ThePil0t/heichips26-FAIfplus/macros/heichips26_FAIf/macros/analogue_interface/README.md

# analogue_interface: analog hard macro (ihp-sg13cmos5l)

<p align="center">
  <a href="final/render/analogue_interface_white.png">
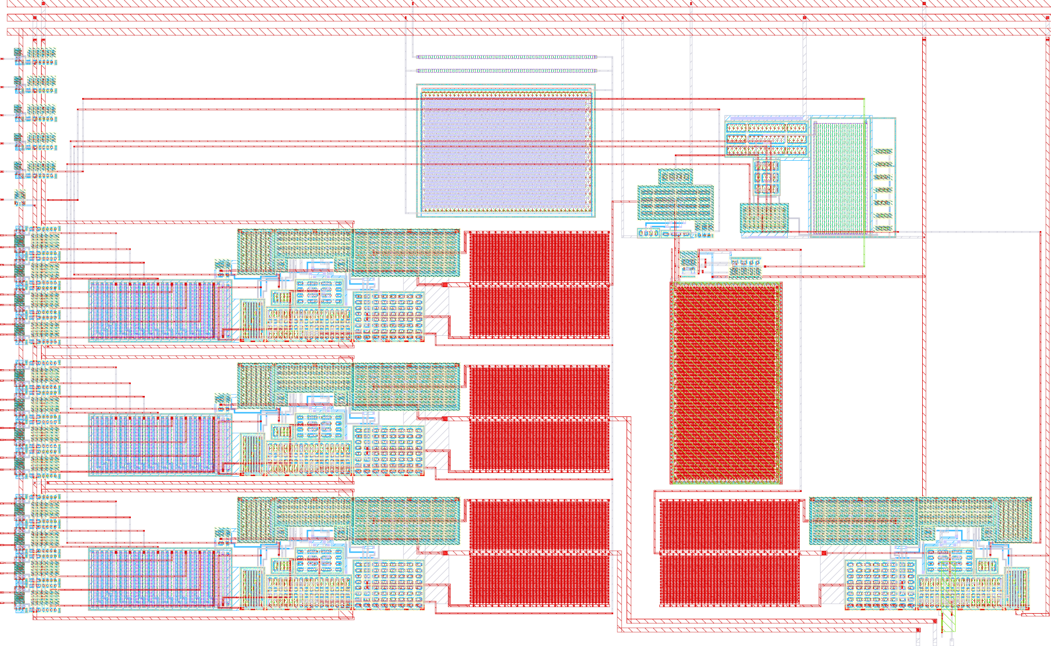
[picture p1: macros/heichips26_FAIf/macros/analogue_interface/final/render/analogue_interface_white.png]
Render of the dry-run analogue_interface macro
    
  </a>
  <br>
  <em>Render of the dry-run macro. The render shows mask layers only, so the dummies (outline + text) are not visible.</em>
</p>

This is the analog hard macro that `heichips26_FAIf` instantiates as `analogue_interface`.

- The analog blocks of [`heichips26_FAIf.sch`](../../schematic/xschem/heichips26_FAIf.sch) are placed with their GDS as it is.
- The iVREF divider (R1, R2, C1) is generated from the PDK PCells.
- **Fully routed** (see [Routing](#routing)): DAC path, ADC path, PTAT, level translators and supplies. The macro KLayout LVS against the generated reference schematic matches.

Everything is generated by [`scripts/build_analogue_interface.py`](scripts/build_analogue_interface.py) from one placement and pin table. Do not edit the GDS by hand; change the table and rebuild. The plan behind this macro is [`analogue_interface_dummy_PLAN.md`](../../../../analogue_interface_dummy_PLAN.md).

## Build

```sh
nix-shell
export PDK_ROOT=$(pwd)/IHP-Open-PDK && export PDK=ihp-sg13cmos5l
make -C macros/heichips26_FAIf/macros/analogue_interface build-top
```

| Target | Output |
|---|---|
| `layout` | `layout/analogue_interface.gds`, `final/lef/`, `final/vh/` (Verilog blackbox header), `final/lib/` (timing-free Liberty) |
| `copy-gds` | `final/gds/analogue_interface.gds` |
| `render-gds` | `final/render/*.png` |
| `build-top` | all of the above |
| `klayout-drc` | `verification/drc/` (KLayout DRC, `DRC_LEVEL=macro` by default) |
| `reference-schematic` | regenerates `schematic/xschem/analogue_interface.sch/.sym` (LVS reference) from the top schematic |
| `klayout-lvs` | `verification/lvs/` (KLayout LVS against the reference schematic) |

`layout` and `reference-schematic` need `PDK_ROOT` and `PDK` (the divider PCells come from the PDK library).

The script stops with an error if a block leaves the macro, two blocks are closer than 3 µm, anything is drawn above Metal3, a pin label cannot be found, a route comes too close to block metal or another net, or a routed net is split or shorted (metal-only connectivity check).

## Geometry

- **Size:** 300 × 185 µm, 1 nm dbu, `prBoundary` at (0,0)–(300,185).
- **Layers:** Metal1–Metal3, with one exception: the **Metal4 lid (VSS) over the hold cap of `sah_12bit`** (x10) and its Via3 rows. Otherwise there is no Via3/Metal4/TopMetal1, so the top-level Metal4 PDN straps can run across the macro.
  - The build script allows Via3/Metal4 only inside the lid. The Metal4 PDN strap groups over the macro sit at x 172.38–179.38, 222.38–229.38 and 272.38–279.38 (measured in `final/gds/heichips26_FAIf.gds`, 2026-10-08).
  - LibreLane removes every Metal4 strap within `PDN_HORIZONTAL_HALO` = 10 µm of a Metal4 obstruction. The script therefore asserts that the lid's obstruction (lid + 1 µm) is ≥ 10.5 µm from the **west group (172.38–179.38), which stays intact**. Today it is 10.5 µm (obstruction at x 189.88).
  - The east group (222.38–229.38) is cut over the S&H; the lid keeps the ≥ 0.6 µm Metal4 spacing to it.
  - The LEF obstructs Metal1–Metal3 over the whole macro except the pins, and Metal4 over the lid + 1 µm. The rest of Metal4 is not obstructed.
- **Cell names:** every subcell is prefixed `heichips26_FAIf_` for chip-level uniqueness. This also removes the leading digit of `555_comparator`. The top cell is `analogue_interface`, the module name used in `rtl/heichips26_FAIf.sv`.
- **Location in `heichips26_FAIf`:** (190, 8.82), orientation N (`DIE_LOCATION` in the build script). The macro then covers die x 190–490 and y 8.82–193.82, and leaves x < 180 (after the 10 µm horizontal macro halo) for the digital logic.
  - **x = 190:** only at this x are `analog_0..2` directly above the die pins of `heichips26_template_small_analog` (x = 450.24 / 455.04 / 459.84).
  - **y = 8.82:** this keeps the bottom cell row (y 3.78–7.56) free, together with `FP_MACRO_VERTICAL_HALO: 1` and `PDN_VERTICAL_HALO: 1`. That row's power rails are the only link between the Metal4 straps over the macro and the rest of the power grid. 8.82 is a multiple of 0.42 µm, so the west-edge pins stay on the Metal3 tracks.

```
y=185 ┌─────────────────────────────────────────────────────────────────────┐
      │ VAPWR / VGND / VPWR pin straps (Metal3, x 2–298)                    │
  172 ├──────┬───────────────────────────────────┬──────────────────────────┤
      │ 4×LT │                                   │          PTAT x3 (MX)    │
      │ x9 LT│              R1/R2/C1 (iVREF)     │  x1 comp                 │
  124 │ x2 ↓ │                                   │──────────────────────────│
      │LT8 x6│ R2R DAC x4 (SAR DAC)              │ S&H sah_12bit x10        │
   86 │LT8 x7│ R2R DAC x5 (DAC0 → analog_1)      │                          │
   48 │LT8x12│ R2R DAC x11 (DAC1 → analog_0)     │ opamp x8 (mirrored)      │
   10 │      │                                   │                          │
    0 └──────┴───────────────────────────────────┴───────────▲▲▲──────────┘
       west edge: digital pins (Metal3)          analog_0/1/2 (Metal2)
```

Why the blocks sit where they do:
- **West column:** all level translators face the digital logic, so the VPWR domain stays in this one column.
- **DAC rows:** each 8× translator is rotated R90 next to its DAC row, with its LIN inputs facing west and its nLOUT outputs facing the DAC's nD inputs.
- **East column:** the ADC front end sits next to the analog pins. The opamp is mirrored so its IOAP input is directly above `analog_0..2`.
- **Comparator:** at y 115.5, as close to the SAR DAC as its strap slot allows (7.8 µm from x4), with INN straight above the S&H's SH_OUT spine. It sits 3 µm above the S&H top (y 112.5).
- **S&H (x10):** between the opamp and the comparator. The hold cap sits in the strap slot x 179.4–222.4, 10.5 µm from the west strap group. The switch (TG) sits on top of the cap, east of the SH_OUT spine, with room for a T-switch next to it; the gate driver runs east of that. SH_IN leaves on the east edge, away from the DAC routes on the west.
- **PTAT (x3):** east of the comparator at y 115.5, mirrored (MX) so its outputs (CSOUT1–4, PBIAS) face down, next to the comparator's PBIAS. iIREF2–4 run west to the DACs, iIREF1 down to the opamp (ADC round).

## Blocks

Coordinates are macro-local in µm and give the lower-left corner of each placed block.

| Inst | Part | Source layout | Orient | Lower-left | Size (µm) | Status |
|---|---|---|---|---|---|---|
| x12, x7, x6 | 8x inverting level translator | `../8x_inverting_digital_level_translator/layout/8x_inverting_digital_level_translator.gds` | R90 | (4, 9.35), (4, 47.35), (4, 85.35) | 13.145 × 33.61 | KLayout DRC/LVS clean (cell) |
| x11, x5, x4 | R2R DAC with output opamp | `../r2r_dac/layout/r2r_dac.gds` | R0 | (25, 10), (25, 48), (25, 86) | 147.82 × 32.315 | KLayout DRC/LVS clean (cell) |
| x3 | PTAT current source | `../ptat_current_source/layout/ptat_curr_gen.gds` | MX | (205.43, 115.5) | 48.58 × 34.80 | KLayout DRC/LVS clean (cell); not routed yet (with the ADC round) |
| x2 | down translator (`adc_comp`) | `../down_digital_translator/layout/down_digital_translator.gds` | MY | (4, 124.5) | 3.24 × 4.90 | layout, unverified |
| x9 | level translator (`adc_hold`) | `../digital_level_translator/layout/digital_level_translator.gds` | R0 | (4, 132.4) | 12.12 × 5.05 | layout, unverified |
| xcap0–3 | level translator (`sh_cap_en[0..3]`) | same as x9 | R0 | (4, 140.45 / 148.5 / 156.55 / 164.6) | 12.12 × 5.05 | **not in the top schematic yet** |
| x8 | opamp (S&H input buffer) | `../opamp/layout/op_amp_ver_2.gds` | MY | (187, 10) | 105.66 × 32.29 | layout, unverified |
| x10 | sample-and-hold `sah_12bit` | `../sah_12bit/layout/sah_12bit.gds` | R0 | (179.2, 45.5) | 43.0 × 67.0 | layout, DRC/LVS clean (cell) |
| x1 | comparator | `../comparator/layout/555_comparator.gds` | R0 | (180.63, 115.5) | 21.80 × 19.81 | layout, DRC/LVS clean |
| R1, R2 | rhigh w=0.5 µm l=50 µm b=0 (≈ 148 kΩ), PDK PCell | generated (`macro_routing.make_divider_cells`) | R90 | (118, 166.4), (118, 162.5) | 51.22 × 0.90 | routed |
| C1 + C2 | iVREF filter block: MOM cap C1 (cap_cmomi, Metal1–Metal2, w 31.79 × l 47.16 µm as extracted, ≈ 0.75 pF) on top of the HV NMOS cap C2 (sg13_hv_nmos W 33.5 × L 48 µm, G = iVREF, S/D/B = VGND, ≈ 8 pF), p-tap ring (VGND); Metal3 above stays free | generated (`macro_routing.make_divider_cells`) | R0 | (118, 121.4) | 50.8 × 37.9 | routed |

The divider devices come from the PDK PCell library (`SG13_dev`, loaded through `sg13cmos5l_pycell_lib`), converted to static, flattened cells. C1 is only ≈ 45 fF with the schematic values; check whether that is enough filtering for iVREF.

xcap0–3 are needed because the trimmed S&H's `cap_en` runs in the 3.3 V domain, while every digital-side pin of the macro is in the 1.2 V domain.

The r2r_dac GDS carries a TopMetal1 text label (`ODACOUT`, 126/25). The build script strips it, because TopMetal1 must stay empty.

## ADC front end: opamp x8 → S&H x10 → comparator x1

| Net | From | To | Route (macro) |
|---|---|---|---|
| SH_IN | opamp OOA, west end of its Metal3 strip (187.01, 26.3) | S&H pin `SH_IN`, east edge (222.2, 112.25) | Metal3 0.4 µm west of the opamp up to y 43.9, east under the S&H (y 43.9), Metal2 riser at x 227, Metal3 into the pin. The opamp loop OOA → IOAM is closed on Metal3 inside x8 |
| SH_OUT (hold node, `iSAR_AN`) | S&H pin `SH_OUT`, top edge (191.43, 112.5) | comparator INN, Metal3 pad (191.43, 125.2) | 12.7 µm straight up on Metal3 (9.7 µm of it inside the comparator) |
| VSS | S&H pin `VSS`, top edge (192.43, 112.5) | comparator GNDA (south edge, Metal1, y 115.54–116.32) | 3 µm hop up next to SH_OUT, then to VGND |
| iSAR_DAC | x4 ODACOUT, east edge (172.82, 102.3) | comparator INP, Metal3 pad (191.53, 125.87) | Metal3 x 173.4–173.8 up to y 125.87, then east into INP |
| SH_EN | x9 LOUT (13.09, 134.42, Metal2) | S&H pin `SH_EN`, inside the cell (216.9, 107.5), Metal3 | Metal2/Metal3 east to x 23.5, Metal2 up, Metal3 east at y 155, **Metal4 down at x 245**, Metal3 west into the pin. It crosses SH_IN once at right angles (Metal3 over Metal2, x 227) |
| VDD | S&H pin `VDD`, inside the cell (202.0, 104.6), Metal3 | VAPWR | Metal3 east at y 104.6 to the east VAPWR trunk (x 262); crosses SH_IN at right angles |

Routing rules (see `../sah_12bit/README.md`):
- SH_OUT is a direct Metal3 hop to INN; nothing runs alongside it except the VSS hop.
- iSAR_DAC splits the channel x 172.82–179.2 from the DAC edge (y 102.3) up to the comparator. So SH_EN comes in from the south through the x5/x4 corridor and never crosses iSAR_DAC.
- SH_IN, SH_OUT, SH_EN and iSAR_DAC don't cross anywhere. SH_IN enters from the east, so the DAC routes (analog_1 at x 178.3, analog_0 at x 175.6) stay ≈ 44 µm away from it.
- The comparator OUT (SE corner) is routed east and north around the comparator, never west across iSAR_DAC or along the SH_OUT hop.
- No routing over the S&H on Metal1–Metal3 (LEF obstruction) or over its lid on Metal4 (LEF obstruction).

## Routing

All routes are generated by [`scripts/macro_routing.py`](scripts/macro_routing.py) from the pin labels of the placed blocks, into the cell `heichips26_FAIf_routing`. Signals use Metal2/Metal3 (0.30 µm, 0.19 µm vias with 0.30 µm pads). The builder runs two checks before it writes the GDS: a clearance check of every route against the block metal and between nets, and a metal-only connectivity check (every routed net is one Metal1–Metal3 island, no two routed nets touch).

| Net | Route |
|---|---|
| `dac_out[15:0]` | Metal3 stub from the west pin to LINk of x12/x7, Via2 down |
| translator → DAC bits | Via2 at nLOUTk, Metal3 east along the nLOUT row; bits 0–3 drop on Metal2 onto the nD pad stack, bits 4–7 go up on Metal3 (staircase, no crossings) |
| iVREF | R1/R2/C1 east ends → Metal2 trunk at x 173.6 → along the row gap under x11/x5/x4 on Metal3 → into the R2R at x ≈ 123.5 (between the opamp POAVSS rail end and the output stage) → west at R2R + 2.5 → up onto IDACVTAP |
| `analog_1` / `analog_0` | Metal3, 1.2 µm, from the opamp OOA bar at the R2R east edge: down at x 178.3 / 175.6, east at y 7.0 / 4.5, Via2 array + Metal2 onto the south pins |
| IDACDISABLE (x11, x5) | Metal3 west to x 61.9, down, onto the opamp POAVSS rail (VGND) |
| VPWR / VGND / VAPWR | Metal3 trunks continue the translator supply bars (x 5.35–6.46 / 9.29–10.40 / 11.70–12.81) up to the straps; VGND and VAPWR cross the lower straps on Metal2. Metal3 rails in the row gaps feed the R2R opamp rails (x11, x5, x4); VGND hops under the VAPWR trunk on Metal2 |
| R1 / R2 / C1 | west ends: Metal2 risers to VAPWR (x 117) and VGND (x 115) |

Round 2 (ADC path, PTAT, small translators, supplies; `route_rest`):

| Net | Route |
|---|---|
| `adc_ref`, x6 → x4 bits, x4 IDACDISABLE | same pattern as the DAC pairs |
| iSAR_DAC, SH_OUT, VSS, SH_IN, SH_EN, S&H VDD | see the ADC front-end table above |
| analog_2 → x8 IOAP (ADC input) | Metal3 straight down from IOAP through a gap in the opamp's bottom VGND Metal3 rail (x 266.85–271.49, cut in the macro's copy of the opamp; both halves stay VGND through the opamp), Via2 at y ≈ 9, Metal2 into the pin. Guarded by a VGND Metal2/Metal3 strap at x 267.06 (towards analog_1, tied to the opamp's VGND Metal2) and a vertical VGND Metal4 shield (x 266.91–270.84, y 4.04–23.9) |
| iIREF1 (CSOUT1) → x8 IOAIREF | Metal3 down to y 117.3, Metal2 east outside the PTAT, Metal3 down the east edge (x 295) and west at opamp bottom + 19.2 into IOAIREF |
| iIREF2/3/4 (CSOUT2/3/4) → IDACIREF of x4/x5/x11 | Metal3 west at y 141.5 / 143 / 136.5, Metal2 down the west channel (x 21 / 20 / 19), Metal3 east at R2R + 19.2 |
| iPBIAS | PTAT PBIAS → Metal3 at y 139 → Metal2 drop onto the comparator PBIAS |
| iSAR_COMP | comparator OUT → Metal2 north in the gap to the PTAT (x 203.9) → Metal3 west at y 152 → x2 DIN |
| `adc_comp`, `adc_hold`, `sh_cap_en[3:0]` | Metal2 stubs from the west pins (the LIN pins sit under the VPWR trunk) |
| small translators (x2, x9, xcap0–3) supplies | Metal1 taps with via stacks onto the west trunks |
| comparator VCCA / GNDA | Metal2 risers to the VAPWR strap (at the VCCA pin) and the VGND strap (x 176.5); the S&H VSS hops onto GNDA |
| east supplies | VAPWR trunk (Metal3, x 262): S&H VDD, PTAT PCSVDD, opamp POAVDD; VGND trunk (Metal3, x 297): opamp POAVSS and IOADISABLE; PTAT PCSVSS Metal2 riser down to the VGND strap |

**Metal4:** only vertical routes, off the S&H lid, with the lid's strap rules: ≥ 0.6 µm from every PDN Metal4 strap and ≥ 10.5 µm (obstruction incl. halo) from the strap group at x 172.38–179.38, which must stay intact (LibreLane removes straps within 10 µm of a Metal4 obstruction). Users: SH_EN (x 245) and the analog_2 shield (x 266.91–270.84, 1.5 µm from the strap group at x 272.38, which LibreLane may therefore cut near the macro bottom). The builder asserts this and adds each Metal4 route (+ 1 µm) to the LEF obstruction.

**LVS:** the reference schematic [`schematic/xschem/analogue_interface.sch`](schematic/xschem/analogue_interface.sch) is generated by [`scripts/gen_reference_schematic.py`](scripts/gen_reference_schematic.py) from the analog part of the top schematic (x1–x12, R1, R2, C1, C2, plus the spares xcap0–3), with the nets renamed to the macro ports. `make klayout-lvs` matches (sign-off check for the macro).

## Pins

| Pin | Dir | Layer / edge | Connects to (once routed) |
|---|---|---|---|
| `adc_ref[7:0]` | in | Metal3, west | LIN0–7 of x6 → SAR DAC x4 |
| `adc_hold` | in | Metal3, west | LIN of x9 → S&H `SH_EN` |
| `adc_comp` | out | Metal3, west | DOUT of x2 ← comparator x1 |
| `dac_out[7:0]` | in | Metal3, west | LIN0–7 of x7 → DAC0 x5 |
| `dac_out[15:8]` | in | Metal3, west | LIN0–7 of x12 → DAC1 x11 |
| `sh_cap_en[3:0]` | in | Metal3, west | LIN of xcap0–3 → S&H `cap_en[3:0]` |
| `analog_0` | inout | Metal2, south, x 259.74–260.74 | DAC1 x11 output |
| `analog_1` | inout | Metal2, south, x 264.54–265.54 | DAC0 x5 output |
| `analog_2` | inout | Metal2, south, x 269.34–270.34 | opamp x8 IOAP (ADC input) |
| `VPWR` | power | Metal3 strap, y 173–175 | 1.2 V, level translators |
| `VGND` | ground | Metal3 strap, y 177–179 | all blocks |
| `VAPWR` | power | Metal3 strap, y 181–183 | 3.3 V, analog blocks |

Each west-edge pin is 1.0 × 0.4 µm and sits at the height of the block input or output it will connect to. All pins are drawn on drawing, pin and text datatypes (e.g. 30/0, 30/2, 30/25), as in the template floorplans.

The LEF declares `USE POWER` for VPWR and VAPWR and `USE GROUND` for VGND. The Liberty has no timing arcs; it defines `voltage_map` VPWR 1.2 V, VAPWR 3.3 V and VGND 0 V.

## Known issues (not fixed in this version)

- **PTAT:** the GDS predates `ptat_curr_gen_mod1`. It has `CSSTARTUP`, but no `CSOUT4` and no `PBIAS`, and the GDS cell is named `ptat_curr_gen`. The symbol `ptat_curr_gen_mod1.sym` also declares `CSOUT3` twice, which shorts iIREF3 and iIREF4 in the top schematic.
- **Verification:** no block has an LVS result, and only r2r_dac has DRC reports. In r2r_dac the `IDACIREF` label is missing.
- **DRC (`make klayout-drc DRC_LEVEL=macro`, 2026-10-04): 12 errors, all inside existing blocks.** None come from the placement, the pins or the dummies.
  - `CMOS5L.FORB.nBuLay` ×8 in `ptat_curr_gen`: the PTAT draws an nBuLay ring (32/0) around x 5.6–18.2, y 24.9–33.2, and nBuLay is forbidden in the CMOS5L stack. This has to be fixed in the PTAT layout.
  - `Act.b` ×4 in `down_digital_translator`: Activ space below 0.21 µm near y 3.8–3.9.
- **Schematic:** the top schematic still uses the untrimmed `sample_and_hold.sym` and has no translators for `cap_en`.
- **RTL:** `rtl/heichips26_FAIf.sv` ties `sh_cap_en` to `4'b0000` until the config register exists.
- **Location-dependent pins:** the analog pins only line up with the die pins, and the west-edge pins only sit on the Metal3 tracks, at location (190, 8.82). Change `DIE_LOCATION` and rebuild if the macro moves.
- **Metal4:** apart from the `sah_12bit` lid, SH_EN and the analog_2 shield (obstructed), it is not obstructed, so top-level signal routes may cross the analog blocks. The Metal4 keep-out plan is still open (TAPEOUT_PLAN §5.4).

## LibreLane integration

The macro is used in `../../flow/librelane/config.yaml`:
- `FP_DEF_TEMPLATE: dir::heichips26_template_small_analog.def`;
- a `MACROS: analogue_interface` entry with the `final/` views and the instance at `[190, 8.82]`, orientation `N`;
- `VDD_NETS: [VPWR, VAPWR]` and `GND_NETS: [VGND, VGND]`;
- `FP_MACRO_VERTICAL_HALO: 1` and `PDN_VERTICAL_HALO: 1`.

The power pins are connected through the RTL: the instance in `rtl/heichips26_FAIf.sv` connects `VPWR`, `VAPWR` and `VGND` under `USE_POWER_PINS`. The placeholder `rtl/analogue_interface.sv` is used only for lint and simulation, not for synthesis.

The full flow runs through, and only DRC errors inside the analog blocks remain. See `TAPEOUT_TODO_PLAN.md` at the repo root.
