ThePil0t/heichips26-FAIfplus/sah_12bit_sizing_PLAN.md

# Plan: hold-capacitor sizing for 12 bit in a new macro `sah_12bit`

## Context
The hold capacitor in `sample_and_hold` (fixed C1 ≈ 978 fF) and `sample_and_hold_trim` (0.23–2.9 pF, 4-bit array) was picked by hand. This plan sizes it from first principles for **12-bit performance only**:
- identify the limits on accuracy and speed;
- size first with an ideal source (infinite drive), then with `op_amp_ver_2` as the unity-gain buffer;
- size it untrimmed;
- decide whether a trim capability is worth it.

All changes go into a **new macro `sah_12bit`**. The existing `sample_and_hold`, `sample_and_hold_trim`, `aswitch`, opamp, comparator and top level stay untouched. Speed is an **output**: C is sized for accuracy, and the study reports the reachable track time, hold time and fs.

**Facts the sizing relies on**
- **Process and supply:** PDK `ihp-sg13cmos5l`. The only capacitor is the MOM `cap_cmomi`: 0.82 fF/µm² of active area for M1–M3, about 0.78 fF/µm² drawn. It has no mismatch, corner, TC or VC model, and adds a `GLEAK`=1e-12 S leak to substrate on each terminal. All devices are HV at 3.3 V. FS = 3.3 V, the same as the DAC reference.
- **Topology:** `op_amp_ver_2` follower → HV transmission gate (N 4/0.6, P 14/0.6, half-size dummies, ≈1 kΩ) → C to VSS → `555_comparator` INN (HV PMOS, 2×5/0.45). Sampling is single-ended on the top plate. The hold cap is **not** part of a ratio (it is not a CDAC), so its value does not enter the transfer function.
- **Opamp at 25 nA:**
  - Slew rate ≈ 0.24–0.4 V/µs, with Cc = 2×422 fF and a class-AB output.
  - Output swing 0.39–3.3 V.
  - GBW, gain and PM were never simulated; my estimate is a GBW of 0.5–1 MHz.
- **Existing trim TB data (27 °C):**
  - At 0.23 pF: pedestal 3.7–9.4 mV, droop up to 101 mV/ms (≈ 23 pA).
  - At 2.9 pF: droop ≈ 21 mV/ms (≈ 61 pA), because the trim switches add leakage.

## 12-bit error budget
- **LSB and noise:** LSB = 3.3 V / 4096 = 806 µV. Quantization noise q = LSB/√12 = 233 µV.
- **Total noise:** σ ≤ q. kT/C gets half of the noise power, so σ_kTC ≤ 165 µV; the rest goes to the opamp, comparator and DAC.
- **Deterministic errors:** each of the following must stay ≤ ¼ LSB = 201 µV in the worst case over Vin, temperature (−40/27/125 °C) and corners tt/ss/ff/sf/fs:
  - settling;
  - the nonlinear part of the pedestal;
  - droop over t_hold;
  - comparator kickback;
  - hold feedthrough.
- **Offset and gain:** the constant and linear parts of the pedestal and of the opamp gain error are reported separately. They are calibratable and not counted as INL.
- **Capacitor spread:** at least ±35 % on the hold cap. This is a lower bound, used because the `cap_cmomi` model carries no process spread (typ = bcs = wcs, no mismatch); replace it if real process data appears.
  - All accuracy limits (kT/C, follower noise, kickback, pedestal, droop) must hold at **C_nom × 0.65**.
  - Speed limits (acquisition, ideal-source t_track, stability) must hold at **C_nom × 1.35**.
  - The spread applies only to the drawn MOM cap. The switch and comparator parasitics (≈ 0.05 pF) are counted unscaled.

## Limits and first-cut numbers (hand estimates; simulations replace them)
**A. Ideal source (infinite drive)**

| Mechanism | Scaling law | 12-bit first cut |
|---|---|---|
| kT/C noise | C ≥ 2kT/q² | ≥ 0.15 pF at 27 °C, ≥ 0.20 pF at 125 °C |
| Charge injection, nonlinear part (switch scaled with C) | ΔV·τ ≈ k_res·L²/(2µ) ≈ k_res·3.4 ps·V (HV, L = 0.5 µm). This is set by the **track time**, not by C | τ ≥ k_res·17 ns, so t_trk ≥ k_res·164 ns |
| Charge injection with today's switch | ∝ 1/C | ≈ 1–2 pF (from the existing TB data) |
| Droop | C ≥ I_leak·t_hold / (¼ LSB) | ≈ 0.11 pF per µs of hold (23 pA, 27 °C); higher at 125 °C |
| Comparator kickback | C ≥ Q_kb / (¼ LSB) | to be simulated |
| Hold feedthrough | C_ds,off / C, must be < −84 dB | already −118 dB at 0.23 pF |
| Settling | t_trk = 9.7·Ron·(C + C_par) | sets the switch W |
| Tracking distortion and aperture | Ron(Vin) variation × C × 2πf_in; gate fall time × Vin/VDD; jitter | limits f_in, not C; jitter must be ≤ 1.3 ns at 25 kHz |
| Area | 0.78 fF/µm² | about 2.6k µm² for 2 pF |

k_res is the remaining fraction of the nonlinear charge injection after CMOS and dummy cancellation. It comes from simulation.

**B. With op_amp_ver_2 as the buffer (additional limits)**
- **Slew rate:** SR ≈ I_tail/Cc. A full-scale input step takes 7–12 µs, and a full-scale sine is limited to about 26 kHz. This does not depend on C.
- **Recharging C at the start of track:** this goes through the class-AB output's local Miller loop, τ ≈ C/gm_out,large-signal. The existing results are 12 ns at 0.23 pF and about 200 ns at 2.9 pF.
- **Small-signal settling:** 9.7/(2π·GBW), i.e. about 1.5–3 µs.
- **Stability:** the output pole gm_out,q/(2πC) must stay above about 2×GBW. This sets an upper limit on C, estimated in the 5–10 pF range.
- **Opamp noise sampled on C:** about α·kT/Cc ≈ 70–120 µV rms. This uses up much of the 12-bit noise budget, so the simulation must verify it.
- **Gain nonlinearity:** the measured tracking error varies by 40 µV, which is fine (budget 201 µV).
- **Swing floor at 0.39 V:** this reduces the usable full scale, and the report states it.

## New macro `macros/heichips26_FAIf/macros/sah_12bit/`
- **Skeleton:** copy from `sample_and_hold/`, i.e. the Makefile, README.md, `scripts/` (sak-*, lay2img, check_pex_ports), and `schematic/xschem/xschemrc` and `testbenches/xschem/xschemrc`.
  - Set `TOP = sah_12bit`.
  - In the xschemrc files, add library paths to `../../../opamp/schematic/xschem` and `../../../comparator/schematic/xschem`. The TBs need these.
  - Leave out the template inverter TBs and CACE yaml.
- **`schematic/xschem/sah_12bit.sch` and `.sym`:**
  - The pins match `sample_and_hold.sym` (SH_IN, SH_OUT, SH_EN, VDD, VSS) so the cell can drop into the top level later.
  - The transmission gate, its dummies and the gate inverter are placed **directly in this cell** with the new sizes. `aswitch` keeps its current sizes, because `asw_inv`, `sample_and_hold` and an opamp TB also use it.
  - The hold cap is `cap_cmomi` (M1–M3).
  - During the study the sizes are parameters (`wn`, `wp`, `cw`, `cl`), and they are frozen at the end.
- **`testbenches/xschem/`:** the testbenches listed under Steps.
- **`scripts/sizing/cs_sizing.py`:** numpy and matplotlib, both available in nix-shell; pygmid and scipy are not.
- **`docs/hold_cap_sizing.md`:** the report.

## Steps
0. **Save this plan first.** Copy this plan unchanged to `sah_12bit_sizing_PLAN.md` at the repo root, next to `TAPEOUT_PLAN.md`. Commit only that file on branch `benedikt`, with the message "Add sah_12bit_sizing_PLAN.md". The untracked `rtl/gen/` stays out of the commit. Nothing is pushed unless you ask. No other work starts before this commit.
1. **Set up the macro.** Create the skeleton, plus a first `sah_12bit.sch` and `.sym` with the parametrized transmission gate and cap.
2. **Analytic sizing script, `cs_sizing.py`.**
   - It encodes the budget and the scaling laws above.
   - It reads the `.txt` results from steps 3–5.
   - It outputs:
     - C_min for each mechanism;
     - the switch W;
     - t_trk, t_hold and fs versus C, for the ideal source and for the opamp.
3. **Ideal-drive characterization, `sah_12bit_ideal_tb_{dc,tran,noise}.sch`.** These follow the pattern of `sample_and_hold_trim_tb_tran.sch` (a control block with `foreach`, `alterparam` and `meas`, writing a `.txt`). The source is ideal (0 Ω).
   - DC: Ron(Vin).
   - Transient sweeps: Vin 0.1–3.2 V (16 points) × ideal C {0.25, 0.5, 1, 2, 4 pF} × switch scale × gate fall time {0.1, 1, 5 ns} × temperature × corner.
   - Transient outputs:
     - Q_inj(Vin) = ΔV·C, split into offset, gain and nonlinear residual; the residual gives k_res.
     - I_leak(Vin, T), with the GLEAK artifact separated out.
     - Full-scale step acquisition time to ¼ LSB.
     - Hold feedthrough.
   - `.noise`: check kT/C.
4. **Buffer characterization, `sah_12bit_opamp_tb_{ac,noise,dc,tran}.sch`.** The chain is op_amp_ver_2 follower → sah_12bit → real `555_comparator`.
   - `.ac` loop gain with a loop-break probe, for C from 0.25 to 16 pF: GBW and PM, which give the upper limit on C.
   - `.noise` integrated at SH_OUT in track mode.
   - DC sweep: follower INL.
   - Transient: acquisition for a full-scale step and for a small step, and the pedestal with the real source impedance.
   - IBIAS sweep {25, 50, 100 nA}: shows how much bias would buy, without changing the opamp schematic.
5. **Comparator kickback, `sah_12bit_kickback_tb_tran.sch`.** Drive INP with a 12-step SAR binary-search staircase. Measure the disturbance on C per decision and its dependence on the decision history.
6. **Choose the sizes.** C = max over all mechanisms with margin, limited from above by the opamp's stability. Then:
   - pick the switch W from the settling budget;
   - freeze them in `sah_12bit.sch`;
   - report the reachable fs for the ideal source and for the opamp, at 25 nA and at the swept biases.
7. **Trim evaluation, `sah_12bit_trim_cmp_tb_tran.sch`.** This instantiates the existing `sample_and_hold_trim.sym` read-only, next to `sah_12bit` with the same total C.
   - Run all 16 codes at −40/27/125 °C.
   - Compare:
     - the nonlinear pedestal;
     - droop and leakage;
     - the two-time-constant settling tail (trim-switch Ron × C_trim, then charge redistribution after hold);
     - memory from floating disabled caps.
   - The MOM spread is not modelled, so sweep the cap size by ±15 % by hand.
   - **Current assessment, to be confirmed by simulation:** in a voltage-mode S&H, trimming C corrects no error. It only moves the speed/accuracy point, and process spread can be covered by margin. Meanwhile the array more than doubles the leakage, adds a settling tail and nonlinear junction capacitance, and its codes are non-monotonic (C4 = C5).
   - **Expected recommendation:** use a fixed C. If speed/accuracy flexibility is wanted, make the SAR acquisition time programmable (the prescaler already planned in TAPEOUT_PLAN). If a trim is kept, put the switches at the bottom plate (NMOS to VSS) and use binary weights.
8. **Report, `sah_12bit/docs/hold_cap_sizing.md`.** It contains the budget table with the simulated values, the chosen C and W, the speed results, and the trim verdict. The plots go to `testbenches/xschem/plot_simulations/figures/`.

## Reused
- `sample_and_hold_trim/testbenches/xschem/sample_and_hold_trim_tb_tran.sch`, for its measurement definitions and stimulus pattern.
- `plot_simulations/ngspice2python.py`, for parsing `.raw` files.
- `op_amp_ver_2.sym` and `555_comparator.sym`, as symbols only.
- `sample_and_hold_trim.sym`, used read-only for the trim comparison.

## Verification
- **Running the sims:** start `nix-shell`, then `export PDK_ROOT=$PWD/IHP-Open-PDK PDK=ihp-sg13cmos5l`, then `make sim-xschem TB=<tb>` in `sah_12bit/`.
- **Cross-checks:**
  - The `.noise` result must match kT/C within 5 %.
  - ΔV·C must collapse onto one Q_inj(Vin) curve across the C sweep.
  - `sah_12bit`, set to today's switch sizes at 0.23 pF and 2.9 pF, must reproduce the existing trim TB numbers.
- **Final check:** a closed-loop transient of opamp → `sah_12bit` → comparator with the frozen sizes, at tt/ss/ff and −40/27/125 °C. Every deterministic error must be ≤ ¼ LSB, and the noise must fit the budget.
- **Out of scope** (can be done later on request): swapping `sah_12bit` into the top level, and layout.

---

## Resume: status as of 2026-10-02 and remaining work

### Done
- **Steps 0–6 are done.** The plan is committed as 2233d79. Everything else under `macros/heichips26_FAIf/macros/sah_12bit/` is uncommitted.
- **Cell changes made along the way:**
  - The ideal-source sweep showed that today's switch has a pedestal nonlinearity of about 17 mV, against a 0.2 mV budget. Two causes: the PMOS dummies switch before their main device, and the NMOS gate sees the raw SH_EN slope.
  - The cell therefore got a gate-driver chain SH_EN → I1 → I2 (sw) → I3 (sw_b) → I4 (sw_d). Each dummy now switches after its main device. This cut the pedestal by 3–50× and made it independent of the input edge rate.
- **Frozen cell** `schematic/xschem/sah_12bit.sch/.sym`, plain numbers, no parameters:
  - NMOS 0.6 µm (2 fingers), PMOS 1.8 µm (2 fingers), L = 0.45 µm, dummies = one finger;
  - C1 = `cap_cmomi` 48.95 × 25.2 µm (M1–M3) = 0.993 pF, the same area as today's C1. **Superseded:** C1 is re-sized to 1.21 pF for the ±35 % cap spread (see below).
  - The parametrized copy for the sweeps is `testbenches/xschem/sah_12bit_param.sch/.sym`.
- **Testbenches:** all of `ideal_tb_{dc,noise,tran}`, `opamp_tb_{ac,noise,dc,tran,ped}`, `kickback_tb_tran`, `trim_tb_tran` and `final_tb_tran`.
  - The sweeps use `cap_cmomi_lf.spice` (the same C equations without the RF network and the GLEAK artifact; about 30× faster).
  - The Makefile has `sim-xschem-pvt` (runs the PVT points in parallel), `sizing` and `sim-all`.
  - `scripts/sizing/cs_sizing.py` evaluates everything and writes the `sah12_*.png` figures.
- **Results so far (12 bit: LSB 806 µV, ¼ LSB = 201 µV, q = 233 µV):**

| Mechanism | Result | Minimum C |
|---|---|---|
| kT/C | `.noise` matches kT/C_eff within 1–4 % (1 and 4 pF) and 5–11 % (0.3 pF) | 0.20 pF (125 °C) |
| Follower noise sampled on C | 178–200 µV (27 °C), 199–234 µV (125 °C), almost independent of C → **the opamp dominates** | 0.28 pF (≤ q at 125 °C) |
| Comparator kickback | worst 0.124 fC → 121 µV at 1 pF | **0.62 pF (binding)** |
| Pedestal nonlinearity, opamp drive, 0.6/1.8 switch | ≤ 0.049 mV over 9 PVT points at 1 pF | 0.16 pF |
| Opamp stability | phase margin 64–76° even at 16 pF | no limit |
| Follower static error | offset 0.12–2.3 mV, gain error ≈ 20 ppm, nonlinearity ≤ 86 µV | – |
| Acquisition with the opamp (½ FS step, ¼ LSB) | 1.26 µs at 25 nA, 0.67 µs at 50 nA, 0.36 µs at 100 nA (at 1 pF; weak C dependence) | – |
| Ideal-source speed limit | nonlinearity ∝ τ^-2: τ ≥ 1.5 ns → t_track ≥ 15 ns | – |

- **Trim, first run (old 4/14 switch, sah_12bit + `asw_inv` binary array 0.5–2.37 pF vs a fixed cap of the same value):**
  - acquisition is unchanged (±30 ns);
  - the pedestal shifts by up to about 1.5 mV;
  - **leakage is 4–6× higher** (125 °C at 1 pF: 979 vs 174 pA). Even the fixed cap reaches 174 pA at 125 °C with the old switch, so droop at high temperature has to be verified with the small switch.
- **Deviation from step 7:** the comparison is sah_12bit plus a trim array vs the same cell with a fixed cap, rather than `sample_and_hold_trim` side by side. This isolates the trim cost from the switch differences.

### Consequence of the ±35 % cap spread
The limits above were computed at nominal C, so they must now hold at C_nom × 0.65 plus ≈ 0.05 pF of unscaled parasitics.

| Mechanism | Requirement at −35 % | Drawn C_nom needed |
|---|---|---|
| Kickback (binding) | C_eff ≥ 0.62 pF | ≥ 0.88 pF without margin, ≥ 1.12 pF with 25 % margin on the binding limit |
| Follower noise | ≤ q at 125 °C (0.28 pF) | ≈ 0.36 pF |
| kT/C | 0.20 pF | ≈ 0.24 pF |
| Pedestal | 0.16 pF (fit NL ∝ C^-0.66, so the nonlinearity grows by 1.33× at −35 %) | ≈ 0.18 pF |

- **Frozen 0.993 pF cell at −35 %:** 0.645 + 0.05 pF gives a kickback of ≈ 178 µV, only 12 % below the budget. That is too thin.
- **New choice: C_nom = 1.21 pF** (`cap_cmomi` 59.63 × 25.2 µm, 66 rows, 1.214 pF).
  - At −35 %: 0.84 pF effective → kickback ≈ 148 µV, 36 % margin.
  - At +35 %: 1.69 pF → opamp acquisition ≈ 1.4–1.5 µs at 25 nA; the opamp stays stable (phase margin > 64° even at 16 pF).
  - Area 1.5k µm², up from 1.23k µm².
- The switch sizes stay as frozen: the pedestal only improves with larger C, and the PVT pedestal sweep at 1 pF already passes with 4× margin.
- **Effect on the trim question.** A ±35 % spread is the strongest argument for a trim array, so the report must weigh it explicitly:
  - **Fixed C sized for −35 %:** costs about 1.2× C and ≈ +300 µm² of area; the opamp acquisition is almost C-independent.
  - **Trimming to re-center C:** needs an on-chip way to measure C (none exists in this system), adds 4–6× hold-node leakage and extra parasitics, and has non-monotonic codes in the existing cell.
  - **Expected verdict:** fixed C with spread margin.

### Remaining
0. **Sync the plan:** copy this updated plan to `sah_12bit_sizing_PLAN.md` and commit only that file on `benedikt`, as for step 0. This is the first action after approval.
1. **Clean up:** delete the stray `/home/benedikt/heichips26-FAIf/fA2.log`, left by the broken batch.
1a. **Model the cap spread** in the tools.
   - **`cs_sizing.py`:**
     - add `CSPREAD = 0.35` and `CPAR = 0.05 pF` next to the budget constants;
     - convert every limit into a required drawn C_nom = (C_eff,min − CPAR)/(1 − CSPREAD);
     - evaluate speed at C_nom × (1 + CSPREAD);
     - print both columns, and the margins at −35 %, in the summary.
   - **Makefile `sim-xschem-pvt`:** also pass `-D pvt_cap=$$2`.
   - **`sah_12bit_final_tb_tran`:**
     - switch to `sah_12bit_param.sym`, with defaults equal to the frozen sizes;
     - map `pvt_cap` to CW: `wcs` → −35 %, `bcs` → +35 %, `typ` → nominal, rounded to whole 0.89 µm rows;
     - give it its own PVT list: tt:typ:27:3.3, tt:wcs:125:3.3, tt:wcs:-40:3.3, tt:bcs:125:3.3, ss:wcs:125:2.97, ss:bcs:125:2.97, ff:wcs:-40:3.63, ff:wcs:125:3.63, sf:wcs:27:3.3, fs:wcs:27:3.3.
   - **Equivalence check:** diff the device lines of the frozen `sah_12bit.sch` netlist against `sah_12bit_param` at its defaults. They must match, so that the param-based final TB still verifies the frozen schematic.
1b. **Re-freeze C1 at 59.63 × 25.2 µm** with `gen_sah_sch.py ... frozen 0.6 1.8 0.45 0.5 0.5 59.63 25.2`. Then:
   - update the `sah_12bit_param.sym` defaults, the cell header text and the README;
   - change the TB default `CWP` 48.95 → 59.63;
   - change the cap lists of the kickback and opamp-tran TBs to include 0.65× / 1× / 1.35× of 1.21 pF (39.16 / 59.63 / 80.1 µm) next to the existing points.
2. **Final runs** from a script file `scratchpad/final_runs.sh`. It uses absolute paths, never mixes `&&` with `&`, and runs in the background.
   - **A:** `prun.sh sah_12bit_opamp_tb_tran` and `prun.sh sah_12bit_kickback_tb_tran`, with the final switch and the extended cap lists (0.65× / 1× / 1.35× of 1.21 pF).
   - **B:**
     - `prun.sh sah_12bit_trim_tb_tran 6` (fixed vs trimmed at the same C);
     - `make sim-xschem-pvt TB=sah_12bit_ideal_tb_tran`, run on setup 15. Set that setup to the frozen switch with **C at −35 %** (CW 39.16 µm), so droop, leakage and pedestal are checked at the small-C corner over PVT;
     - setup 15 at nominal (`-D run_sel=15`);
     - `make sim-xschem TB=sah_12bit_ideal_tb_dc` (Ron including the frozen switch).
   - **C:** `make sim-xschem-pvt TB=sah_12bit_final_tb_tran` with the 10-point PVT and cap-spread list from 1a, using the PDK cap model. It reports pedestal, droop with the switch open at full Vds, slew rate, t_acq and static error.
3. **Archive** the tables into `testbenches/xschem/plot_simulations/data/`:
   - the final-switch results replace `opamp_tb_tran` and `kickback`; keep the old ones with a `_sw4x14` suffix;
   - merge r15 into `ideal_tb_tran.txt`;
   - add `ideal_tb_tran_pvt.txt`, `final_tb_tran_pvt.txt` and `trim_tb_tran.txt`.
4. **`cs_sizing.py`:** add a droop-vs-temperature figure and a figure for the final PVT check. Then run `make sizing` and look at every figure.
5. **Write `sah_12bit/docs/hold_cap_sizing.md`** (for the FAIf team), in this order:
   1. result first;
   2. budget;
   3. table of limiting mechanisms;
   4. case A, ideal source (Ron, kT/C, the pedestal fix, the speed–injection law, droop, feedthrough);
   5. case B, opamp buffer (stability, noise, static error, acquisition / input bandwidth via slew rate, switch re-sizing, kickback);
   6. choosing C, with the ±35 % spread rule. Table columns: C_eff,min per mechanism, required C_nom, and the margin at −35 % for the chosen 1.21 pF;
   7. final PVT and cap-spread check;
   8. trim verdict and recommendation, weighing the spread margin (area) against a trim array (leakage, parasitics, and no way to measure C on chip);
   9. caveats: ±35 % is an assumed lower bound because the MOM model has no spread or mismatch; LF model; the PTAT bias was not simulated; comparator and DAC noise were not simulated; no layout parasitics yet; usable range 0.45–3.2 V; offset at 125 °C.
6. **Do not commit.** Report to the user and offer a commit on `benedikt` with only `sah_12bit/`.

### Verification for the remaining work
- **Final PVT check:** at every corner and temperature, and at both cap-spread points:
  - pedestal nonlinearity ≤ 201 µV at C −35 % and t_acq ≤ about 2 µs at C +35 % (25 nA);
  - kickback at −35 % ≤ 201 µV, read from the C sweep.
- **Netlist equivalence:** the device lines of the frozen cell and of `sah_12bit_param` at its defaults are identical.
- **Droop:** report t_hold,max = ¼ LSB / droop at C −35 % and 125 °C, and compare it with 13 SAR cycles.
- **Kickback and trim reruns:** must confirm the old-switch conclusions with the frozen switch.
- **Script:** `make sizing` runs without errors and every figure is regenerated.
