ThePil0t/heichips26-FAIfplus/macros/heichips26_FAIf/final/render/heichips26_FAIf.png

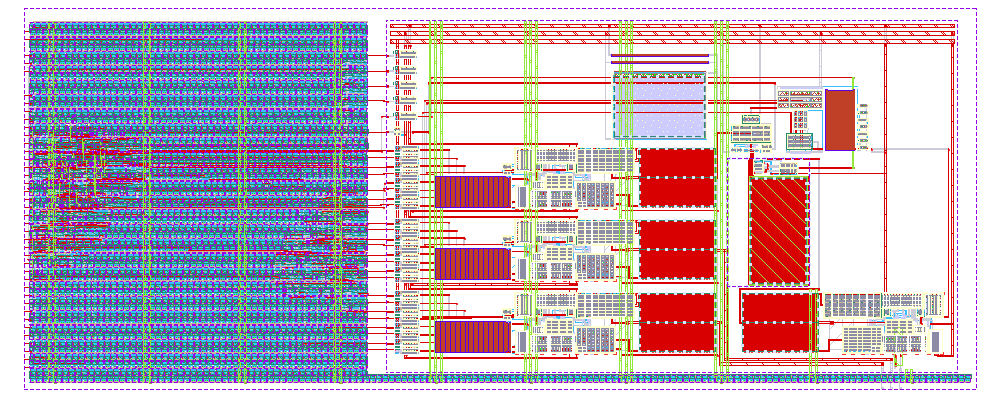
macros/heichips26_FAIf/final/render/heichips26_FAIf.png
