ThePil0t/heichips26-FAIfplus/macros/heichips26_FAIf/macros/analogue_interface/final/render/analogue_interface_black.png

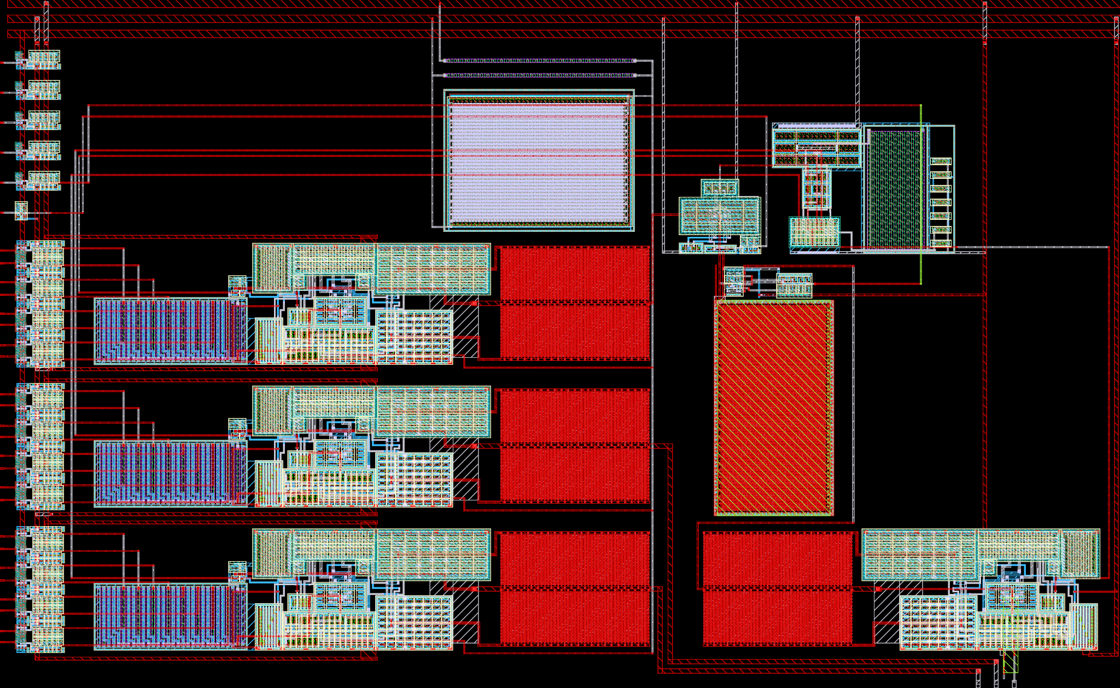
macros/heichips26_FAIf/macros/analogue_interface/final/render/analogue_interface_black.png
