ThePil0t/heichips26-FAIfplus/macros/heichips26_FAIf/macros/ptat_current_source/schematic/xschem/ptat_curr_gen_v1_06edf7f_original_csstartup.png

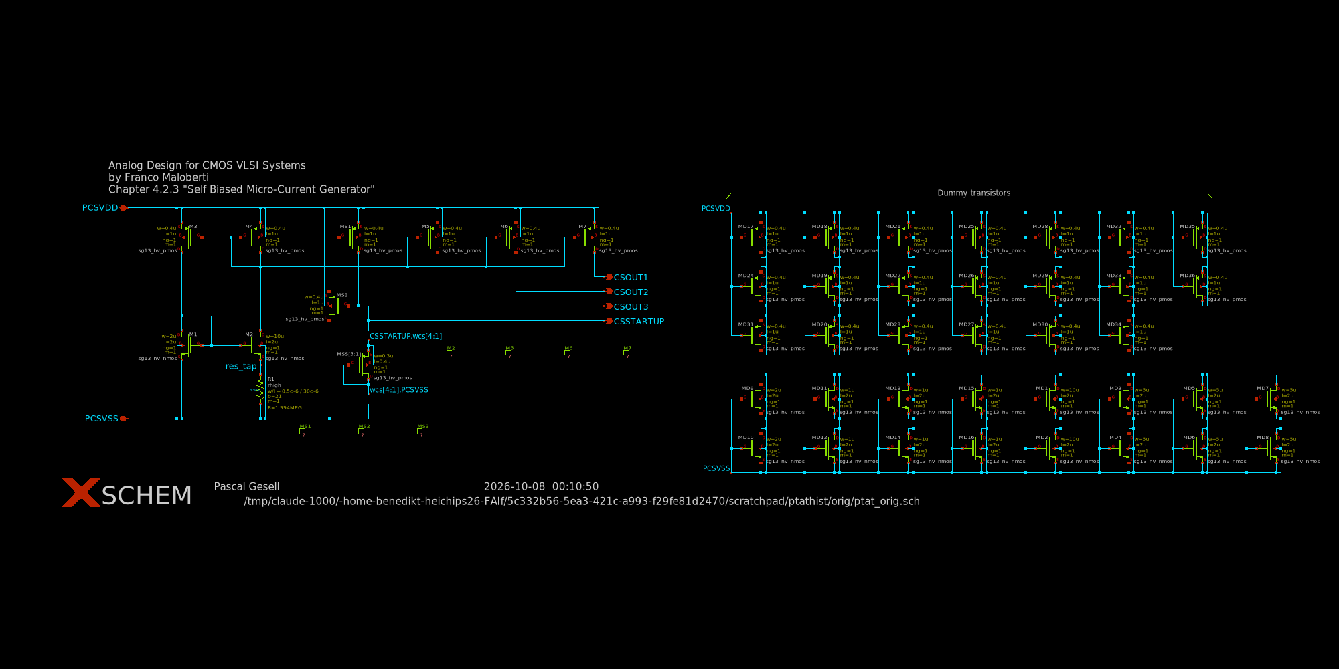
macros/heichips26_FAIf/macros/ptat_current_source/schematic/xschem/ptat_curr_gen_v1_06edf7f_original_csstartup.png
