ThePil0t/heichips26-FAIfplus/macros/heichips26_FAIf/macros/ptat_current_source/schematic/xschem/ptat_curr_gen_v3_2026-10-08_csout4.png

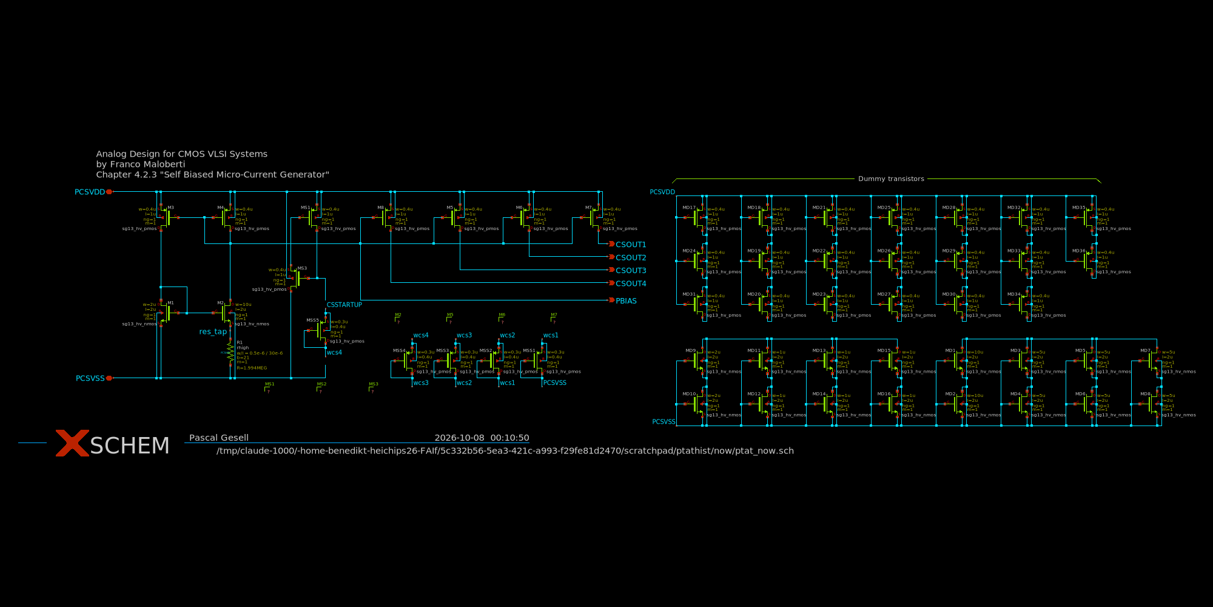
macros/heichips26_FAIf/macros/ptat_current_source/schematic/xschem/ptat_curr_gen_v3_2026-10-08_csout4.png
