ThePil0t/heichips26-FAIfplus/macros/heichips26_FAIf/macros/ptat_current_source/verification/testbench/ptat_startup_slow_ramp_corners.png

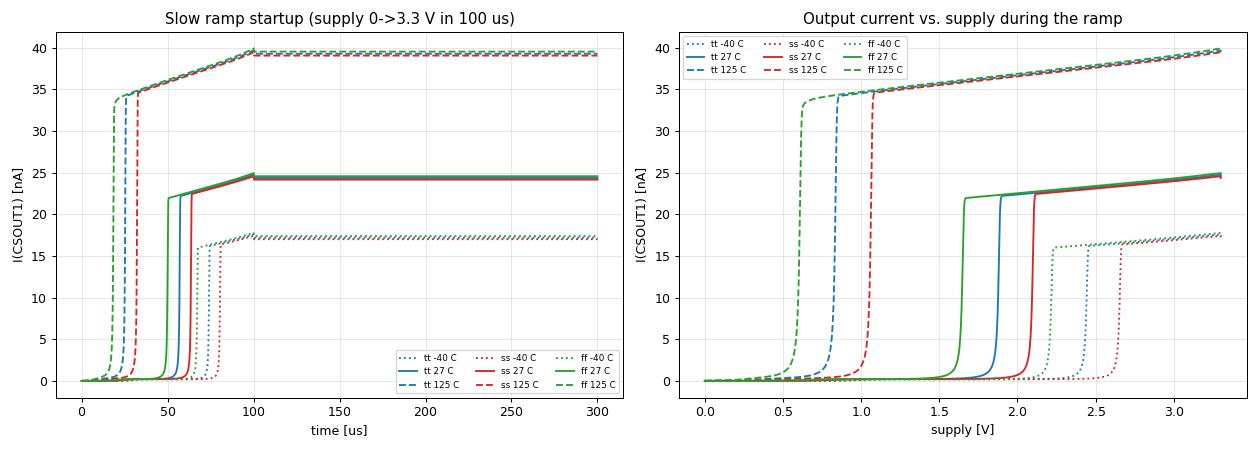
macros/heichips26_FAIf/macros/ptat_current_source/verification/testbench/ptat_startup_slow_ramp_corners.png
