ThePil0t/heichips26-FAIfplus/macros/heichips26_FAIf/macros/ptat_current_source/verification/testbench/ptat_startup_tt27_fast_slow_ramp.png

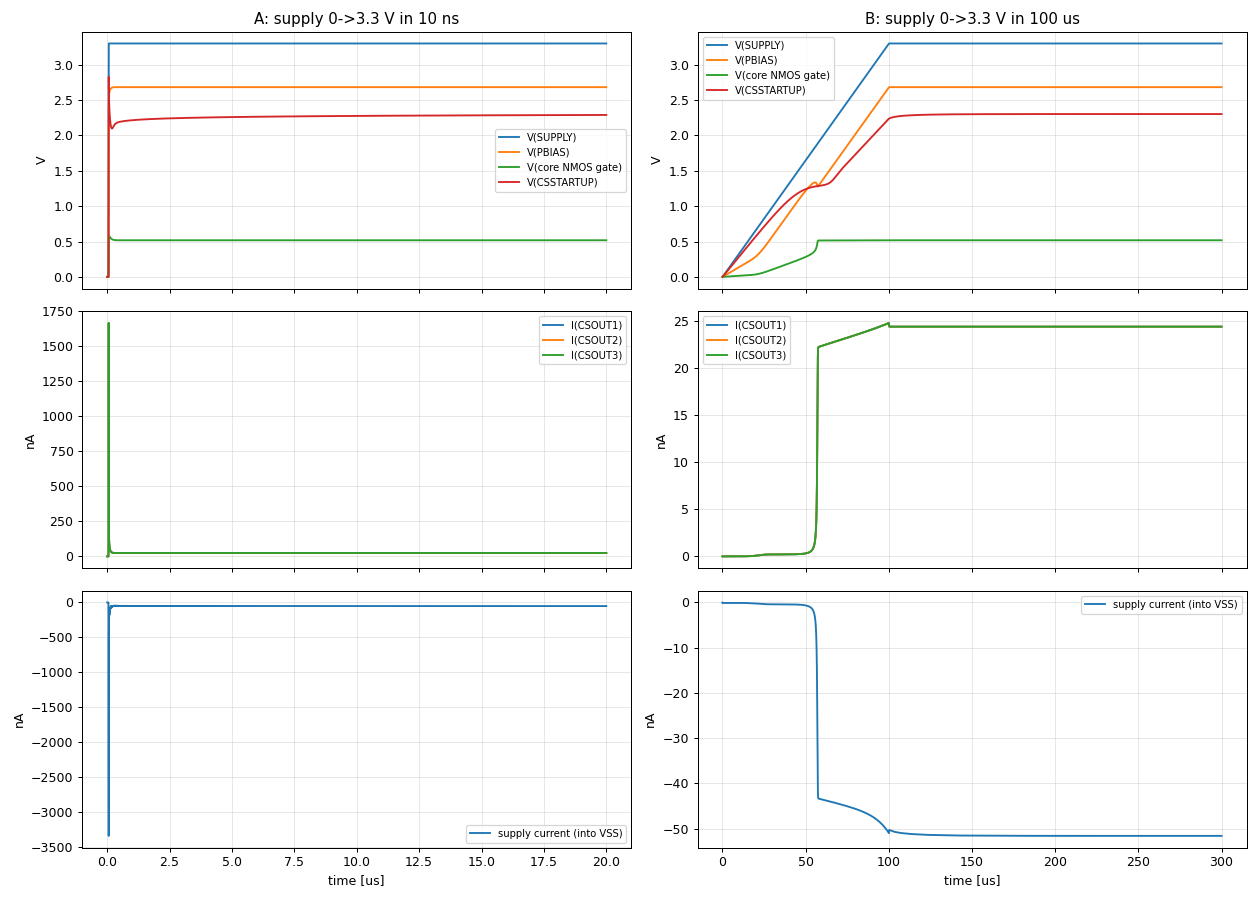
macros/heichips26_FAIf/macros/ptat_current_source/verification/testbench/ptat_startup_tt27_fast_slow_ramp.png
