ThePil0t/heichips26-FAIfplus/macros/heichips26_FAIf/macros/sah_12bit/testbenches/xschem/plot_simulations/figures/sah12_1_ron.png

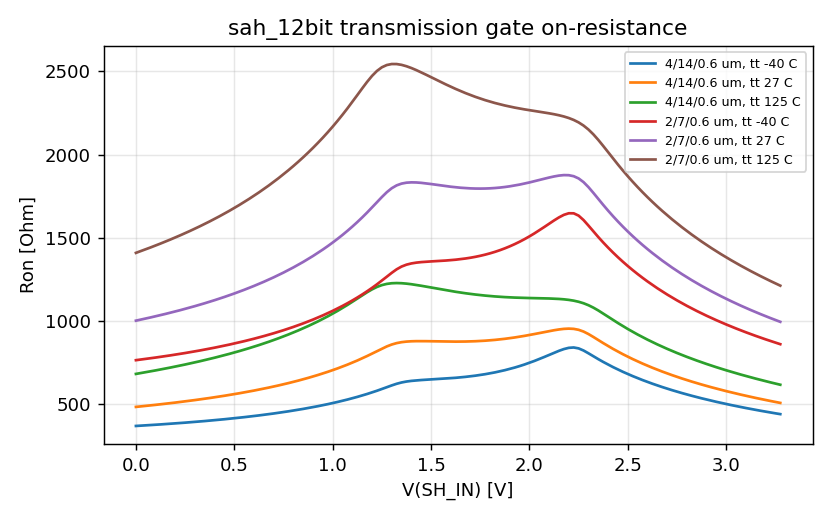
macros/heichips26_FAIf/macros/sah_12bit/testbenches/xschem/plot_simulations/figures/sah12_1_ron.png
