ThePil0t/heichips26-FAIfplus/macros/heichips26_FAIf/macros/sah_12bit/testbenches/xschem/plot_simulations/figures/sah12_2_pedestal_ideal.png

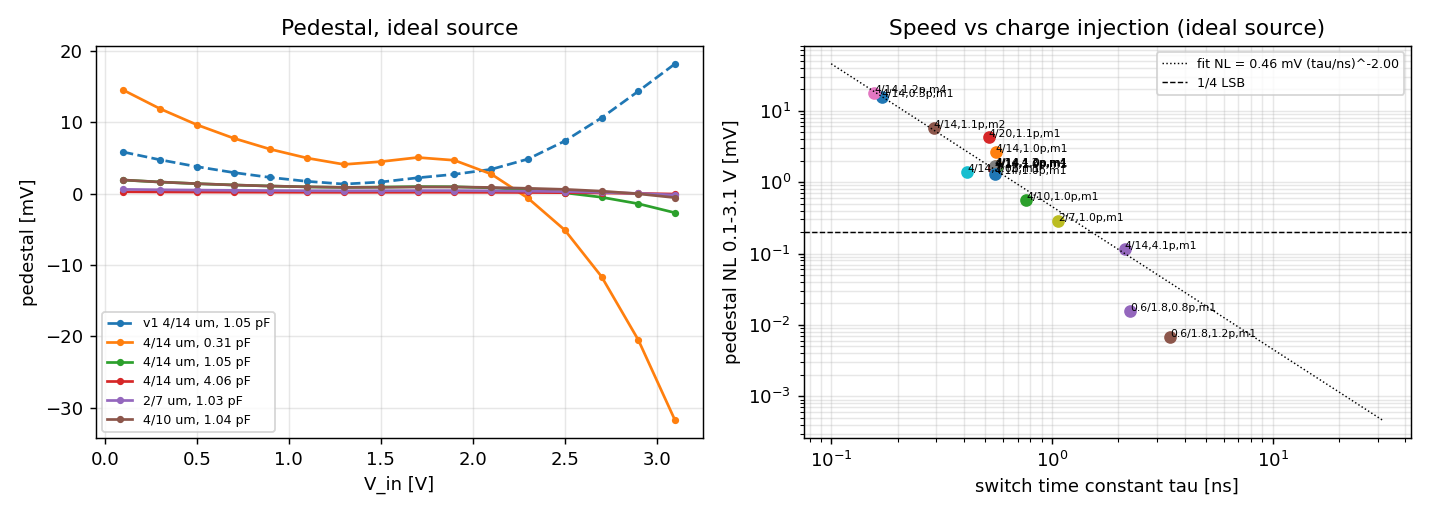
macros/heichips26_FAIf/macros/sah_12bit/testbenches/xschem/plot_simulations/figures/sah12_2_pedestal_ideal.png
