ThePil0t/heichips26-FAIfplus/macros/heichips26_FAIf/macros/sah_12bit/testbenches/xschem/plot_simulations/figures/sah12_3_pedestal_opamp.png

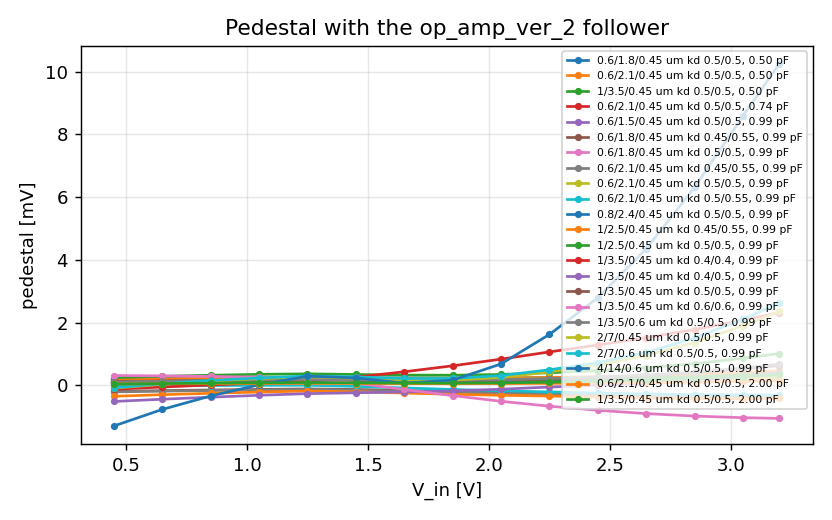
macros/heichips26_FAIf/macros/sah_12bit/testbenches/xschem/plot_simulations/figures/sah12_3_pedestal_opamp.png
