ThePil0t/heichips26-FAIfplus/macros/heichips26_FAIf/macros/sample_and_hold_trim/testbenches/xschem/plot_simulations/figures/sh_trim_tran_4_acquisition.png

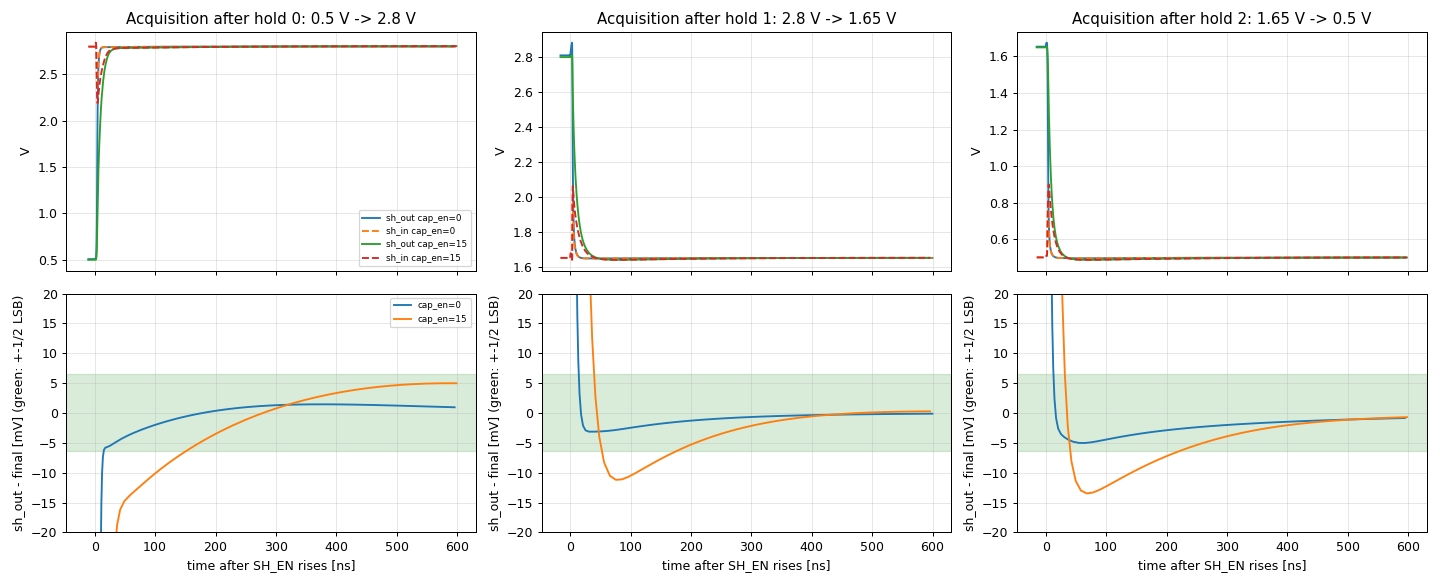
macros/heichips26_FAIf/macros/sample_and_hold_trim/testbenches/xschem/plot_simulations/figures/sh_trim_tran_4_acquisition.png
