ThePil0t/heichips26-FAIfplus/macros/heichips26_FAIf/macros/8x_inverting_digital_level_translator/netlist/schematic/inverter_magic.spice

** sch_path: /home/benedikt/heichips26-FAIf/macros/heichips26_FAIf/macros/8x_inverting_digital_level_translator/schematic/xschem/inverter.sch
.subckt inverter

.ends
