ThePil0t/heichips26-FAIfplus/macros/heichips26_FAIf/netlist/spice/heichips26_FAIf.spice

* NGSPICE file created from heichips26_FAIf.ext - technology: ihp-sg13cmos5l

* Black-box entry subcircuit for sg13cmos5l_decap_8 abstract view
.subckt sg13cmos5l_decap_8 VDD VSS
.ends

* Black-box entry subcircuit for sg13cmos5l_fill_1 abstract view
.subckt sg13cmos5l_fill_1 VDD VSS
.ends

* Black-box entry subcircuit for sg13cmos5l_mux2_1 abstract view
.subckt sg13cmos5l_mux2_1 X A0 A1 S VDD VSS
.ends

* Black-box entry subcircuit for sg13cmos5l_inv_1 abstract view
.subckt sg13cmos5l_inv_1 Y A VDD VSS
.ends

* Black-box entry subcircuit for sg13cmos5l_decap_4 abstract view
.subckt sg13cmos5l_decap_4 VDD VSS
.ends

* Black-box entry subcircuit for sg13cmos5l_a21oi_1 abstract view
.subckt sg13cmos5l_a21oi_1 Y A1 A2 B1 VDD VSS
.ends

* Black-box entry subcircuit for sg13cmos5l_dlygate4sd3_1 abstract view
.subckt sg13cmos5l_dlygate4sd3_1 X A VDD VSS
.ends

* Black-box entry subcircuit for sg13cmos5l_fill_2 abstract view
.subckt sg13cmos5l_fill_2 VDD VSS
.ends

* Black-box entry subcircuit for sg13cmos5l_buf_1 abstract view
.subckt sg13cmos5l_buf_1 X A VDD VSS
.ends

* Black-box entry subcircuit for sg13cmos5l_buf_8 abstract view
.subckt sg13cmos5l_buf_8 X A VDD VSS
.ends

* Black-box entry subcircuit for sg13cmos5l_nand4_1 abstract view
.subckt sg13cmos5l_nand4_1 Y A B C D VDD VSS
.ends

* Black-box entry subcircuit for sg13cmos5l_nand2b_1 abstract view
.subckt sg13cmos5l_nand2b_1 Y A_N B VDD VSS
.ends

* Black-box entry subcircuit for sg13cmos5l_nand2_1 abstract view
.subckt sg13cmos5l_nand2_1 Y A B VDD VSS
.ends

* Black-box entry subcircuit for sg13cmos5l_dfrbpq_1 abstract view
.subckt sg13cmos5l_dfrbpq_1 Q CLK D RESET_B VDD VSS
.ends

* Black-box entry subcircuit for sg13cmos5l_a21o_1 abstract view
.subckt sg13cmos5l_a21o_1 X A1 A2 B1 VDD VSS
.ends

* Black-box entry subcircuit for sg13cmos5l_nor2b_1 abstract view
.subckt sg13cmos5l_nor2b_1 Y A B_N VDD VSS
.ends

* Black-box entry subcircuit for sg13cmos5l_nor4_1 abstract view
.subckt sg13cmos5l_nor4_1 Y A B C D VDD VSS
.ends

* Black-box entry subcircuit for sg13cmos5l_nor3_1 abstract view
.subckt sg13cmos5l_nor3_1 Y A B C VDD VSS
.ends

* Black-box entry subcircuit for sg13cmos5l_and2_1 abstract view
.subckt sg13cmos5l_and2_1 X A B VDD VSS
.ends

* Black-box entry subcircuit for sg13cmos5l_tielo abstract view
.subckt sg13cmos5l_tielo L_LO VDD VSS
.ends

* Black-box entry subcircuit for sg13cmos5l_nand3_1 abstract view
.subckt sg13cmos5l_nand3_1 Y A B C VDD VSS
.ends

* Black-box entry subcircuit for analogue_interface abstract view
.subckt analogue_interface adc_ref[0] adc_ref[1] adc_ref[2] adc_ref[3] adc_ref[4]
+ adc_ref[5] adc_ref[6] adc_ref[7] adc_hold adc_comp dac_out[0] dac_out[1] dac_out[2]
+ dac_out[3] dac_out[4] dac_out[5] dac_out[6] dac_out[7] dac_out[8] dac_out[9] dac_out[10]
+ dac_out[11] dac_out[12] dac_out[13] dac_out[14] dac_out[15] sh_cap_en[0] sh_cap_en[1]
+ sh_cap_en[2] sh_cap_en[3] analog_0 analog_1 analog_2 VPWR VGND VAPWR
.ends

* Black-box entry subcircuit for sg13cmos5l_tiehi abstract view
.subckt sg13cmos5l_tiehi L_HI VDD VSS
.ends

* Black-box entry subcircuit for sg13cmos5l_nor2_1 abstract view
.subckt sg13cmos5l_nor2_1 Y A B VDD VSS
.ends

* Black-box entry subcircuit for sg13cmos5l_a221oi_1 abstract view
.subckt sg13cmos5l_a221oi_1 Y A1 A2 B1 B2 C1 VDD VSS
.ends

.subckt heichips26_FAIf VAPWR VGND VPWR analog_0 analog_1 analog_2 clk ena rst_n ui_in[0]
+ ui_in[1] ui_in[2] ui_in[3] ui_in[4] ui_in[5] ui_in[6] ui_in[7] uio_in[0] uio_in[1]
+ uio_in[2] uio_in[3] uio_in[4] uio_in[5] uio_in[6] uio_in[7] uio_oe[0] uio_oe[1]
+ uio_oe[2] uio_oe[3] uio_oe[4] uio_oe[5] uio_oe[6] uio_oe[7] uio_out[0] uio_out[1]
+ uio_out[2] uio_out[3] uio_out[4] uio_out[5] uio_out[6] uio_out[7] uo_out[0] uo_out[1]
+ uo_out[2] uo_out[3] uo_out[4] uo_out[5] uo_out[6] uo_out[7]
XFILLER_39_277 VPWR VGND sg13cmos5l_decap_8
XFILLER_22_144 VPWR VGND sg13cmos5l_decap_8
XFILLER_7_7 VPWR VGND sg13cmos5l_decap_8
XFILLER_45_214 VPWR VGND sg13cmos5l_decap_8
XFILLER_42_84 VPWR VGND sg13cmos5l_decap_8
XFILLER_9_137 VPWR VGND sg13cmos5l_decap_8
XFILLER_13_144 VPWR VGND sg13cmos5l_decap_8
XFILLER_5_354 VPWR VGND sg13cmos5l_decap_8
XFILLER_36_247 VPWR VGND sg13cmos5l_decap_8
XFILLER_3_67 VPWR VGND sg13cmos5l_decap_8
XFILLER_44_291 VPWR VGND sg13cmos5l_decap_8
XFILLER_42_217 VPWR VGND sg13cmos5l_decap_8
XFILLER_27_247 VPWR VGND sg13cmos5l_decap_8
XFILLER_10_158 VPWR VGND sg13cmos5l_decap_8
XFILLER_12_32 VPWR VGND sg13cmos5l_decap_8
XFILLER_5_4 VPWR VGND sg13cmos5l_decap_8
XFILLER_2_368 VPWR VGND sg13cmos5l_fill_1
XFILLER_37_84 VPWR VGND sg13cmos5l_decap_8
XFILLER_18_225 VPWR VGND sg13cmos5l_decap_8
XFILLER_33_206 VPWR VGND sg13cmos5l_decap_8
XFILLER_41_294 VPWR VGND sg13cmos5l_decap_8
XFILLER_5_151 VPWR VGND sg13cmos5l_decap_8
XFILLER_38_4 VPWR VGND sg13cmos5l_decap_8
XFILLER_49_361 VPWR VGND sg13cmos5l_decap_8
XFILLER_24_239 VPWR VGND sg13cmos5l_decap_8
XFILLER_32_283 VPWR VGND sg13cmos5l_decap_8
X_200_ _221_/D input5/X hold95/X _200_/S VPWR VGND sg13cmos5l_mux2_1
X_131_ _255_/D _174_/A VPWR VGND sg13cmos5l_inv_1
XFILLER_23_97 VPWR VGND sg13cmos5l_decap_8
XFILLER_2_165 VPWR VGND sg13cmos5l_decap_8
XFILLER_46_364 VPWR VGND sg13cmos5l_decap_4
XFILLER_0_35 VPWR VGND sg13cmos5l_decap_8
XFILLER_9_11 VPWR VGND sg13cmos5l_decap_8
XFILLER_9_88 VPWR VGND sg13cmos5l_decap_8
XFILLER_29_309 VPWR VGND sg13cmos5l_decap_8
XFILLER_0_658 VPWR VGND sg13cmos5l_decap_8
XFILLER_43_312 VPWR VGND sg13cmos5l_decap_8
XFILLER_28_331 VPWR VGND sg13cmos5l_decap_8
XFILLER_11_242 VPWR VGND sg13cmos5l_decap_8
X_114_ _127_/B _138_/C _113_/Y _119_/A VPWR VGND sg13cmos5l_a21oi_1
XFILLER_7_224 VPWR VGND sg13cmos5l_decap_8
XFILLER_46_161 VPWR VGND sg13cmos5l_decap_8
XFILLER_34_334 VPWR VGND sg13cmos5l_decap_8
XFILLER_44_109 VPWR VGND sg13cmos5l_decap_8
XFILLER_37_161 VPWR VGND sg13cmos5l_decap_8
XFILLER_29_139 VPWR VGND sg13cmos5l_decap_8
XFILLER_40_326 VPWR VGND sg13cmos5l_decap_8
XFILLER_4_249 VPWR VGND sg13cmos5l_decap_8
XFILLER_20_76 VPWR VGND sg13cmos5l_decap_8
XFILLER_0_455 VPWR VGND sg13cmos5l_decap_8
Xhold63 _217_/D _196_/X VPWR VGND sg13cmos5l_dlygate4sd3_1
Xhold74 hold74/X _232_/Q VPWR VGND sg13cmos5l_dlygate4sd3_1
XFILLER_45_95 VPWR VGND sg13cmos5l_decap_8
Xhold85 hold85/X _237_/Q VPWR VGND sg13cmos5l_dlygate4sd3_1
XFILLER_43_186 VPWR VGND sg13cmos5l_decap_8
XFILLER_31_315 VPWR VGND sg13cmos5l_decap_8
XFILLER_28_183 VPWR VGND sg13cmos5l_fill_2
Xhold96 hold96/X _223_/Q VPWR VGND sg13cmos5l_dlygate4sd3_1
XFILLER_16_334 VPWR VGND sg13cmos5l_decap_8
XFILLER_6_67 VPWR VGND sg13cmos5l_decap_8
XFILLER_34_131 VPWR VGND sg13cmos5l_decap_8
XFILLER_25_153 VPWR VGND sg13cmos5l_decap_8
XFILLER_40_123 VPWR VGND sg13cmos5l_decap_8
XFILLER_31_42 VPWR VGND sg13cmos5l_fill_2
XFILLER_9_319 VPWR VGND sg13cmos5l_decap_8
XFILLER_15_76 VPWR VGND sg13cmos5l_decap_8
Xoutput20 uo_out[2] _228_/Q VPWR VGND sg13cmos5l_buf_1
XFILLER_48_245 VPWR VGND sg13cmos5l_decap_8
XFILLER_0_252 VPWR VGND sg13cmos5l_decap_8
XFILLER_16_175 VPWR VGND sg13cmos5l_decap_8
XFILLER_31_189 VPWR VGND sg13cmos5l_decap_8
XFILLER_39_256 VPWR VGND sg13cmos5l_decap_8
XFILLER_22_123 VPWR VGND sg13cmos5l_decap_8
XFILLER_9_116 VPWR VGND sg13cmos5l_decap_8
XFILLER_13_123 VPWR VGND sg13cmos5l_decap_8
Xclkbuf_3_6__f_clk _224_/CLK clkbuf_0_clk/X VPWR VGND sg13cmos5l_buf_8
XFILLER_42_63 VPWR VGND sg13cmos5l_decap_8
XFILLER_5_333 VPWR VGND sg13cmos5l_decap_8
XFILLER_3_46 VPWR VGND sg13cmos5l_decap_8
XFILLER_36_226 VPWR VGND sg13cmos5l_decap_8
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
XFILLER_9_18 VPWR VGND sg13cmos5l_decap_8
XFILLER_14_235 VPWR VGND sg13cmos5l_decap_8
XFILLER_13_60 VPWR VGND sg13cmos5l_decap_8
X_184_ _205_/D input5/X hold68/X _188_/S VPWR VGND sg13cmos5l_mux2_1
X_253_ _253_/Q _254_/CLK _253_/D fanout35/X VPWR VGND sg13cmos5l_dfrbpq_1
XFILLER_1_161 VPWR VGND sg13cmos5l_decap_8
XFILLER_49_165 VPWR VGND sg13cmos5l_decap_8
Xclkbuf_3_7__f_clk _237_/CLK clkbuf_0_clk/X VPWR VGND sg13cmos5l_buf_8
XFILLER_20_216 VPWR VGND sg13cmos5l_decap_8
XFILLER_28_338 VPWR VGND sg13cmos5l_decap_8
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
