ThePil0t/heichips26-FAIfplus/macros/heichips26_FAIf/macros/analogue_interface/netlist/layout/analogue_interface_klayout.cir

* Extracted by KLayout with SG13CMOS5L LVS runset on : 09/10/2026 13:53

.SUBCKT analogue_interface VAPWR VGND VPWR adc_comp adc_hold adc_ref[0]
+ adc_ref[1] adc_ref[2] adc_ref[3] adc_ref[4] adc_ref[5] adc_ref[6] adc_ref[7]
+ analog_0 analog_1 analog_2 dac_out[0] dac_out[10] dac_out[11] dac_out[12]
+ dac_out[13] dac_out[14] dac_out[15] dac_out[1] dac_out[2] dac_out[3]
+ dac_out[4] dac_out[5] dac_out[6] dac_out[7] dac_out[8] dac_out[9]
+ sh_cap_en[0] sh_cap_en[1] sh_cap_en[2] sh_cap_en[3]
M$1 VGND \$I167 VGND VGND sg13_hv_nmos L=48u W=33.5u AS=11.39p AD=11.39p
+ PS=67.68u PD=67.68u rfmode=0
C$2 VGND \$I167 cap_cmomi w=31.79u l=47.16u A=0p P=0u m=1
R$3 \$I167 VGND VGND rhigh w=0.5u l=50u ps=0u b=0 m=1
R$4 \$I167 VAPWR VGND rhigh w=0.5u l=50u ps=0u b=0 m=1
M$5 VGND \$I181 \$I209 VGND sg13_hv_nmos L=2.4u W=0.6u AS=0.204p AD=0.114p
+ PS=1.88u PD=0.98u rfmode=0
M$6 \$I209 \$I180 \$I183 VGND sg13_hv_nmos L=0.6u W=0.6u AS=0.114p AD=0.204p
+ PS=0.98u PD=1.88u rfmode=0
M$7 VGND VGND \$I188 VGND sg13_hv_nmos L=0.6u W=0.6u AS=0.114p AD=0.204p
+ PS=0.98u PD=1.88u rfmode=0
M$8 VGND \$I128 \$I198 VGND sg13_hv_nmos L=2.4u W=0.6u AS=0.204p AD=0.204p
+ PS=1.88u PD=1.88u rfmode=0
M$9 VGND \$I128 \$I128 VGND sg13_hv_nmos L=2.4u W=0.6u AS=0.204p AD=0.204p
+ PS=1.88u PD=1.88u rfmode=0
M$10 VGND \$I128 VGND VGND sg13_hv_nmos L=2.4u W=1.2u AS=0.408p AD=0.408p
+ PS=3.76u PD=3.76u rfmode=0
M$11 VGND \$I128 \$I199 VGND sg13_hv_nmos L=2.4u W=0.6u AS=0.204p AD=0.204p
+ PS=1.88u PD=1.88u rfmode=0
M$13 VGND \$I181 VGND VGND sg13_hv_nmos L=2.4u W=2.4u AS=0.546p AD=0.726p
+ PS=4.82u PD=6.62u rfmode=0
M$14 VGND VGND \$I192 VGND sg13_hv_nmos L=0.6u W=0.6u AS=0.114p AD=0.204p
+ PS=0.98u PD=1.88u rfmode=0
M$15 \$I189 \$I180 \$I185 VGND sg13_hv_nmos L=0.6u W=4.8u AS=1.272p AD=1.272p
+ PS=11.44u PD=11.44u rfmode=0
M$16 \$I185 \$I189 VGND VGND sg13_hv_nmos L=2.4u W=4.8u AS=1.272p AD=1.272p
+ PS=11.44u PD=11.44u rfmode=0
M$17 \$I188 \$I180 \$I186 VGND sg13_hv_nmos L=0.6u W=4.8u AS=1.272p AD=1.272p
+ PS=11.44u PD=11.44u rfmode=0
M$18 \$I186 \$I189 VGND VGND sg13_hv_nmos L=2.4u W=4.8u AS=1.272p AD=1.272p
+ PS=11.44u PD=11.44u rfmode=0
M$23 \$I193 \$I180 \$I182 VGND sg13_hv_nmos L=0.6u W=4.8u AS=1.272p AD=1.272p
+ PS=11.44u PD=11.44u rfmode=0
M$24 \$I182 \$I181 VGND VGND sg13_hv_nmos L=2.4u W=4.8u AS=1.272p AD=1.272p
+ PS=11.44u PD=11.44u rfmode=0
M$29 VGND \$I180 VGND VGND sg13_hv_nmos L=0.6u W=1.2u AS=0.408p AD=0.228p
+ PS=3.76u PD=1.96u rfmode=0
M$34 \$I184 VGND VGND VGND sg13_hv_nmos L=0.6u W=0.6u AS=0.204p AD=0.114p
+ PS=1.88u PD=0.98u rfmode=0
M$44 \$I128 VGND VGND VGND sg13_hv_nmos L=0.6u W=0.6u AS=0.204p AD=0.114p
+ PS=1.88u PD=0.98u rfmode=0
M$50 VGND \$I181 \$I208 VGND sg13_hv_nmos L=2.4u W=0.6u AS=0.204p AD=0.114p
+ PS=1.88u PD=0.98u rfmode=0
M$51 \$I208 \$I180 \$I181 VGND sg13_hv_nmos L=0.6u W=0.6u AS=0.114p AD=0.204p
+ PS=0.98u PD=1.88u rfmode=0
M$72 VAPWR \$I199 \$I196 VAPWR sg13_hv_pmos L=1.2u W=9.6u AS=2.544p AD=2.544p
+ PS=18.64u PD=18.64u rfmode=0
M$73 \$I196 \$I198 \$I189 VAPWR sg13_hv_pmos L=0.6u W=9.6u AS=2.544p AD=2.544p
+ PS=18.64u PD=18.64u rfmode=0
M$80 VAPWR \$I199 VAPWR VAPWR sg13_hv_pmos L=1.2u W=7.2u AS=2.088p AD=1.728p
+ PS=15.48u PD=12.48u rfmode=0
M$81 VAPWR \$I198 VAPWR VAPWR sg13_hv_pmos L=0.6u W=7.2u AS=1.728p AD=2.088p
+ PS=12.48u PD=15.48u rfmode=0
M$82 VAPWR \$I199 \$I204 VAPWR sg13_hv_pmos L=1.2u W=1.2u AS=0.408p AD=0.228p
+ PS=3.08u PD=1.58u rfmode=0
M$83 \$I204 \$I198 \$I180 VAPWR sg13_hv_pmos L=0.6u W=1.2u AS=0.228p AD=0.408p
+ PS=1.58u PD=3.08u rfmode=0
M$84 VAPWR \$I199 \$I197 VAPWR sg13_hv_pmos L=1.2u W=9.6u AS=2.544p AD=2.544p
+ PS=18.64u PD=18.64u rfmode=0
M$85 \$I197 \$I198 \$I190 VAPWR sg13_hv_pmos L=0.6u W=9.6u AS=2.544p AD=2.544p
+ PS=18.64u PD=18.64u rfmode=0
M$98 \$I184 \$I198 \$I207 VAPWR sg13_hv_pmos L=0.6u W=1.2u AS=0.408p AD=0.228p
+ PS=3.08u PD=1.58u rfmode=0
M$99 \$I207 \$I199 VAPWR VAPWR sg13_hv_pmos L=1.2u W=1.2u AS=0.228p AD=0.408p
+ PS=1.58u PD=3.08u rfmode=0
M$106 \$I199 \$I198 \$I206 VAPWR sg13_hv_pmos L=0.6u W=1.2u AS=0.408p AD=0.228p
+ PS=3.08u PD=1.58u rfmode=0
M$107 \$I206 \$I199 VAPWR VAPWR sg13_hv_pmos L=1.2u W=1.2u AS=0.228p AD=0.408p
+ PS=1.58u PD=3.08u rfmode=0
M$114 \$I181 \$I198 \$I205 VAPWR sg13_hv_pmos L=0.6u W=1.2u AS=0.408p AD=0.228p
+ PS=3.08u PD=1.58u rfmode=0
M$115 \$I205 \$I199 VAPWR VAPWR sg13_hv_pmos L=1.2u W=1.2u AS=0.228p AD=0.408p
+ PS=1.58u PD=3.08u rfmode=0
M$124 \$I192 VGND VAPWR VAPWR sg13_hv_pmos L=0.6u W=1.2u AS=0.408p AD=0.228p
+ PS=3.08u PD=1.58u rfmode=0
M$125 VAPWR \$I192 \$I198 VAPWR sg13_hv_pmos L=0.6u W=1.2u AS=0.228p AD=0.408p
+ PS=1.58u PD=3.08u rfmode=0
M$126 \$I183 \$I192 VAPWR VAPWR sg13_hv_pmos L=0.6u W=1.2u AS=0.408p AD=0.228p
+ PS=3.08u PD=1.58u rfmode=0
M$127 VAPWR \$I192 \$I190 VAPWR sg13_hv_pmos L=0.6u W=1.2u AS=0.228p AD=0.408p
+ PS=1.58u PD=3.08u rfmode=0
M$128 VAPWR \$I172 \$I129 VAPWR sg13_hv_pmos L=0.45u W=1.2u AS=0.408p AD=0.408p
+ PS=3.76u PD=3.76u rfmode=0
M$130 VAPWR \$I171 \$I172 VAPWR sg13_hv_pmos L=0.45u W=0.6u AS=0.204p AD=0.204p
+ PS=1.88u PD=1.88u rfmode=0
M$131 \$I172 \$I171 VGND VGND sg13_hv_nmos L=0.45u W=0.3u AS=0.102p AD=0.102p
+ PS=1.28u PD=1.28u rfmode=0
M$132 \$I129 \$I172 VGND VGND sg13_hv_nmos L=0.45u W=0.6u AS=0.204p AD=0.204p
+ PS=2.56u PD=2.56u rfmode=0
M$134 VGND VGND VGND VGND sg13_hv_nmos L=0.45u W=79.2u AS=26.928p AD=26.928p
+ PS=192.4u PD=192.4u rfmode=0
M$136 \$I171 \$I173 VGND VGND sg13_hv_nmos L=0.45u W=2.4u AS=0.816p AD=0.816p
+ PS=5.48u PD=5.48u rfmode=0
M$137 VAPWR \$I126 \$I175 VAPWR sg13_hv_pmos L=1u W=0.8u AS=0.272p AD=0.272p
+ PS=2.28u PD=2.28u rfmode=0
M$138 VAPWR VAPWR VAPWR VAPWR sg13_hv_pmos L=1u W=10.4u AS=3.536p AD=3.536p
+ PS=37.12u PD=37.12u rfmode=0
M$139 VAPWR \$I126 \$I171 VAPWR sg13_hv_pmos L=1u W=0.8u AS=0.272p AD=0.272p
+ PS=2.28u PD=2.28u rfmode=0
M$141 VAPWR VAPWR VAPWR VAPWR sg13_hv_pmos L=0.45u W=40u AS=13.6p AD=13.6p
+ PS=88.16u PD=88.16u rfmode=0
M$149 \$I174 \$I164 \$I175 VAPWR sg13_hv_pmos L=0.45u W=10u AS=3.4p AD=3.4p
+ PS=21.36u PD=21.36u rfmode=0
M$150 \$I173 \$I100 \$I175 VAPWR sg13_hv_pmos L=0.45u W=10u AS=3.4p AD=3.4p
+ PS=21.36u PD=21.36u rfmode=0
M$157 VGND VGND VGND VGND sg13_hv_nmos L=1u W=0.8u AS=0.272p AD=0.272p PS=2.96u
+ PD=2.96u rfmode=0
M$158 \$I173 \$I174 VGND VGND sg13_hv_nmos L=1u W=0.4u AS=0.136p AD=0.136p
+ PS=1.48u PD=1.48u rfmode=0
M$160 \$I174 \$I174 VGND VGND sg13_hv_nmos L=1u W=0.4u AS=0.136p AD=0.136p
+ PS=1.48u PD=1.48u rfmode=0
C$161 \$I164 VGND cap_cmomi w=54.93u l=29.52u A=0p P=0u m=1
M$162 VGND VGND VGND VGND sg13_hv_nmos L=0.6u W=86.4u AS=29.376p AD=29.376p
+ PS=221.76u PD=221.76u rfmode=0
M$163 \$I187 \$I187 VGND VGND sg13_hv_nmos L=0.6u W=1.2u AS=0.408p AD=0.408p
+ PS=3.08u PD=3.08u rfmode=0
M$165 \$I184 \$I184 \$I187 VGND sg13_hv_nmos L=0.6u W=1.2u AS=0.408p AD=0.408p
+ PS=3.08u PD=3.08u rfmode=0
M$166 \$I153 \$I188 VGND VGND sg13_hv_nmos L=0.6u W=48u AS=16.32p AD=16.32p
+ PS=123.2u PD=123.2u rfmode=0
M$222 \$I188 \$I184 \$I190 VGND sg13_hv_nmos L=0.6u W=4.8u AS=1.632p AD=1.632p
+ PS=12.32u PD=12.32u rfmode=0
M$226 VGND \$I180 VGND VGND sg13_hv_nmos L=10u W=0.8u AS=0.272p AD=0.272p
+ PS=2.96u PD=2.96u rfmode=0
M$227 \$I179 \$I180 VGND VGND sg13_hv_nmos L=10u W=0.4u AS=0.136p AD=0.136p
+ PS=1.48u PD=1.48u rfmode=0
M$229 \$I180 \$I180 \$I195 VGND sg13_hv_nmos L=10u W=0.4u AS=0.136p AD=0.136p
+ PS=1.48u PD=1.48u rfmode=0
M$230 \$I195 \$I180 \$I194 VGND sg13_hv_nmos L=10u W=0.4u AS=0.136p AD=0.136p
+ PS=1.48u PD=1.48u rfmode=0
M$231 \$I194 \$I180 \$I191 VGND sg13_hv_nmos L=10u W=0.4u AS=0.136p AD=0.136p
+ PS=1.48u PD=1.48u rfmode=0
M$232 \$I191 \$I180 \$I179 VGND sg13_hv_nmos L=10u W=0.4u AS=0.136p AD=0.136p
+ PS=1.48u PD=1.48u rfmode=0
M$233 \$I200 \$I198 \$I198 VAPWR sg13_hv_pmos L=10u W=1u AS=0.34p AD=0.34p
+ PS=2.68u PD=2.68u rfmode=0
M$234 VAPWR \$I198 VAPWR VAPWR sg13_hv_pmos L=10u W=2u AS=0.68p AD=0.68p
+ PS=5.36u PD=5.36u rfmode=0
M$235 VAPWR \$I198 \$I202 VAPWR sg13_hv_pmos L=10u W=1u AS=0.34p AD=0.34p
+ PS=2.68u PD=2.68u rfmode=0
M$236 \$I202 \$I198 \$I201 VAPWR sg13_hv_pmos L=10u W=1u AS=0.34p AD=0.34p
+ PS=2.68u PD=2.68u rfmode=0
M$238 \$I201 \$I198 \$I200 VAPWR sg13_hv_pmos L=10u W=1u AS=0.34p AD=0.34p
+ PS=2.68u PD=2.68u rfmode=0
M$247 \$I153 \$I190 VAPWR VAPWR sg13_hv_pmos L=0.4u W=96u AS=32.64p AD=32.64p
+ PS=219.2u PD=219.2u rfmode=0
M$248 VAPWR VAPWR VAPWR VAPWR sg13_hv_pmos L=0.4u W=172.8u AS=58.752p
+ AD=58.752p PS=394.56u PD=394.56u rfmode=0
M$291 \$I203 \$I183 \$I183 VAPWR sg13_hv_pmos L=0.4u W=2.4u AS=0.816p AD=0.816p
+ PS=5.48u PD=5.48u rfmode=0
M$292 \$I188 \$I183 \$I190 VAPWR sg13_hv_pmos L=0.4u W=9.6u AS=3.264p AD=3.264p
+ PS=21.92u PD=21.92u rfmode=0
M$309 VAPWR \$I203 \$I203 VAPWR sg13_hv_pmos L=0.4u W=2.4u AS=0.816p AD=0.816p
+ PS=5.48u PD=5.48u rfmode=0
M$315 \$I193 analog_2 \$I197 VGND sg13_hv_nmos L=0.45u W=4.8u AS=1.632p
+ AD=1.632p PS=10.96u PD=10.96u rfmode=0
M$316 \$I193 \$I153 \$I196 VGND sg13_hv_nmos L=0.45u W=4.8u AS=1.632p AD=1.632p
+ PS=10.96u PD=10.96u rfmode=0
M$319 \$I210 sh_cap_en[0] VPWR VPWR sg13_lv_pmos L=0.13u W=0.3u AS=0.102p
+ AD=0.102p PS=1.28u PD=1.28u rfmode=0
M$320 \$I213 \$I210 VPWR VPWR sg13_lv_pmos L=0.13u W=0.3u AS=0.102p AD=0.102p
+ PS=1.28u PD=1.28u rfmode=0
M$321 \$I214 sh_cap_en[2] VPWR VPWR sg13_lv_pmos L=0.13u W=0.3u AS=0.102p
+ AD=0.102p PS=1.28u PD=1.28u rfmode=0
M$322 \$I217 \$I214 VPWR VPWR sg13_lv_pmos L=0.13u W=0.3u AS=0.102p AD=0.102p
+ PS=1.28u PD=1.28u rfmode=0
M$323 \$I218 sh_cap_en[3] VPWR VPWR sg13_lv_pmos L=0.13u W=0.3u AS=0.102p
+ AD=0.102p PS=1.28u PD=1.28u rfmode=0
M$324 \$I221 \$I218 VPWR VPWR sg13_lv_pmos L=0.13u W=0.3u AS=0.102p AD=0.102p
+ PS=1.28u PD=1.28u rfmode=0
M$325 \$I222 sh_cap_en[1] VPWR VPWR sg13_lv_pmos L=0.13u W=0.3u AS=0.102p
+ AD=0.102p PS=1.28u PD=1.28u rfmode=0
M$326 \$I225 \$I222 VPWR VPWR sg13_lv_pmos L=0.13u W=0.3u AS=0.102p AD=0.102p
+ PS=1.28u PD=1.28u rfmode=0
M$327 \$I226 adc_hold VPWR VPWR sg13_lv_pmos L=0.13u W=0.3u AS=0.102p AD=0.102p
+ PS=1.28u PD=1.28u rfmode=0
M$328 \$I229 \$I226 VPWR VPWR sg13_lv_pmos L=0.13u W=0.3u AS=0.102p AD=0.102p
+ PS=1.28u PD=1.28u rfmode=0
M$329 VGND \$I210 \$I213 VGND sg13_lv_nmos L=0.13u W=0.15u AS=0.1005p
+ AD=0.1005p PS=1.34u PD=1.34u rfmode=0
M$330 VGND sh_cap_en[0] \$I210 VGND sg13_lv_nmos L=0.13u W=0.15u AS=0.1005p
+ AD=0.1005p PS=1.34u PD=1.34u rfmode=0
M$331 VGND \$I214 \$I217 VGND sg13_lv_nmos L=0.13u W=0.15u AS=0.1005p
+ AD=0.1005p PS=1.34u PD=1.34u rfmode=0
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
+ PS=4.68u PD=4.68u rfmode=0
M$834 \$I100 \$I257 \$I256 VGND sg13_hv_nmos L=0.45u W=1u AS=0.34p AD=0.34p
+ PS=2.68u PD=2.68u rfmode=0
M$835 analog_1 \$I277 \$I276 VGND sg13_hv_nmos L=0.45u W=1u AS=0.34p AD=0.34p
+ PS=2.68u PD=2.68u rfmode=0
M$836 analog_0 \$I297 \$I296 VGND sg13_hv_nmos L=0.45u W=1u AS=0.34p AD=0.34p
+ PS=2.68u PD=2.68u rfmode=0
M$837 VAPWR VGND \$I257 VAPWR sg13_hv_pmos L=0.45u W=0.6u AS=0.204p AD=0.204p
+ PS=1.88u PD=1.88u rfmode=0
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
