ThePil0t/heichips26-FAIfplus/macros/heichips26_FAIf/macros/sah_12bit/netlist/pex/sah_12bit_hybrid_pex.spice

* sah_12bit post-layout netlist (hybrid), generated by scripts/layout/hybrid_pex.py
* Magic C(SH_OUT,VSS): bare cap 1477.7 fF, shielded cap 1716.4 fF; model C1 1213.8 fF -> cap environment 196.1 fF
.subckt sah_12bit_pex VDD SH_IN SH_OUT SH_EN VSS CW=54.29e-6 CL=27.72e-6
XMN1 SH_IN sw SH_OUT VSS sg13_hv_nmos w=0.6u l=0.45u ng=2 m=1 as=0.114p ad=0.159p ps=1.36u pd=1.96u
XMP1 SH_IN sw_b SH_OUT VDD sg13_hv_pmos w=1.8u l=0.45u ng=2 m=1 as=0.342p ad=0.477p ps=2.56u pd=3.76u
XMND1 SH_IN sw_b SH_IN VSS sg13_hv_nmos w=0.3u l=0.45u ng=1 m=1 as=0.102p ad=0.057p ps=1.28u pd=0.68u
XMPD1 SH_IN sw_d SH_IN VDD sg13_hv_pmos w=0.9u l=0.45u ng=1 m=1 as=0.306p ad=0.171p ps=2.48u pd=1.28u
XMND2 SH_OUT sw_b SH_OUT VSS sg13_hv_nmos w=0.3u l=0.45u ng=1 m=1 as=0.057p ad=0.057p ps=0.68u pd=0.68u
XMPD2 SH_OUT sw_d SH_OUT VDD sg13_hv_pmos w=0.9u l=0.45u ng=1 m=1 as=0.171p ad=0.171p ps=1.28u pd=1.28u
XMPI1 sw_n SH_EN VDD VDD sg13_hv_pmos w=1.2u l=0.45u ng=1 m=1
XMNI1 sw_n SH_EN VSS VSS sg13_hv_nmos w=0.6u l=0.45u ng=1 m=1
XMPI2 sw sw_n VDD VDD sg13_hv_pmos w=1.2u l=0.45u ng=1 m=1
XMNI2 sw sw_n VSS VSS sg13_hv_nmos w=0.6u l=0.45u ng=1 m=1
XMPI3 sw_b sw VDD VDD sg13_hv_pmos w=1.2u l=0.45u ng=1 m=2
XMNI3 sw_b sw VSS VSS sg13_hv_nmos w=0.6u l=0.45u ng=1 m=2
XMPI4 sw_d sw_b VDD VDD sg13_hv_pmos w=1.2u l=0.45u ng=1 m=2
XMNI4 sw_d sw_b VSS VSS sg13_hv_nmos w=0.6u l=0.45u ng=1 m=2
XC1 SH_OUT VSS cap_cmomi w={CW} l={CL} mmin=1 mmax=3 feed=double subblock=0 m=1 mm_ok=1
* wire parasitics (Magic, C-coupled, layout without the cap and its shield box)
Cw0 SH_OUT sw 0.20725f
Cw1 sw_b sw_d 3.39632f
Cw2 sw_d VDD 0.60587f
Cw3 SH_EN VDD 5.71868f
Cw4 sw_b SH_IN 0.95144f
Cw5 SH_EN sw_n 0.21676f
Cw6 VDD SH_IN 0.54835f
Cw7 SH_OUT sw_d 0.16736f
Cw8 SH_EN VSS 0.10064f
Cw9 SH_OUT SH_IN 0.34880f
Cw10 sw_b VDD 1.14910f
Cw11 sw sw_d 0.29751f
Cw12 sw SH_EN 0.02620f
Cw13 sw SH_IN 0.71975f
Cw14 sw_n VDD 0.44943f
Cw15 sw_b SH_OUT 0.33318f
Cw16 VSS VDD 0.09468f
Cw17 SH_OUT VDD 0.05755f
Cw18 VSS VDD 0.01112f
Cw19 sw_b sw 0.98046f
Cw20 SH_OUT VSS 0.10546f
Cw21 sw VDD 0.98450f
Cw23 sw_d SH_IN 0.20738f
Cw24 SH_OUT VSS 0.89337f
Cw25 SH_EN SH_IN 0.01325f
Cw26 sw sw_n 0.24109f
Cw27 SH_OUT VSS 2.23819f
Cw28 SH_IN VSS 5.09557f
Cw29 VDD VSS 4.49226f
Cenv SH_OUT VSS 196.100f
.ends
