ThePil0t/heichips26-FAIfplus/macros/heichips26_FAIf/macros/r2r_dac/netlist/pex/r2r_dac_magic_pex_3.spice

* PEX produced on Thu Oct  8 16:47:05 CEST 2026 using scripts/sak-pex.sh with m=3 and s=1 (extresist threshold=10000 mOhm, minres=1000 mOhm, mindelay=1 ps)
* NGSPICE file created from r2r_dac_pex.ext - technology: ihp-sg13cmos5l

.subckt r2r_dac_pex IDACIREF nD0 nD1 nD2 nD3 nD4 nD5 nD6 nD7
X0 PDACVDD.t75 a_10714_5055# a_14228_5819# PDACVDD.t0 sg13_hv_pmos ad=0.408p pd=3.08u as=0.228p ps=1.58u w=1.2u l=1.2u
X1 a_12980_5491.t12 a_8700_4135# a_12463_2551# PDACVDD.t0 sg13_hv_pmos ad=0.408p pd=3.08u as=0.228p ps=1.58u w=1.2u l=0.6u
X2 PDACVDD.t121 a_12980_5491.t22 ODACOUT.t5 PDACVDD.t0 sg13_hv_pmos ad=0.816p pd=5.48u as=0.816p ps=5.48u w=2.4u l=0.4u
X3 ODACOUT.t52 a_13474_923.t23 PDACVSS.t231 PDACVSS.t223 sg13_hv_nmos ad=0.408p pd=3.08u as=0.408p ps=3.08u w=1.2u l=0.6u
X4 a_12306_727# a_11732_5491# PDACVSS.t184 PDACVSS.t35 sg13_hv_nmos ad=0.114p pd=0.98u as=0.204p ps=1.88u w=0.6u l=2.4u
X5 a_2050_3288# a_1786_3288# PDACVSS.t1 rhigh l=15u w=0.5u
X6 a_12463_2551# IDACVTAP a_10846_923# PDACVSS.t15 sg13_hv_nmos ad=0.816p pd=5.48u as=0.816p ps=5.48u w=2.4u l=0.45u
X7 PDACVSS.t106 PDACVSS.t100 PDACVSS.t105 PDACVSS.t104 sg13_hv_nmos ad=0.408p pd=3.08u as=0 ps=0 w=1.2u l=0.6u
X8 PDACVSS.t138 PDACVSS.t136 PDACVSS.t137 PDACVSS.t101 sg13_hv_nmos ad=0.408p pd=3.08u as=0 ps=0 w=1.2u l=0.6u
X9 PDACVDD.t65 a_10714_5055# a_11732_5295# PDACVDD.t0 sg13_hv_pmos ad=0.408p pd=3.08u as=0.228p ps=1.58u w=1.2u l=1.2u
X10 PDACVSS.t93 PDACVSS.t91 PDACVSS.t92 PDACVSS.t14 sg13_hv_nmos ad=0.816p pd=5.48u as=0 ps=0 w=2.4u l=0.45u
X11 a_11732_5491# a_8780_247# a_12306_727# PDACVSS.t35 sg13_hv_nmos ad=0.204p pd=1.88u as=0.114p ps=0.98u w=0.6u l=0.6u
X12 a_8968_2247# a_8780_247# PDACVSS.t23 PDACVSS.t22 sg13_hv_nmos ad=0.136p pd=1.48u as=0.136p ps=1.48u w=0.4u l=10u
X13 PDACVSS.t166 a_10180_247# a_10846_727# PDACVSS.t33 sg13_hv_nmos ad=0.204p pd=1.88u as=0.114p ps=0.98u w=0.6u l=2.4u
X14 a_13474_727# a_11732_5491# PDACVSS.t189 PDACVSS.t40 sg13_hv_nmos ad=0.114p pd=0.98u as=0.204p ps=1.88u w=0.6u l=2.4u
X15 PDACVDD.t2 a_10262_923# a_12014_923# PDACVDD.t0 sg13_hv_pmos ad=0.228p pd=1.58u as=0.408p ps=3.08u w=1.2u l=0.6u
X16 PDACVDD.t107 a_12980_5491.t24 ODACOUT.t23 PDACVDD.t0 sg13_hv_pmos ad=0.816p pd=5.48u as=0.816p ps=5.48u w=2.4u l=0.4u
X17 PDACVDD.t138 a_12980_5491.t18 ODACOUT.t15 PDACVDD.t0 sg13_hv_pmos ad=0.816p pd=5.48u as=0.816p ps=5.48u w=2.4u l=0.4u
X18 PDACVDD.t139 a_12980_5491.t18 ODACOUT.t20 PDACVDD.t0 sg13_hv_pmos ad=0.816p pd=5.48u as=0.816p ps=5.48u w=2.4u l=0.4u
X19 PDACVDD.t1 a_15859_6052# a_15859_6052# PDACVDD.t0 sg13_hv_pmos ad=0.816p pd=5.48u as=0.816p ps=5.48u w=2.4u l=0.4u
X20 ODACOUT.t27 a_12980_5491.t21 PDACVDD.t125 PDACVDD.t0 sg13_hv_pmos ad=0.816p pd=5.48u as=0.816p ps=5.48u w=2.4u l=0.4u
X21 a_13474_923.t9 a_8780_247# a_13474_727# PDACVSS.t40 sg13_hv_nmos ad=0.204p pd=1.88u as=0.114p ps=0.98u w=0.6u l=0.6u
X22 PDACVDD.t3 IDACDISABLE a_10262_923# PDACVDD.t0 sg13_hv_pmos ad=0.228p pd=1.58u as=0.408p ps=3.08u w=1.2u l=0.6u
X23 a_6010_3288# a_5746_3288# PDACVSS.t194 rhigh l=15u w=0.5u
X24 ODACOUT.t51 a_13474_923.t23 PDACVSS.t230 PDACVSS.t221 sg13_hv_nmos ad=0.408p pd=3.08u as=0.408p ps=3.08u w=1.2u l=0.6u
X25 PDACVSS.t246 a_13474_923.t20 ODACOUT.t33 PDACVSS.t223 sg13_hv_nmos ad=0.408p pd=3.08u as=0.408p ps=3.08u w=1.2u l=0.6u
X26 a_11732_5295# a_8700_4135# a_11732_5491# PDACVDD.t0 sg13_hv_pmos ad=0.228p pd=1.58u as=0.408p ps=3.08u w=1.2u l=0.6u
X27 PDACVSS.t226 a_13474_923.t24 ODACOUT.t42 PDACVSS.t225 sg13_hv_nmos ad=0.408p pd=3.08u as=0.408p ps=3.08u w=1.2u l=0.6u
X28 ODACOUT.t4 a_12980_5491.t17 PDACVDD.t142 PDACVDD.t0 sg13_hv_pmos ad=0.816p pd=5.48u as=0.816p ps=5.48u w=2.4u l=0.4u
X29 a_1258_3288# a_994_3288# PDACVSS.t10 rhigh l=15u w=0.5u
X30 PDACVSS.t207 IDACIREF PDACVSS.t206 PDACVSS.t205 sg13_hv_nmos ad=0.204p pd=1.88u as=0 ps=0 w=0.6u l=2.4u
X31 PDACVSS.t167 a_10180_247# a_10846_727# PDACVSS.t34 sg13_hv_nmos ad=0.204p pd=1.88u as=0.114p ps=0.98u w=0.6u l=2.4u
X32 PDACVSS.t182 a_11732_5491# a_13474_727# PDACVSS.t41 sg13_hv_nmos ad=0.204p pd=1.88u as=0.114p ps=0.98u w=0.6u l=2.4u
X33 PDACVDD.t12 PDACVDD.t10 PDACVDD.t11 PDACVDD.t0 sg13_hv_pmos ad=0.816p pd=5.48u as=0 ps=0 w=2.4u l=0.4u
X34 PDACVDD.t57 PDACVDD.t52 PDACVDD.t56 PDACVDD.t0 sg13_hv_pmos ad=0.816p pd=5.48u as=0 ps=0 w=2.4u l=0.4u
X35 PDACVDD.t64 a_10714_5055# a_11732_5295# PDACVDD.t0 sg13_hv_pmos ad=0.408p pd=3.08u as=0.228p ps=1.58u w=1.2u l=1.2u
X36 a_11108_5819# a_8700_4135# a_10714_5055# PDACVDD.t0 sg13_hv_pmos ad=0.228p pd=1.58u as=0.408p ps=3.08u w=1.2u l=0.6u
X37 a_11732_5491# a_8700_4135# a_11732_5295# PDACVDD.t0 sg13_hv_pmos ad=0.408p pd=3.08u as=0.228p ps=1.58u w=1.2u l=0.6u
X38 a_11732_5295# op_amp_ver_2_0.IOAM a_10846_923# PDACVSS.t14 sg13_hv_nmos ad=0.816p pd=5.48u as=0.816p ps=5.48u w=2.4u l=0.45u
X39 PDACVSS.t147 PDACVSS.t145 PDACVSS.t146 PDACVSS.t108 sg13_hv_nmos ad=0.408p pd=3.08u as=0 ps=0 w=1.2u l=0.6u
X40 ODACOUT.t38 a_13474_923.t19 PDACVSS.t251 PDACVSS.t223 sg13_hv_nmos ad=0.408p pd=3.08u as=0.408p ps=3.08u w=1.2u l=0.6u
X41 PDACVSS.t135 PDACVSS.t133 PDACVSS.t134 PDACVSS.t108 sg13_hv_nmos ad=0.408p pd=3.08u as=0 ps=0 w=1.2u l=0.6u
X42 a_10846_727# a_10180_247# PDACVSS.t171 PDACVSS.t33 sg13_hv_nmos ad=0.114p pd=0.98u as=0.204p ps=1.88u w=0.6u l=2.4u
X43 PDACVDD.t71 a_10714_5055# a_11108_5819# PDACVDD.t0 sg13_hv_pmos ad=0.408p pd=3.08u as=0.228p ps=1.58u w=1.2u l=1.2u
X44 a_12306_727# a_8780_247# a_11732_5491# PDACVSS.t36 sg13_hv_nmos ad=0.114p pd=0.98u as=0.204p ps=1.88u w=0.6u l=0.6u
X45 PDACVSS.t245 a_13474_923.t20 ODACOUT.t48 PDACVSS.t221 sg13_hv_nmos ad=0.408p pd=3.08u as=0.408p ps=3.08u w=1.2u l=0.6u
X46 a_10846_923# a_8780_247# a_10846_727# PDACVSS.t33 sg13_hv_nmos ad=0.204p pd=1.88u as=0.114p ps=0.98u w=0.6u l=0.6u
X47 PDACVDD.t9 PDACVDD.t7 PDACVDD.t8 PDACVDD.t0 sg13_hv_pmos ad=0.816p pd=5.48u as=0 ps=0 w=2.4u l=0.4u
X48 ODACOUT.t24 a_12980_5491.t21 PDACVDD.t123 PDACVDD.t0 sg13_hv_pmos ad=0.816p pd=5.48u as=0.816p ps=5.48u w=2.4u l=0.4u
X49 ODACOUT.t21 a_12980_5491.t21 PDACVDD.t124 PDACVDD.t0 sg13_hv_pmos ad=0.816p pd=5.48u as=0.816p ps=5.48u w=2.4u l=0.4u
X50 PDACVDD.t60 PDACVDD.t58 PDACVDD.t59 PDACVDD.t0 sg13_hv_pmos ad=0.816p pd=5.48u as=0 ps=0 w=2.4u l=0.4u
X51 a_5218_3288# a_4954_3288# PDACVSS.t218 rhigh l=15u w=0.5u
X52 a_12306_727# a_11732_5491# PDACVSS.t186 PDACVSS.t37 sg13_hv_nmos ad=0.114p pd=0.98u as=0.204p ps=1.88u w=0.6u l=2.4u
X53 a_7280_4421# IDACDISABLE ODACOUT w_7156_4139# sg13_hv_pmos ad=0.68p pd=4.68u as=0.68p ps=4.68u w=2u l=0.45u
X54 a_11732_5491# a_8780_247# a_12306_727# PDACVSS.t37 sg13_hv_nmos ad=0.204p pd=1.88u as=0.114p ps=0.98u w=0.6u l=0.6u
X55 a_994_3288# a_730_3288# PDACVSS.t192 rhigh l=15u w=0.5u
X56 a_12014_1063# a_12014_1063# a_15606_247# PDACVSS.t104 sg13_hv_nmos ad=0.408p pd=3.08u as=0.408p ps=3.08u w=1.2u l=0.6u
X57 a_4426_3288# a_4162_3288# PDACVSS.t0 rhigh l=15u w=0.5u
X58 PDACVSS.t178 a_11732_5491# a_12306_727# PDACVSS.t37 sg13_hv_nmos ad=0.204p pd=1.88u as=0.114p ps=0.98u w=0.6u l=2.4u
X59 a_13474_727# a_11732_5491# PDACVSS.t191 PDACVSS.t42 sg13_hv_nmos ad=0.114p pd=0.98u as=0.204p ps=1.88u w=0.6u l=2.4u
X60 PDACVDD.t54 PDACVDD.t52 PDACVDD.t53 PDACVDD.t0 sg13_hv_pmos ad=0.816p pd=5.48u as=0 ps=0 w=2.4u l=0.4u
X61 a_12463_2551# a_8700_4135# a_12980_5491.t8 PDACVDD.t0 sg13_hv_pmos ad=0.228p pd=1.58u as=0.408p ps=3.08u w=1.2u l=0.6u
X62 PDACVSS.t90 PDACVSS.t88 PDACVSS.t89 PDACVSS.t63 sg13_hv_nmos ad=0.408p pd=3.08u as=0 ps=0 w=1.2u l=0.45u
X63 PDACVSS.t234 a_13474_923.t22 ODACOUT.t47 PDACVSS.t219 sg13_hv_nmos ad=0.408p pd=3.08u as=0.408p ps=3.08u w=1.2u l=0.6u
X64 a_13474_923.t11 a_8780_247# a_13474_727# PDACVSS.t42 sg13_hv_nmos ad=0.204p pd=1.88u as=0.114p ps=0.98u w=0.6u l=0.6u
X65 PDACVDD.t127 a_12980_5491.t20 ODACOUT.t10 PDACVDD.t0 sg13_hv_pmos ad=0.816p pd=5.48u as=0.816p ps=5.48u w=2.4u l=0.4u
X66 PDACVSS.t60 a_10180_247# PDACVSS.t160 PDACVSS.t57 sg13_hv_nmos ad=0.204p pd=1.88u as=0 ps=0 w=0.6u l=2.4u
X67 PDACVSS.t132 PDACVSS.t130 PDACVSS.t131 PDACVSS.t101 sg13_hv_nmos ad=0.408p pd=3.08u as=0 ps=0 w=1.2u l=0.6u
X68 a_13474_923.t3 a_12014_923# a_12980_5491.t2 PDACVDD.t0 sg13_hv_pmos ad=0.816p pd=5.48u as=0.816p ps=5.48u w=2.4u l=0.4u
X69 PDACVSS.t48 PDACVSS.t49 PDACVSS.t47 rhigh l=15u w=0.5u
X70 a_3634_3288# a_3370_3288# PDACVSS.t11 rhigh l=15u w=0.5u
X71 a_10846_923# op_amp_ver_2_0.IOAM a_11732_5295# PDACVSS.t15 sg13_hv_nmos ad=0.816p pd=5.48u as=0.816p ps=5.48u w=2.4u l=0.45u
X72 PDACVDD.t74 a_10714_5055# a_12463_2551# PDACVDD.t0 sg13_hv_pmos ad=0.408p pd=3.08u as=0.228p ps=1.58u w=1.2u l=1.2u
X73 PDACVDD.t110 a_12980_5491.t24 ODACOUT.t13 PDACVDD.t0 sg13_hv_pmos ad=0.816p pd=5.48u as=0.816p ps=5.48u w=2.4u l=0.4u
X74 PDACVDD.t141 a_12980_5491.t18 ODACOUT.t4 PDACVDD.t0 sg13_hv_pmos ad=0.816p pd=5.48u as=0.816p ps=5.48u w=2.4u l=0.4u
X75 PDACVSS.t144 PDACVSS.t142 PDACVSS.t143 PDACVSS.t101 sg13_hv_nmos ad=0.408p pd=3.08u as=0 ps=0 w=1.2u l=0.6u
X76 PDACVSS.t75 PDACVSS.t72 PDACVSS.t74 PDACVSS.t73 sg13_hv_nmos ad=0.408p pd=3.08u as=0 ps=0 w=1.2u l=0.45u
X77 a_2842_3288# a_2578_3288# PDACVSS.t4 rhigh l=15u w=0.5u
X78 a_12463_2551# a_10714_5055# PDACVDD.t86 PDACVDD.t0 sg13_hv_pmos ad=0.228p pd=1.58u as=0.408p ps=3.08u w=1.2u l=1.2u
X79 PDACVDD.t36 PDACVDD.t34 PDACVDD.t35 PDACVDD.t0 sg13_hv_pmos ad=0.816p pd=5.48u as=0 ps=0 w=2.4u l=0.4u
X80 ODACOUT.t45 a_13474_923.t21 PDACVSS.t241 PDACVSS.t223 sg13_hv_nmos ad=0.408p pd=3.08u as=0.408p ps=3.08u w=1.2u l=0.6u
X81 ODACOUT.t39 a_13474_923.t17 PDACVSS.t260 PDACVSS.t221 sg13_hv_nmos ad=0.408p pd=3.08u as=0.408p ps=3.08u w=1.2u l=0.6u
X82 a_12980_5491.t13 a_12014_1063# a_13474_923.t13 PDACVSS.t104 sg13_hv_nmos ad=0.408p pd=3.08u as=0.408p ps=3.08u w=1.2u l=0.6u
X83 a_9552_4067# a_8700_4135# a_8700_4135# PDACVDD.t0 sg13_hv_pmos ad=0.34p pd=2.68u as=0.34p ps=2.68u w=1u l=10u
X84 a_11732_5295# a_10714_5055# PDACVDD.t83 PDACVDD.t0 sg13_hv_pmos ad=0.228p pd=1.58u as=0.408p ps=3.08u w=1.2u l=1.2u
X85 ODACOUT.t16 a_12980_5491.t17 PDACVDD.t145 PDACVDD.t0 sg13_hv_pmos ad=0.816p pd=5.48u as=0.816p ps=5.48u w=2.4u l=0.4u
X86 PDACVSS.t18 a_8780_247# PDACVSS.t17 PDACVSS.t16 sg13_hv_nmos ad=0.136p pd=1.48u as=0 ps=0 w=0.4u l=10u
X87 PDACVSS.t21 a_10180_247# PDACVSS.t161 PDACVSS.t19 sg13_hv_nmos ad=0.204p pd=1.88u as=0 ps=0 w=0.6u l=2.4u
X88 a_10554_727# a_10180_247# PDACVSS.t168 PDACVSS.t19 sg13_hv_nmos ad=0.114p pd=0.98u as=0.204p ps=1.88u w=0.6u l=2.4u
X89 PDACVSS.t78 PDACVSS.t76 PDACVSS.t77 PDACVSS.t63 sg13_hv_nmos ad=0.408p pd=3.08u as=0 ps=0 w=1.2u l=0.45u
X90 PDACVDD.t70 a_10714_5055# PDACVDD.t69 PDACVDD.t0 sg13_hv_pmos ad=0.228p pd=1.58u as=0 ps=0 w=1.2u l=1.2u
X91 a_7384_3755# IDACDISABLE PDACVSS.t56 PDACVSS.t55 sg13_hv_nmos ad=0.102p pd=1.28u as=0.102p ps=1.28u w=0.3u l=0.45u
X92 ODACOUT.t36 a_13474_923.t23 PDACVSS.t233 PDACVSS.t227 sg13_hv_nmos ad=0.408p pd=3.08u as=0.408p ps=3.08u w=1.2u l=0.6u
X93 PDACVSS.t257 a_13474_923.t18 ODACOUT.t50 PDACVSS.t225 sg13_hv_nmos ad=0.408p pd=3.08u as=0.408p ps=3.08u w=1.2u l=0.6u
X94 a_11732_5295# a_8700_4135# a_11732_5491# PDACVDD.t0 sg13_hv_pmos ad=0.228p pd=1.58u as=0.408p ps=3.08u w=1.2u l=0.6u
X95 a_10180_247# a_8780_247# a_10554_727# PDACVSS.t19 sg13_hv_nmos ad=0.204p pd=1.88u as=0.114p ps=0.98u w=0.6u l=0.6u
X96 PDACVDD.t33 PDACVDD.t31 PDACVDD.t32 PDACVDD.t0 sg13_hv_pmos ad=0.816p pd=5.48u as=0 ps=0 w=2.4u l=0.4u
X97 a_6802_3288# op_amp_ver_2_0.IOAM PDACVSS.t199 rhigh l=15u w=0.5u
X98 PDACVDD.t108 a_12980_5491.t24 ODACOUT.t28 PDACVDD.t0 sg13_hv_pmos ad=0.816p pd=5.48u as=0.816p ps=5.48u w=2.4u l=0.4u
X99 PDACVDD.t109 a_12980_5491.t24 ODACOUT.t19 PDACVDD.t0 sg13_hv_pmos ad=0.816p pd=5.48u as=0.816p ps=5.48u w=2.4u l=0.4u
X100 ODACOUT.t23 a_12980_5491.t23 PDACVDD.t112 PDACVDD.t0 sg13_hv_pmos ad=0.816p pd=5.48u as=0.816p ps=5.48u w=2.4u l=0.4u
X101 a_10846_923# IDACVTAP a_12463_2551# PDACVSS.t14 sg13_hv_nmos ad=0.816p pd=5.48u as=0.816p ps=5.48u w=2.4u l=0.45u
X102 a_12014_727# a_10180_247# PDACVSS.t173 PDACVSS.t46 sg13_hv_nmos ad=0.114p pd=0.98u as=0.204p ps=1.88u w=0.6u l=2.4u
X103 PDACVDD.t63 a_10714_5055# a_11732_5295# PDACVDD.t0 sg13_hv_pmos ad=0.408p pd=3.08u as=0.228p ps=1.58u w=1.2u l=1.2u
X104 a_15859_6052# a_12014_923# a_12014_923# PDACVDD.t0 sg13_hv_pmos ad=0.816p pd=5.48u as=0.816p ps=5.48u w=2.4u l=0.4u
X105 a_10846_727# a_8780_247# a_10846_923# PDACVSS.t33 sg13_hv_nmos ad=0.114p pd=0.98u as=0.204p ps=1.88u w=0.6u l=0.6u
X106 PDACVDD.t97 a_8700_4135# PDACVDD.t96 PDACVDD.t0 sg13_hv_pmos ad=0.34p pd=2.68u as=0 ps=0 w=1u l=10u
X107 ODACOUT.t5 a_12980_5491.t21 PDACVDD.t126 PDACVDD.t0 sg13_hv_pmos ad=0.816p pd=5.48u as=0.816p ps=5.48u w=2.4u l=0.4u
X108 PDACVSS.t164 a_10180_247# a_10846_727# PDACVSS.t31 sg13_hv_nmos ad=0.204p pd=1.88u as=0.114p ps=0.98u w=0.6u l=2.4u
X109 ODACOUT.t44 a_13474_923.t21 PDACVSS.t240 PDACVSS.t221 sg13_hv_nmos ad=0.408p pd=3.08u as=0.408p ps=3.08u w=1.2u l=0.6u
X110 PDACVSS.t237 a_13474_923.t22 ODACOUT.t54 PDACVSS.t225 sg13_hv_nmos ad=0.408p pd=3.08u as=0.408p ps=3.08u w=1.2u l=0.6u
X111 a_12014_923# a_8780_247# a_12014_727# PDACVSS.t46 sg13_hv_nmos ad=0.204p pd=1.88u as=0.114p ps=0.98u w=0.6u l=0.6u
X112 PDACVSS.t254 a_13474_923.t18 ODACOUT.t35 PDACVSS.t219 sg13_hv_nmos ad=0.408p pd=3.08u as=0.408p ps=3.08u w=1.2u l=0.6u
X113 a_13474_727# a_11732_5491# PDACVSS.t188 PDACVSS.t39 sg13_hv_nmos ad=0.114p pd=0.98u as=0.204p ps=1.88u w=0.6u l=2.4u
X114 a_4162_3288# a_3370_3288# PDACVSS.t12 rhigh l=15u w=0.5u
X115 PDACVSS.t248 a_13474_923.t20 ODACOUT.t46 PDACVSS.t227 sg13_hv_nmos ad=0.408p pd=3.08u as=0.408p ps=3.08u w=1.2u l=0.6u
X116 a_13474_923.t8 a_8780_247# a_13474_727# PDACVSS.t39 sg13_hv_nmos ad=0.204p pd=1.88u as=0.114p ps=0.98u w=0.6u l=0.6u
X117 a_12980_5491.t10 a_8700_4135# a_12463_2551# PDACVDD.t0 sg13_hv_pmos ad=0.408p pd=3.08u as=0.228p ps=1.58u w=1.2u l=0.6u
X118 PDACVDD.t18 PDACVDD.t16 PDACVDD.t17 PDACVDD.t0 sg13_hv_pmos ad=0.816p pd=5.48u as=0 ps=0 w=2.4u l=0.4u
X119 ODACOUT.t7 a_12980_5491.t17 PDACVDD.t143 PDACVDD.t0 sg13_hv_pmos ad=0.816p pd=5.48u as=0.816p ps=5.48u w=2.4u l=0.4u
X120 ODACOUT.t14 a_12980_5491.t17 PDACVDD.t144 PDACVDD.t0 sg13_hv_pmos ad=0.816p pd=5.48u as=0.816p ps=5.48u w=2.4u l=0.4u
X121 PDACVSS.t110 PDACVSS.t107 PDACVSS.t109 PDACVSS.t108 sg13_hv_nmos ad=0.408p pd=3.08u as=0 ps=0 w=1.2u l=0.6u
X122 a_11732_5491# a_8700_4135# a_11732_5295# PDACVDD.t0 sg13_hv_pmos ad=0.408p pd=3.08u as=0.228p ps=1.58u w=1.2u l=0.6u
X123 PDACVDD.t130 a_12980_5491.t20 ODACOUT.t11 PDACVDD.t0 sg13_hv_pmos ad=0.816p pd=5.48u as=0.816p ps=5.48u w=2.4u l=0.4u
X124 a_3370_3288# a_2578_3288# PDACVSS.t2 rhigh l=15u w=0.5u
X125 a_13474_727# a_8780_247# a_13474_923.t6 PDACVSS.t41 sg13_hv_nmos ad=0.114p pd=0.98u as=0.204p ps=1.88u w=0.6u l=0.6u
X126 a_10846_727# a_8780_247# a_10846_923# PDACVSS.t34 sg13_hv_nmos ad=0.114p pd=0.98u as=0.204p ps=1.88u w=0.6u l=0.6u
X127 PDACVDD.t102 a_8700_4135# PDACVDD.t70 PDACVDD.t0 sg13_hv_pmos ad=0.408p pd=3.08u as=0 ps=0 w=1.2u l=0.6u
X128 a_8780_247# a_8780_247# a_9424_2247# PDACVSS.t27 sg13_hv_nmos ad=0.136p pd=1.48u as=0.136p ps=1.48u w=0.4u l=10u
X129 PDACVDD.t15 PDACVDD.t13 PDACVDD.t14 PDACVDD.t0 sg13_hv_pmos ad=0.816p pd=5.48u as=0 ps=0 w=2.4u l=0.4u
X130 IDACIREF IDACIREF PDACVSS.t209 PDACVSS.t208 sg13_hv_nmos ad=0.204p pd=1.88u as=0.204p ps=1.88u w=0.6u l=2.4u
X131 PDACVSS.t183 a_11732_5491# a_13474_727# PDACVSS.t42 sg13_hv_nmos ad=0.204p pd=1.88u as=0.114p ps=0.98u w=0.6u l=2.4u
X132 PDACVSS.t159 PDACVSS.t157 PDACVSS.t158 PDACVSS.t108 sg13_hv_nmos ad=0.408p pd=3.08u as=0 ps=0 w=1.2u l=0.6u
X133 ODACOUT.t40 a_13474_923.t17 PDACVSS.t261 PDACVSS.t223 sg13_hv_nmos ad=0.408p pd=3.08u as=0.408p ps=3.08u w=1.2u l=0.6u
X134 a_13474_923.t16 a_12014_1063# a_12980_5491.t16 PDACVSS.t104 sg13_hv_nmos ad=0.408p pd=3.08u as=0.408p ps=3.08u w=1.2u l=0.6u
X135 PDACVSS.t202 PDACVSS.t203 PDACVSS.t201 rhigh l=15u w=0.5u
X136 PDACVSS.t30 a_8780_247# PDACVSS.t29 PDACVSS.t28 sg13_hv_nmos ad=0.136p pd=1.48u as=0 ps=0 w=0.4u l=10u
X137 PDACVSS.t103 PDACVSS.t100 PDACVSS.t102 PDACVSS.t101 sg13_hv_nmos ad=0.408p pd=3.08u as=0 ps=0 w=1.2u l=0.6u
X138 PDACVDD.t92 a_10714_5055# PDACVDD.t91 PDACVDD.t0 sg13_hv_pmos ad=0.228p pd=1.58u as=0 ps=0 w=1.2u l=1.2u
X139 a_12463_2551# a_10714_5055# PDACVDD.t85 PDACVDD.t0 sg13_hv_pmos ad=0.228p pd=1.58u as=0.408p ps=3.08u w=1.2u l=1.2u
X140 a_2578_3288# a_1786_3288# PDACVSS.t51 rhigh l=15u w=0.5u
X141 a_10846_727# a_10180_247# PDACVSS.t170 PDACVSS.t32 sg13_hv_nmos ad=0.114p pd=0.98u as=0.204p ps=1.88u w=0.6u l=2.4u
X142 a_12463_2551# a_10714_5055# PDACVDD.t87 PDACVDD.t0 sg13_hv_pmos ad=0.228p pd=1.58u as=0.408p ps=3.08u w=1.2u l=1.2u
X143 PDACVDD.t128 a_12980_5491.t20 ODACOUT.t12 PDACVDD.t0 sg13_hv_pmos ad=0.816p pd=5.48u as=0.816p ps=5.48u w=2.4u l=0.4u
X144 PDACVDD.t129 a_12980_5491.t20 ODACOUT.t3 PDACVDD.t0 sg13_hv_pmos ad=0.816p pd=5.48u as=0.816p ps=5.48u w=2.4u l=0.4u
X145 a_12306_727# a_8780_247# a_11732_5491# PDACVSS.t37 sg13_hv_nmos ad=0.114p pd=0.98u as=0.204p ps=1.88u w=0.6u l=0.6u
X146 a_10846_923# a_8780_247# a_10846_727# PDACVSS.t32 sg13_hv_nmos ad=0.204p pd=1.88u as=0.114p ps=0.98u w=0.6u l=0.6u
X147 ODACOUT.t9 a_12980_5491.t23 PDACVDD.t115 PDACVDD.t0 sg13_hv_pmos ad=0.816p pd=5.48u as=0.816p ps=5.48u w=2.4u l=0.4u
X148 PDACVSS.t84 PDACVSS.t82 PDACVSS.t83 PDACVSS.t63 sg13_hv_nmos ad=0.408p pd=3.08u as=0 ps=0 w=1.2u l=0.45u
X149 PDACVSS.t44 PDACVSS.t120 PDACVSS.t121 PDACVSS.t43 sg13_hv_nmos ad=0.204p pd=1.88u as=0 ps=0 w=0.6u l=2.4u
X150 a_12306_727# a_11732_5491# PDACVSS.t185 PDACVSS.t36 sg13_hv_nmos ad=0.114p pd=0.98u as=0.204p ps=1.88u w=0.6u l=2.4u
X151 PDACVDD.t111 a_12980_5491.t24 ODACOUT.t18 PDACVDD.t0 sg13_hv_pmos ad=0.816p pd=5.48u as=0.816p ps=5.48u w=2.4u l=0.4u
X152 a_1786_3288# a_994_3288# PDACVSS.t5 rhigh l=15u w=0.5u
X153 PDACVSS.t258 a_13474_923.t18 ODACOUT.t32 PDACVSS.t227 sg13_hv_nmos ad=0.408p pd=3.08u as=0.408p ps=3.08u w=1.2u l=0.6u
X154 PDACVSS.t60 IDACDISABLE IDACIREF PDACVSS.t57 sg13_hv_nmos ad=0.114p pd=0.98u as=0.204p ps=1.88u w=0.6u l=0.6u
X155 PDACVSS.t224 a_13474_923.t24 ODACOUT.t59 PDACVSS.t223 sg13_hv_nmos ad=0.408p pd=3.08u as=0.408p ps=3.08u w=1.2u l=0.6u
X156 ODACOUT.t36 a_13474_923.t23 PDACVSS.t229 PDACVSS.t219 sg13_hv_nmos ad=0.408p pd=3.08u as=0.408p ps=3.08u w=1.2u l=0.6u
X157 op_amp_ver_2_0.IOAM a_5746_3288# PDACVSS.t54 rhigh l=15u w=0.5u
X158 PDACVSS.t59 a_10180_247# PDACVSS.t162 PDACVSS.t46 sg13_hv_nmos ad=0.204p pd=1.88u as=0 ps=0 w=0.6u l=2.4u
X159 a_11732_5491# a_8780_247# a_12306_727# PDACVSS.t36 sg13_hv_nmos ad=0.204p pd=1.88u as=0.114p ps=0.98u w=0.6u l=0.6u
X160 ODACOUT.t10 a_12980_5491.t19 PDACVDD.t132 PDACVDD.t0 sg13_hv_pmos ad=0.816p pd=5.48u as=0.816p ps=5.48u w=2.4u l=0.4u
X161 a_12980_5491.t3 a_12014_923# a_13474_923.t2 PDACVDD.t0 sg13_hv_pmos ad=0.816p pd=5.48u as=0.816p ps=5.48u w=2.4u l=0.4u
X162 a_13474_727# a_11732_5491# PDACVSS.t190 PDACVSS.t41 sg13_hv_nmos ad=0.114p pd=0.98u as=0.204p ps=1.88u w=0.6u l=2.4u
X163 ODACOUT.t4 a_12980_5491.t17 PDACVDD.t146 PDACVDD.t0 sg13_hv_pmos ad=0.816p pd=5.48u as=0.816p ps=5.48u w=2.4u l=0.4u
X164 PDACVSS.t156 PDACVSS.t154 PDACVSS.t155 PDACVSS.t101 sg13_hv_nmos ad=0.408p pd=3.08u as=0 ps=0 w=1.2u l=0.6u
X165 ODACOUT.t58 a_13474_923.t19 PDACVSS.t252 PDACVSS.t225 sg13_hv_nmos ad=0.408p pd=3.08u as=0.408p ps=3.08u w=1.2u l=0.6u
X166 a_12463_2551# a_8700_4135# a_12980_5491.t6 PDACVDD.t0 sg13_hv_pmos ad=0.228p pd=1.58u as=0.408p ps=3.08u w=1.2u l=0.6u
X167 a_5746_3288# a_4954_3288# PDACVSS.t175 rhigh l=15u w=0.5u
X168 ODACOUT.t47 a_13474_923.t21 PDACVSS.t243 PDACVSS.t227 sg13_hv_nmos ad=0.408p pd=3.08u as=0.408p ps=3.08u w=1.2u l=0.6u
X169 a_13474_923.t10 a_8780_247# a_13474_727# PDACVSS.t41 sg13_hv_nmos ad=0.204p pd=1.88u as=0.114p ps=0.98u w=0.6u l=0.6u
X170 PDACVSS.t196 PDACVSS.t197 PDACVSS.t195 rhigh l=14u w=0.5u
X171 PDACVDD.t92 a_8700_4135# PDACVDD.t106 PDACVDD.t0 sg13_hv_pmos ad=0.408p pd=3.08u as=0 ps=0 w=1.2u l=0.6u
X172 PDACVSS.t21 a_8780_247# PDACVSS.t20 PDACVSS.t19 sg13_hv_nmos ad=0.114p pd=0.98u as=0 ps=0 w=0.6u l=0.6u
X173 a_11732_5295# a_8700_4135# a_11732_5491# PDACVDD.t0 sg13_hv_pmos ad=0.228p pd=1.58u as=0.408p ps=3.08u w=1.2u l=0.6u
X174 a_12980_5491.t9 a_8700_4135# a_12463_2551# PDACVDD.t0 sg13_hv_pmos ad=0.408p pd=3.08u as=0.228p ps=1.58u w=1.2u l=0.6u
X175 a_11420_5295# a_10714_5055# PDACVDD.t80 PDACVDD.t0 sg13_hv_pmos ad=0.228p pd=1.58u as=0.408p ps=3.08u w=1.2u l=1.2u
X176 PDACVDD.t42 PDACVDD.t40 PDACVDD.t41 PDACVDD.t0 sg13_hv_pmos ad=0.816p pd=5.48u as=0 ps=0 w=2.4u l=0.4u
X177 PDACVSS.t116 PDACVSS.t111 PDACVSS.t115 PDACVSS.t104 sg13_hv_nmos ad=0.408p pd=3.08u as=0 ps=0 w=1.2u l=0.6u
X178 PDACVSS.t244 a_13474_923.t20 ODACOUT.t46 PDACVSS.t219 sg13_hv_nmos ad=0.408p pd=3.08u as=0.408p ps=3.08u w=1.2u l=0.6u
X179 PDACVDD.t62 a_10714_5055# a_12463_2551# PDACVDD.t0 sg13_hv_pmos ad=0.408p pd=3.08u as=0.228p ps=1.58u w=1.2u l=1.2u
X180 a_12980_5491.t11 a_8700_4135# a_12463_2551# PDACVDD.t0 sg13_hv_pmos ad=0.408p pd=3.08u as=0.228p ps=1.58u w=1.2u l=0.6u
X181 ODACOUT.t6 a_12980_5491.t23 PDACVDD.t113 PDACVDD.t0 sg13_hv_pmos ad=0.816p pd=5.48u as=0.816p ps=5.48u w=2.4u l=0.4u
X182 ODACOUT.t17 a_12980_5491.t23 PDACVDD.t114 PDACVDD.t0 sg13_hv_pmos ad=0.816p pd=5.48u as=0.816p ps=5.48u w=2.4u l=0.4u
X183 a_4954_3288# a_4162_3288# PDACVSS.t3 rhigh l=15u w=0.5u
X184 PDACVSS.t222 a_13474_923.t24 ODACOUT.t41 PDACVSS.t221 sg13_hv_nmos ad=0.408p pd=3.08u as=0.408p ps=3.08u w=1.2u l=0.6u
X185 PDACVSS.t176 a_11732_5491# a_12306_727# PDACVSS.t35 sg13_hv_nmos ad=0.204p pd=1.88u as=0.114p ps=0.98u w=0.6u l=2.4u
X186 PDACVSS.t58 a_10180_247# PDACVSS.t163 PDACVSS.t57 sg13_hv_nmos ad=0.114p pd=0.98u as=0 ps=0 w=0.6u l=2.4u
X187 PDACVDD.t68 a_8700_4135# PDACVDD.t98 PDACVDD.t0 sg13_hv_pmos ad=0.228p pd=1.58u as=0 ps=0 w=1.2u l=0.6u
X188 ODACOUT.t46 a_13474_923.t19 PDACVSS.t249 PDACVSS.t219 sg13_hv_nmos ad=0.408p pd=3.08u as=0.408p ps=3.08u w=1.2u l=0.6u
X189 PDACVDD.t72 a_10714_5055# a_11732_5295# PDACVDD.t0 sg13_hv_pmos ad=0.408p pd=3.08u as=0.228p ps=1.58u w=1.2u l=1.2u
X190 a_9272_2247# a_8780_247# a_9120_2247# PDACVSS.t25 sg13_hv_nmos ad=0.136p pd=1.48u as=0.136p ps=1.48u w=0.4u l=10u
X191 a_10262_923# IDACDISABLE PDACVSS.t58 PDACVSS.t57 sg13_hv_nmos ad=0.204p pd=1.88u as=0.114p ps=0.98u w=0.6u l=0.6u
X192 PDACVSS.t179 a_11732_5491# a_12306_727# PDACVSS.t38 sg13_hv_nmos ad=0.204p pd=1.88u as=0.114p ps=0.98u w=0.6u l=2.4u
X193 PDACVDD.t68 a_10714_5055# PDACVDD.t67 PDACVDD.t0 sg13_hv_pmos ad=0.408p pd=3.08u as=0 ps=0 w=1.2u l=1.2u
X194 a_730_3288# a_466_3288# PDACVSS.t174 rhigh l=15u w=0.5u
X195 PDACVSS.t71 PDACVSS.t66 PDACVSS.t70 PDACVSS.t15 sg13_hv_nmos ad=0.816p pd=5.48u as=0 ps=0 w=2.4u l=0.45u
X196 PDACVSS.t99 PDACVSS.t97 PDACVSS.t98 PDACVSS.t73 sg13_hv_nmos ad=0.408p pd=3.08u as=0 ps=0 w=1.2u l=0.45u
X197 PDACVDD.t39 PDACVDD.t37 PDACVDD.t38 PDACVDD.t0 sg13_hv_pmos ad=0.816p pd=5.48u as=0 ps=0 w=2.4u l=0.4u
X198 PDACVSS.t129 PDACVSS.t127 PDACVSS.t128 PDACVSS.t108 sg13_hv_nmos ad=0.408p pd=3.08u as=0 ps=0 w=1.2u l=0.6u
X199 a_10846_727# a_8780_247# a_10846_923# PDACVSS.t31 sg13_hv_nmos ad=0.114p pd=0.98u as=0.204p ps=1.88u w=0.6u l=0.6u
X200 PDACVDD.t117 a_12980_5491.t22 ODACOUT.t1 PDACVDD.t0 sg13_hv_pmos ad=0.816p pd=5.48u as=0.816p ps=5.48u w=2.4u l=0.4u
X201 a_9424_2247# a_8780_247# a_9272_2247# PDACVSS.t26 sg13_hv_nmos ad=0.136p pd=1.48u as=0.136p ps=1.48u w=0.4u l=10u
X202 a_10714_5055# IDACIREF PDACVSS.t214 PDACVSS.t213 sg13_hv_nmos ad=0.204p pd=1.88u as=0.204p ps=1.88u w=0.6u l=2.4u
X203 a_9280_4067# a_8700_4135# a_9552_4067# PDACVDD.t0 sg13_hv_pmos ad=0.34p pd=2.68u as=0.34p ps=2.68u w=1u l=10u
X204 a_13474_923.t1 a_12014_923# a_12980_5491.t0 PDACVDD.t0 sg13_hv_pmos ad=0.816p pd=5.48u as=0.816p ps=5.48u w=2.4u l=0.4u
X205 ODACOUT.t43 a_13474_923.t23 PDACVSS.t232 PDACVSS.t225 sg13_hv_nmos ad=0.408p pd=3.08u as=0.408p ps=3.08u w=1.2u l=0.6u
X206 a_12980_5491.t15 a_12014_1063# a_13474_923.t15 PDACVSS.t104 sg13_hv_nmos ad=0.408p pd=3.08u as=0.408p ps=3.08u w=1.2u l=0.6u
X207 a_12306_727# a_11732_5491# PDACVSS.t187 PDACVSS.t38 sg13_hv_nmos ad=0.114p pd=0.98u as=0.204p ps=1.88u w=0.6u l=2.4u
X208 PDACVDD.t131 a_12980_5491.t20 ODACOUT.t10 PDACVDD.t0 sg13_hv_pmos ad=0.816p pd=5.48u as=0.816p ps=5.48u w=2.4u l=0.4u
X209 nD7 a_6802_3288# PDACVSS.t198 rhigh l=15u w=0.5u
X210 PDACVSS.t180 a_11732_5491# a_13474_727# PDACVSS.t39 sg13_hv_nmos ad=0.204p pd=1.88u as=0.114p ps=0.98u w=0.6u l=2.4u
X211 a_11732_5491# a_8780_247# a_12306_727# PDACVSS.t38 sg13_hv_nmos ad=0.204p pd=1.88u as=0.114p ps=0.98u w=0.6u l=0.6u
X212 a_8780_247# a_8700_4135# a_11420_5295# PDACVDD.t0 sg13_hv_pmos ad=0.408p pd=3.08u as=0.228p ps=1.58u w=1.2u l=0.6u
X213 PDACVDD.t24 PDACVDD.t22 PDACVDD.t23 PDACVDD.t0 sg13_hv_pmos ad=0.816p pd=5.48u as=0 ps=0 w=2.4u l=0.4u
X214 nD6 a_6010_3288# PDACVSS.t193 rhigh l=15u w=0.5u
X215 ODACOUT.t29 a_12980_5491.t19 PDACVDD.t135 PDACVDD.t0 sg13_hv_pmos ad=0.816p pd=5.48u as=0.816p ps=5.48u w=2.4u l=0.4u
X216 PDACVSS.t81 PDACVSS.t79 PDACVSS.t80 PDACVSS.t73 sg13_hv_nmos ad=0.408p pd=3.08u as=0 ps=0 w=1.2u l=0.45u
X217 PDACVSS.t247 a_13474_923.t20 ODACOUT.t34 PDACVSS.t225 sg13_hv_nmos ad=0.408p pd=3.08u as=0.408p ps=3.08u w=1.2u l=0.6u
X218 PDACVSS.t126 PDACVSS.t124 PDACVSS.t125 PDACVSS.t101 sg13_hv_nmos ad=0.408p pd=3.08u as=0 ps=0 w=1.2u l=0.6u
X219 PDACVSS.t68 PDACVSS.t66 PDACVSS.t67 PDACVSS.t14 sg13_hv_nmos ad=0.816p pd=5.48u as=0 ps=0 w=2.4u l=0.45u
X220 a_13474_727# a_8780_247# a_13474_923.t7 PDACVSS.t42 sg13_hv_nmos ad=0.114p pd=0.98u as=0.204p ps=1.88u w=0.6u l=0.6u
X221 nD5 a_5218_3288# PDACVSS.t13 rhigh l=15u w=0.5u
X222 PDACVDD.t21 PDACVDD.t19 PDACVDD.t20 PDACVDD.t0 sg13_hv_pmos ad=0.816p pd=5.48u as=0 ps=0 w=2.4u l=0.4u
X223 a_7280_4421# op_amp_ver_2_0.IOAM PDACVSS.t200 rhigh l=14u w=0.5u
X224 PDACVSS.t181 a_11732_5491# a_13474_727# PDACVSS.t40 sg13_hv_nmos ad=0.204p pd=1.88u as=0.114p ps=0.98u w=0.6u l=2.4u
X225 a_8700_4135# IDACIREF PDACVSS.t216 PDACVSS.t215 sg13_hv_nmos ad=0.204p pd=1.88u as=0.204p ps=1.88u w=0.6u l=2.4u
X226 a_15606_247# a_15606_247# PDACVSS.t204 PDACVSS.t104 sg13_hv_nmos ad=0.408p pd=3.08u as=0.408p ps=3.08u w=1.2u l=0.6u
X227 PDACVDD.t100 a_8700_4135# PDACVDD.t77 PDACVDD.t0 sg13_hv_pmos ad=0.228p pd=1.58u as=0 ps=0 w=1.2u l=0.6u
X228 ODACOUT.t46 a_13474_923.t19 PDACVSS.t253 PDACVSS.t227 sg13_hv_nmos ad=0.408p pd=3.08u as=0.408p ps=3.08u w=1.2u l=0.6u
X229 PDACVDD.t90 a_10714_5055# PDACVDD.t89 PDACVDD.t0 sg13_hv_pmos ad=0.228p pd=1.58u as=0 ps=0 w=1.2u l=1.2u
X230 ODACOUT.t0 a_12980_5491.t23 PDACVDD.t116 PDACVDD.t0 sg13_hv_pmos ad=0.816p pd=5.48u as=0.816p ps=5.48u w=2.4u l=0.4u
X231 nD4 a_4426_3288# PDACVSS.t6 rhigh l=15u w=0.5u
X232 PDACVSS.t165 a_10180_247# a_10846_727# PDACVSS.t32 sg13_hv_nmos ad=0.204p pd=1.88u as=0.114p ps=0.98u w=0.6u l=2.4u
X233 ODACOUT.t47 a_13474_923.t21 PDACVSS.t239 PDACVSS.t219 sg13_hv_nmos ad=0.408p pd=3.08u as=0.408p ps=3.08u w=1.2u l=0.6u
X234 a_12463_2551# a_8700_4135# a_12980_5491.t5 PDACVDD.t0 sg13_hv_pmos ad=0.228p pd=1.58u as=0.408p ps=3.08u w=1.2u l=0.6u
X235 a_11732_5295# a_10714_5055# PDACVDD.t84 PDACVDD.t0 sg13_hv_pmos ad=0.228p pd=1.58u as=0.408p ps=3.08u w=1.2u l=1.2u
X236 PDACVSS.t255 a_13474_923.t18 ODACOUT.t55 PDACVSS.t221 sg13_hv_nmos ad=0.408p pd=3.08u as=0.408p ps=3.08u w=1.2u l=0.6u
X237 PDACVSS.t236 a_13474_923.t22 ODACOUT.t53 PDACVSS.t223 sg13_hv_nmos ad=0.408p pd=3.08u as=0.408p ps=3.08u w=1.2u l=0.6u
X238 a_12463_2551# a_8700_4135# a_12980_5491.t7 PDACVDD.t0 sg13_hv_pmos ad=0.228p pd=1.58u as=0.408p ps=3.08u w=1.2u l=0.6u
X239 PDACVDD.t77 a_10714_5055# PDACVDD.t76 PDACVDD.t0 sg13_hv_pmos ad=0.408p pd=3.08u as=0 ps=0 w=1.2u l=1.2u
X240 PDACVSS.t45 a_8780_247# PDACVSS.t44 PDACVSS.t43 sg13_hv_nmos ad=0.114p pd=0.98u as=0 ps=0 w=0.6u l=0.6u
X241 PDACVDD.t61 a_10714_5055# a_12463_2551# PDACVDD.t0 sg13_hv_pmos ad=0.408p pd=3.08u as=0.228p ps=1.58u w=1.2u l=1.2u
X242 ODACOUT.t26 a_12980_5491.t19 PDACVDD.t133 PDACVDD.t0 sg13_hv_pmos ad=0.816p pd=5.48u as=0.816p ps=5.48u w=2.4u l=0.4u
X243 PDACVDD.t73 a_10714_5055# a_12463_2551# PDACVDD.t0 sg13_hv_pmos ad=0.408p pd=3.08u as=0.228p ps=1.58u w=1.2u l=1.2u
X244 ODACOUT.t30 a_12980_5491.t19 PDACVDD.t134 PDACVDD.t0 sg13_hv_pmos ad=0.816p pd=5.48u as=0.816p ps=5.48u w=2.4u l=0.4u
X245 PDACVSS.t228 a_13474_923.t24 ODACOUT.t36 PDACVSS.t227 sg13_hv_nmos ad=0.408p pd=3.08u as=0.408p ps=3.08u w=1.2u l=0.6u
X246 PDACVDD.t120 a_12980_5491.t22 ODACOUT.t8 PDACVDD.t0 sg13_hv_pmos ad=0.816p pd=5.48u as=0.816p ps=5.48u w=2.4u l=0.4u
X247 PDACVSS.t59 IDACDISABLE a_12014_1063# PDACVSS.t46 sg13_hv_nmos ad=0.114p pd=0.98u as=0.204p ps=1.88u w=0.6u l=0.6u
X248 PDACVDD.t93 a_8700_4135# a_9008_4067# PDACVDD.t0 sg13_hv_pmos ad=0.34p pd=2.68u as=0.34p ps=2.68u w=1u l=10u
X249 a_12980_5491.t4 a_10262_923# PDACVDD.t2 PDACVDD.t0 sg13_hv_pmos ad=0.408p pd=3.08u as=0.228p ps=1.58u w=1.2u l=0.6u
X250 PDACVDD.t95 a_8700_4135# PDACVDD.t94 PDACVDD.t0 sg13_hv_pmos ad=0.34p pd=2.68u as=0 ps=0 w=1u l=10u
X251 a_466_3288# PDACVSS.t9 PDACVSS.t8 rhigh l=15u w=0.5u
X252 nD3 a_3634_3288# PDACVSS.t52 rhigh l=15u w=0.5u
X253 a_9120_2247# a_8780_247# a_8968_2247# PDACVSS.t24 sg13_hv_nmos ad=0.136p pd=1.48u as=0.136p ps=1.48u w=0.4u l=10u
X254 a_13474_923.t14 a_12014_1063# a_12980_5491.t14 PDACVSS.t104 sg13_hv_nmos ad=0.408p pd=3.08u as=0.408p ps=3.08u w=1.2u l=0.6u
X255 PDACVSS.t235 a_13474_923.t22 ODACOUT.t56 PDACVSS.t221 sg13_hv_nmos ad=0.408p pd=3.08u as=0.408p ps=3.08u w=1.2u l=0.6u
X256 PDACVDD.t137 a_12980_5491.t18 ODACOUT.t4 PDACVDD.t0 sg13_hv_pmos ad=0.816p pd=5.48u as=0.816p ps=5.48u w=2.4u l=0.4u
X257 a_11732_5295# a_10714_5055# PDACVDD.t82 PDACVDD.t0 sg13_hv_pmos ad=0.228p pd=1.58u as=0.408p ps=3.08u w=1.2u l=1.2u
X258 a_8700_4135# a_10262_923# PDACVDD.t3 PDACVDD.t0 sg13_hv_pmos ad=0.408p pd=3.08u as=0.228p ps=1.58u w=1.2u l=0.6u
X259 PDACVDD.t48 PDACVDD.t43 PDACVDD.t47 PDACVDD.t0 sg13_hv_pmos ad=0.816p pd=5.48u as=0 ps=0 w=2.4u l=0.4u
X260 ODACOUT.t31 a_13474_923.t17 PDACVSS.t262 PDACVSS.t225 sg13_hv_nmos ad=0.408p pd=3.08u as=0.408p ps=3.08u w=1.2u l=0.6u
X261 PDACVDD.t90 a_8700_4135# PDACVDD.t105 PDACVDD.t0 sg13_hv_pmos ad=0.408p pd=3.08u as=0 ps=0 w=1.2u l=0.6u
X262 a_11420_5819# a_8700_4135# a_10180_247# PDACVDD.t0 sg13_hv_pmos ad=0.228p pd=1.58u as=0.408p ps=3.08u w=1.2u l=0.6u
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
