ThePil0t/heichips26-FAIfplus/macros/heichips26_FAIf/macros/opamp/netlist/pex/op_amp_ver_2_magic_pex_3.spice

* PEX produced on Thu Oct  8 02:15:53 CEST 2026 using scripts/sak-pex.sh with m=3 and s=1 (extresist threshold=10000 mOhm, minres=1000 mOhm, mindelay=1 ps)
* NGSPICE file created from op_amp_ver_2_pex.ext - technology: ihp-sg13cmos5l

.subckt op_amp_ver_2_pex OOA IOADISABLE IOAIREF POAVSS POAVDD IOAP IOAM
X0 a_848_4062# a_268_4130# a_1120_4062# POAVDD sg13_hv_pmos ad=0.34p pd=2.68u as=0.34p ps=2.68u w=1u l=10u
X1 POAVDD a_4548_5486.t18 OOA POAVDD sg13_hv_pmos ad=0.816p pd=5.48u as=0.816p ps=5.48u w=2.4u l=0.4u
X2 POAVSS.t1 a_348_242# POAVSS.t75 POAVSS.t74 sg13_hv_nmos ad=0.136p pd=1.48u as=0 ps=0 w=0.4u l=10u
X3 POAVSS.t11 a_5042_918.t18 OOA POAVSS.t10 sg13_hv_nmos ad=0.408p pd=3.08u as=0.408p ps=3.08u w=1.2u l=0.6u
X4 POAVDD a_268_4130# POAVDD POAVDD sg13_hv_pmos ad=0.408p pd=3.08u as=0.26442n ps=0.66388m w=1.2u l=0.6u
X5 a_2414_722# a_1748_242# POAVSS.t46 POAVSS.t40 sg13_hv_nmos ad=0.114p pd=0.98u as=0.204p ps=1.88u w=0.6u l=2.4u
X6 a_3300_5486# a_348_242# a_3874_722# POAVSS.t52 sg13_hv_nmos ad=0.204p pd=1.88u as=0.114p ps=0.98u w=0.6u l=0.6u
X7 POAVSS.t23 a_5042_918.t20 OOA POAVSS.t10 sg13_hv_nmos ad=0.408p pd=3.08u as=0.408p ps=3.08u w=1.2u l=0.6u
X8 OOA a_5042_918.t21 POAVSS.t35 POAVSS.t14 sg13_hv_nmos ad=0.408p pd=3.08u as=0.408p ps=3.08u w=1.2u l=0.6u
X9 a_3874_722# a_348_242# a_3300_5486# POAVSS.t50 sg13_hv_nmos ad=0.114p pd=0.98u as=0.204p ps=1.88u w=0.6u l=0.6u
X10 a_4031_2546# a_268_4130# a_4548_5486.t3 POAVDD sg13_hv_pmos ad=0.228p pd=1.58u as=0.408p ps=3.08u w=1.2u l=0.6u
X11 POAVSS.t120 POAVSS.t1 POAVSS.t119 POAVSS.t96 sg13_hv_nmos ad=0.408p pd=3.08u as=0 ps=0 w=1.2u l=0.45u
X12 POAVSS.t5 a_348_242# POAVSS.t5 POAVSS.t4 sg13_hv_nmos ad=0.114p pd=0.98u as=0 ps=0 w=0.6u l=0.6u
X13 POAVDD a_268_4130# POAVDD POAVDD sg13_hv_pmos ad=0.228p pd=1.58u as=0 ps=0 w=1.2u l=0.6u
X14 a_3582_1058# a_3582_1058# a_7174_242# POAVSS.t78 sg13_hv_nmos ad=0.408p pd=3.08u as=0.408p ps=3.08u w=1.2u l=0.6u
X15 POAVSS.t1 a_3300_5486# a_3874_722# POAVSS.t50 sg13_hv_nmos ad=0.204p pd=1.88u as=0.114p ps=0.98u w=0.6u l=2.4u
X16 POAVDD a_2282_5050# a_4031_2546# POAVDD sg13_hv_pmos ad=0.408p pd=3.08u as=0.228p ps=1.58u w=1.2u l=1.2u
X17 a_4031_2546# a_268_4130# a_4548_5486.t0 POAVDD sg13_hv_pmos ad=0.228p pd=1.58u as=0.408p ps=3.08u w=1.2u l=0.6u
X18 a_3300_5290# a_2282_5050# POAVDD POAVDD sg13_hv_pmos ad=0.228p pd=1.58u as=0.408p ps=3.08u w=1.2u l=1.2u
X19 POAVDD a_4548_5486.t18 OOA POAVDD sg13_hv_pmos ad=0.816p pd=5.48u as=0.816p ps=5.48u w=2.4u l=0.4u
X20 POAVSS.t5 POAVSS.t5 POAVSS.t5 POAVSS.t4 sg13_hv_nmos ad=0.204p pd=1.88u as=0 ps=0 w=0.6u l=2.4u
X21 a_3874_722# a_3300_5486# POAVSS.t60 POAVSS.t52 sg13_hv_nmos ad=0.114p pd=0.98u as=0.204p ps=1.88u w=0.6u l=2.4u
X22 POAVDD a_2282_5050# POAVDD POAVDD sg13_hv_pmos ad=0.408p pd=3.08u as=0 ps=0 w=1.2u l=1.2u
X23 a_2988_5814# a_268_4130# a_1748_242# POAVDD sg13_hv_pmos ad=0.228p pd=1.58u as=0.408p ps=3.08u w=1.2u l=0.6u
X24 POAVDD a_4548_5486.t18 OOA POAVDD sg13_hv_pmos ad=0.816p pd=5.48u as=0.816p ps=5.48u w=2.4u l=0.4u
X25 POAVSS.t5 POAVSS.t5 POAVSS.t5 POAVSS.t130 sg13_hv_nmos ad=0.408p pd=3.08u as=0 ps=0 w=1.2u l=0.6u
X26 POAVDD POAVDD POAVDD POAVDD sg13_hv_pmos ad=0.816p pd=5.48u as=0 ps=0 w=2.4u l=0.4u
X27 POAVDD a_2282_5050# a_4031_2546# POAVDD sg13_hv_pmos ad=0.408p pd=3.08u as=0.228p ps=1.58u w=1.2u l=1.2u
X28 POAVDD a_7427_6047# a_7427_6047# POAVDD sg13_hv_pmos ad=0.816p pd=5.48u as=0.816p ps=5.48u w=2.4u l=0.4u
X29 POAVDD a_4548_5486.t18 OOA POAVDD sg13_hv_pmos ad=0.816p pd=5.48u as=0.816p ps=5.48u w=2.4u l=0.4u
X30 POAVDD a_2282_5050# a_2988_5814# POAVDD sg13_hv_pmos ad=0.408p pd=3.08u as=0.228p ps=1.58u w=1.2u l=1.2u
X31 a_4548_5486.t6 a_268_4130# a_4031_2546# POAVDD sg13_hv_pmos ad=0.408p pd=3.08u as=0.228p ps=1.58u w=1.2u l=0.6u
X32 POAVDD POAVDD POAVDD POAVDD sg13_hv_pmos ad=0.816p pd=5.48u as=0 ps=0 w=2.4u l=0.4u
X33 a_1748_242# a_348_242# a_2122_722# POAVSS.t38 sg13_hv_nmos ad=0.204p pd=1.88u as=0.114p ps=0.98u w=0.6u l=0.6u
X34 POAVDD a_4548_5486.t22 OOA POAVDD sg13_hv_pmos ad=0.816p pd=5.48u as=0.816p ps=5.48u w=2.4u l=0.4u
X35 a_992_2242# a_348_242# a_840_2242# POAVSS.t72 sg13_hv_nmos ad=0.136p pd=1.48u as=0.136p ps=1.48u w=0.4u l=10u
X36 POAVSS.t1 IOAIREF POAVSS.t1 POAVSS.t94 sg13_hv_nmos ad=0.204p pd=1.88u as=0 ps=0 w=0.6u l=2.4u
X37 POAVSS.t106 POAVSS.t106 POAVSS.t106 POAVSS.t107 sg13_hv_nmos ad=0.408p pd=3.08u as=0 ps=0 w=1.2u l=0.45u
X38 POAVSS.t19 a_5042_918.t24 OOA POAVSS.t12 sg13_hv_nmos ad=0.408p pd=3.08u as=0.408p ps=3.08u w=1.2u l=0.6u
X39 a_576_4062# a_268_4130# a_848_4062# POAVDD sg13_hv_pmos ad=0.34p pd=2.68u as=0.34p ps=2.68u w=1u l=10u
X40 a_3300_5486# a_268_4130# a_3300_5290# POAVDD sg13_hv_pmos ad=0.408p pd=3.08u as=0.228p ps=1.58u w=1.2u l=0.6u
X41 OOA a_5042_918.t17 POAVSS.t178 POAVSS.t8 sg13_hv_nmos ad=0.408p pd=3.08u as=0.408p ps=3.08u w=1.2u l=0.6u
X42 a_3582_918# a_348_242# a_3582_722# POAVSS.t0 sg13_hv_nmos ad=0.204p pd=1.88u as=0.114p ps=0.98u w=0.6u l=0.6u
X43 POAVDD a_268_4130# POAVDD POAVDD sg13_hv_pmos ad=0.408p pd=3.08u as=0 ps=0 w=1.2u l=0.6u
X44 POAVSS.t5 POAVSS.t5 POAVSS.t5 POAVSS.t78 sg13_hv_nmos ad=0.408p pd=3.08u as=0 ps=0 w=1.2u l=0.6u
X45 a_2122_722# a_1748_242# POAVSS.t44 POAVSS.t38 sg13_hv_nmos ad=0.114p pd=0.98u as=0.204p ps=1.88u w=0.6u l=2.4u
X46 POAVDD a_268_4130# POAVDD POAVDD sg13_hv_pmos ad=0.228p pd=1.58u as=0 ps=0 w=1.2u l=0.6u
X47 a_5042_918.t9 a_348_242# a_5042_722# POAVSS.t55 sg13_hv_nmos ad=0.204p pd=1.88u as=0.114p ps=0.98u w=0.6u l=0.6u
X48 POAVDD a_4548_5486.t22 OOA POAVDD sg13_hv_pmos ad=0.816p pd=5.48u as=0.816p ps=5.48u w=2.4u l=0.4u
X49 a_3582_722# a_1748_242# POAVSS.t47 POAVSS.t0 sg13_hv_nmos ad=0.114p pd=0.98u as=0.204p ps=1.88u w=0.6u l=2.4u
X50 POAVDD a_4548_5486.t22 OOA POAVDD sg13_hv_pmos ad=0.816p pd=5.48u as=0.816p ps=5.48u w=2.4u l=0.4u
X51 POAVDD a_2282_5050# POAVDD POAVDD sg13_hv_pmos ad=0.408p pd=3.08u as=0 ps=0 w=1.2u l=1.2u
X52 OOA a_5042_918.t19 POAVSS.t81 POAVSS.t10 sg13_hv_nmos ad=0.408p pd=3.08u as=0.408p ps=3.08u w=1.2u l=0.6u
X53 OOA a_5042_918.t21 POAVSS.t34 POAVSS.t12 sg13_hv_nmos ad=0.408p pd=3.08u as=0.408p ps=3.08u w=1.2u l=0.6u
X54 POAVDD POAVDD POAVDD POAVDD sg13_hv_pmos ad=0.816p pd=5.48u as=0 ps=0 w=2.4u l=0.4u
X55 POAVDD a_4548_5486.t22 OOA POAVDD sg13_hv_pmos ad=0.816p pd=5.48u as=0.816p ps=5.48u w=2.4u l=0.4u
X56 POAVSS.t13 a_5042_918.t18 OOA POAVSS.t12 sg13_hv_nmos ad=0.408p pd=3.08u as=0.408p ps=3.08u w=1.2u l=0.6u
X57 POAVSS.t5 POAVSS.t5 POAVSS.t5 POAVSS.t130 sg13_hv_nmos ad=0.408p pd=3.08u as=0 ps=0 w=1.2u l=0.6u
X58 a_5042_722# a_3300_5486# POAVSS.t60 POAVSS.t55 sg13_hv_nmos ad=0.114p pd=0.98u as=0.204p ps=1.88u w=0.6u l=2.4u
X59 a_5042_722# a_348_242# a_5042_918.t5 POAVSS.t55 sg13_hv_nmos ad=0.114p pd=0.98u as=0.204p ps=1.88u w=0.6u l=0.6u
X60 a_2414_918# IOAM a_3300_5290# POAVSS.t103 sg13_hv_nmos ad=0.816p pd=5.48u as=0.816p ps=5.48u w=2.4u l=0.45u
X61 POAVDD a_2282_5050# POAVDD POAVDD sg13_hv_pmos ad=0.228p pd=1.58u as=0 ps=0 w=1.2u l=1.2u
X62 a_348_242# a_348_242# a_992_2242# POAVSS.t73 sg13_hv_nmos ad=0.136p pd=1.48u as=0.136p ps=1.48u w=0.4u l=10u
X63 POAVSS.t1 a_3300_5486# a_5042_722# POAVSS.t55 sg13_hv_nmos ad=0.204p pd=1.88u as=0.114p ps=0.98u w=0.6u l=2.4u
X64 a_5042_918.t14 a_3582_1058# a_4548_5486.t15 POAVSS.t78 sg13_hv_nmos ad=0.408p pd=3.08u as=0.408p ps=3.08u w=1.2u l=0.6u
X65 POAVDD POAVDD POAVDD POAVDD sg13_hv_pmos ad=0.816p pd=5.48u as=0 ps=0 w=2.4u l=0.4u
X66 a_4548_5486.t9 a_3582_918# a_5042_918.t1 POAVDD sg13_hv_pmos ad=0.816p pd=5.48u as=0.816p ps=5.48u w=2.4u l=0.4u
X67 POAVSS.t152 POAVSS.t152 POAVSS.t153 POAVSS.t137 sg13_hv_nmos ad=0.408p pd=3.08u as=0 ps=0 w=1.2u l=0.6u
X68 POAVDD a_1830_918# a_3582_918# POAVDD sg13_hv_pmos ad=0.228p pd=1.58u as=0.408p ps=3.08u w=1.2u l=0.6u
X69 POAVDD a_4548_5486.t18 OOA POAVDD sg13_hv_pmos ad=0.816p pd=5.48u as=0.816p ps=5.48u w=2.4u l=0.4u
X70 a_2414_722# a_348_242# a_2414_918# POAVSS.t40 sg13_hv_nmos ad=0.114p pd=0.98u as=0.204p ps=1.88u w=0.6u l=0.6u
X71 POAVDD a_4548_5486.t24 OOA POAVDD sg13_hv_pmos ad=0.816p pd=5.48u as=0.816p ps=5.48u w=2.4u l=0.4u
X72 OOA a_5042_918.t23 POAVSS.t86 POAVSS.t10 sg13_hv_nmos ad=0.408p pd=3.08u as=0.408p ps=3.08u w=1.2u l=0.6u
X73 a_5042_722# a_348_242# a_5042_918.t6 POAVSS.t56 sg13_hv_nmos ad=0.114p pd=0.98u as=0.204p ps=1.88u w=0.6u l=0.6u
X74 POAVSS.t102 POAVSS.t99 POAVSS.t101 POAVSS.t100 sg13_hv_nmos ad=0.816p pd=5.48u as=0 ps=0 w=2.4u l=0.45u
X75 a_4548_5486.t16 a_1830_918# POAVDD POAVDD sg13_hv_pmos ad=0.408p pd=3.08u as=0.228p ps=1.58u w=1.2u l=0.6u
X76 POAVSS.t1 a_1748_242# a_2414_722# POAVSS.t40 sg13_hv_nmos ad=0.204p pd=1.88u as=0.114p ps=0.98u w=0.6u l=2.4u
X77 POAVSS.t1 a_3300_5486# a_5042_722# POAVSS.t56 sg13_hv_nmos ad=0.204p pd=1.88u as=0.114p ps=0.98u w=0.6u l=2.4u
X78 a_4031_2546# a_2282_5050# POAVDD POAVDD sg13_hv_pmos ad=0.228p pd=1.58u as=0.408p ps=3.08u w=1.2u l=1.2u
X79 POAVSS.t152 POAVSS.t152 POAVSS.t161 POAVSS.t137 sg13_hv_nmos ad=0.408p pd=3.08u as=0 ps=0 w=1.2u l=0.6u
X80 a_4548_5486.t5 a_268_4130# a_4031_2546# POAVDD sg13_hv_pmos ad=0.408p pd=3.08u as=0.228p ps=1.58u w=1.2u l=0.6u
X81 a_5042_918.t12 a_348_242# a_5042_722# POAVSS.t58 sg13_hv_nmos ad=0.204p pd=1.88u as=0.114p ps=0.98u w=0.6u l=0.6u
X82 a_3300_5486# a_348_242# a_3874_722# POAVSS.t51 sg13_hv_nmos ad=0.204p pd=1.88u as=0.114p ps=0.98u w=0.6u l=0.6u
X83 POAVSS.t1 POAVSS.t1 POAVSS.t1 POAVSS.t96 sg13_hv_nmos ad=0.408p pd=3.08u as=0 ps=0 w=1.2u l=0.45u
X84 POAVSS.t135 POAVSS.t5 POAVSS.t5 POAVSS.t78 sg13_hv_nmos ad=0.408p pd=3.08u as=0 ps=0 w=1.2u l=0.6u
X85 a_3300_5290# a_2282_5050# POAVDD POAVDD sg13_hv_pmos ad=0.228p pd=1.58u as=0.408p ps=3.08u w=1.2u l=1.2u
X86 POAVDD a_4548_5486.t24 OOA POAVDD sg13_hv_pmos ad=0.816p pd=5.48u as=0.816p ps=5.48u w=2.4u l=0.4u
X87 a_5042_722# a_348_242# a_5042_918.t7 POAVSS.t57 sg13_hv_nmos ad=0.114p pd=0.98u as=0.204p ps=1.88u w=0.6u l=0.6u
X88 a_3300_5486# a_268_4130# a_3300_5290# POAVDD sg13_hv_pmos ad=0.408p pd=3.08u as=0.228p ps=1.58u w=1.2u l=0.6u
X89 POAVDD a_4548_5486.t24 OOA POAVDD sg13_hv_pmos ad=0.816p pd=5.48u as=0.816p ps=5.48u w=2.4u l=0.4u
X90 a_688_2242# a_348_242# a_536_2242# POAVSS.t70 sg13_hv_nmos ad=0.136p pd=1.48u as=0.136p ps=1.48u w=0.4u l=10u
X91 a_840_2242# a_348_242# a_688_2242# POAVSS.t71 sg13_hv_nmos ad=0.136p pd=1.48u as=0.136p ps=1.48u w=0.4u l=10u
X92 POAVDD a_2282_5050# POAVDD POAVDD sg13_hv_pmos ad=0.228p pd=1.58u as=0 ps=0 w=1.2u l=1.2u
X93 a_3300_5290# a_268_4130# a_3300_5486# POAVDD sg13_hv_pmos ad=0.228p pd=1.58u as=0.408p ps=3.08u w=1.2u l=0.6u
X94 a_7427_6047# a_3582_918# a_3582_918# POAVDD sg13_hv_pmos ad=0.816p pd=5.48u as=0.816p ps=5.48u w=2.4u l=0.4u
X95 POAVSS.t1 a_3300_5486# a_5042_722# POAVSS.t57 sg13_hv_nmos ad=0.204p pd=1.88u as=0.114p ps=0.98u w=0.6u l=2.4u
X96 POAVSS.t15 a_5042_918.t18 OOA POAVSS.t14 sg13_hv_nmos ad=0.408p pd=3.08u as=0.408p ps=3.08u w=1.2u l=0.6u
X97 a_5042_722# a_3300_5486# POAVSS.t60 POAVSS.t58 sg13_hv_nmos ad=0.114p pd=0.98u as=0.204p ps=1.88u w=0.6u l=2.4u
X98 a_3874_722# a_3300_5486# POAVSS.t54 POAVSS.t51 sg13_hv_nmos ad=0.114p pd=0.98u as=0.204p ps=1.88u w=0.6u l=2.4u
X99 POAVDD POAVDD POAVDD POAVDD sg13_hv_pmos ad=0.816p pd=5.48u as=0 ps=0 w=2.4u l=0.4u
X100 POAVDD a_4548_5486.t24 OOA POAVDD sg13_hv_pmos ad=0.816p pd=5.48u as=0.816p ps=5.48u w=2.4u l=0.4u
X101 POAVDD a_4548_5486.t22 OOA POAVDD sg13_hv_pmos ad=0.816p pd=5.48u as=0.816p ps=5.48u w=2.4u l=0.4u
X102 POAVDD a_2282_5050# a_3300_5290# POAVDD sg13_hv_pmos ad=0.408p pd=3.08u as=0.228p ps=1.58u w=1.2u l=1.2u
X103 POAVDD POAVDD POAVDD POAVDD sg13_hv_pmos ad=0.816p pd=5.48u as=0 ps=0 w=2.4u l=0.4u
X104 POAVDD IOADISABLE a_1830_918# POAVDD sg13_hv_pmos ad=0.228p pd=1.58u as=0.408p ps=3.08u w=1.2u l=0.6u
X105 OOA a_5042_918.t19 POAVSS.t82 POAVSS.t12 sg13_hv_nmos ad=0.408p pd=3.08u as=0.408p ps=3.08u w=1.2u l=0.6u
X106 POAVSS.t132 POAVSS.t5 POAVSS.t5 POAVSS.t130 sg13_hv_nmos ad=0.408p pd=3.08u as=0 ps=0 w=1.2u l=0.6u
X107 a_5042_918.t16 a_3582_1058# a_4548_5486.t13 POAVSS.t78 sg13_hv_nmos ad=0.408p pd=3.08u as=0.408p ps=3.08u w=1.2u l=0.6u
X108 POAVSS.t27 a_5042_918.t22 OOA POAVSS.t8 sg13_hv_nmos ad=0.408p pd=3.08u as=0.408p ps=3.08u w=1.2u l=0.6u
X109 a_5042_722# a_348_242# a_5042_918.t8 POAVSS.t58 sg13_hv_nmos ad=0.114p pd=0.98u as=0.204p ps=1.88u w=0.6u l=0.6u
X110 POAVSS.t90 IOAIREF POAVSS.t1 POAVSS.t38 sg13_hv_nmos ad=0.204p pd=1.88u as=0 ps=0 w=0.6u l=2.4u
X111 a_268_4130# a_1830_918# POAVDD POAVDD sg13_hv_pmos ad=0.408p pd=3.08u as=0.228p ps=1.58u w=1.2u l=0.6u
X112 a_3300_5486# a_268_4130# a_3300_5290# POAVDD sg13_hv_pmos ad=0.408p pd=3.08u as=0.228p ps=1.58u w=1.2u l=0.6u
X113 OOA a_4548_5486.t21 POAVDD POAVDD sg13_hv_pmos ad=0.816p pd=5.48u as=0.816p ps=5.48u w=2.4u l=0.4u
X114 POAVSS.t1 a_3300_5486# a_5042_722# POAVSS.t58 sg13_hv_nmos ad=0.204p pd=1.88u as=0.114p ps=0.98u w=0.6u l=2.4u
X115 a_3300_5290# IOAM a_2414_918# POAVSS.t100 sg13_hv_nmos ad=0.816p pd=5.48u as=0.816p ps=5.48u w=2.4u l=0.45u
X116 a_2414_918# a_348_242# a_2414_722# POAVSS.t41 sg13_hv_nmos ad=0.204p pd=1.88u as=0.114p ps=0.98u w=0.6u l=0.6u
X117 POAVSS.t172 POAVSS.t5 POAVSS.t5 POAVSS.t130 sg13_hv_nmos ad=0.408p pd=3.08u as=0 ps=0 w=1.2u l=0.6u
X118 a_3874_722# a_348_242# a_3300_5486# POAVSS.t51 sg13_hv_nmos ad=0.114p pd=0.98u as=0.204p ps=1.88u w=0.6u l=0.6u
X119 POAVDD POAVDD POAVDD POAVDD sg13_hv_pmos ad=0.816p pd=5.48u as=0 ps=0 w=2.4u l=0.4u
X120 POAVSS.t22 a_5042_918.t20 OOA POAVSS.t8 sg13_hv_nmos ad=0.408p pd=3.08u as=0.408p ps=3.08u w=1.2u l=0.6u
X121 POAVSS.t1 IOADISABLE IOAIREF POAVSS.t2 sg13_hv_nmos ad=0.114p pd=0.98u as=0.204p ps=1.88u w=0.6u l=0.6u
X122 POAVSS.t18 a_5042_918.t24 OOA POAVSS.t10 sg13_hv_nmos ad=0.408p pd=3.08u as=0.408p ps=3.08u w=1.2u l=0.6u
X123 POAVSS.t5 POAVSS.t5 POAVSS.t5 POAVSS.t130 sg13_hv_nmos ad=0.408p pd=3.08u as=0 ps=0 w=1.2u l=0.6u
X124 POAVSS.t1 a_3300_5486# a_3874_722# POAVSS.t51 sg13_hv_nmos ad=0.204p pd=1.88u as=0.114p ps=0.98u w=0.6u l=2.4u
X125 POAVSS.t7 a_5042_918.t18 OOA POAVSS.t6 sg13_hv_nmos ad=0.408p pd=3.08u as=0.408p ps=3.08u w=1.2u l=0.6u
X126 POAVSS.t26 a_5042_918.t22 OOA POAVSS.t6 sg13_hv_nmos ad=0.408p pd=3.08u as=0.408p ps=3.08u w=1.2u l=0.6u
X127 a_2414_722# a_1748_242# POAVSS.t46 POAVSS.t41 sg13_hv_nmos ad=0.114p pd=0.98u as=0.204p ps=1.88u w=0.6u l=2.4u
X128 OOA a_4548_5486.t21 POAVDD POAVDD sg13_hv_pmos ad=0.816p pd=5.48u as=0.816p ps=5.48u w=2.4u l=0.4u
X129 POAVSS.t1 a_1748_242# POAVSS.t1 POAVSS.t2 sg13_hv_nmos ad=0.204p pd=1.88u as=0 ps=0 w=0.6u l=2.4u
X130 POAVDD a_268_4130# a_576_4062# POAVDD sg13_hv_pmos ad=0.34p pd=2.68u as=0.34p ps=2.68u w=1u l=10u
X131 OOA a_4548_5486.t21 POAVDD POAVDD sg13_hv_pmos ad=0.816p pd=5.48u as=0.816p ps=5.48u w=2.4u l=0.4u
X132 POAVSS.t152 POAVSS.t152 POAVSS.t169 POAVSS.t137 sg13_hv_nmos ad=0.408p pd=3.08u as=0 ps=0 w=1.2u l=0.6u
X133 POAVDD POAVDD POAVDD POAVDD sg13_hv_pmos ad=0.816p pd=5.48u as=0 ps=0 w=2.4u l=0.4u
X134 a_5042_918.t2 a_3582_918# a_4548_5486.t10 POAVDD sg13_hv_pmos ad=0.816p pd=5.48u as=0.816p ps=5.48u w=2.4u l=0.4u
X135 POAVSS.t109 POAVSS.t106 POAVSS.t108 POAVSS.t107 sg13_hv_nmos ad=0.408p pd=3.08u as=0 ps=0 w=1.2u l=0.45u
X136 OOA a_4548_5486.t21 POAVDD POAVDD sg13_hv_pmos ad=0.816p pd=5.48u as=0.816p ps=5.48u w=2.4u l=0.4u
X137 a_3874_722# a_348_242# a_3300_5486# POAVSS.t52 sg13_hv_nmos ad=0.114p pd=0.98u as=0.204p ps=1.88u w=0.6u l=0.6u
X138 a_5796_5814# a_268_4130# a_3582_1058# POAVDD sg13_hv_pmos ad=0.228p pd=1.58u as=0.408p ps=3.08u w=1.2u l=0.6u
X139 a_4031_2546# a_2282_5050# POAVDD POAVDD sg13_hv_pmos ad=0.228p pd=1.58u as=0.408p ps=3.08u w=1.2u l=1.2u
X140 POAVDD POAVDD POAVDD POAVDD sg13_hv_pmos ad=0.816p pd=5.48u as=0 ps=0 w=2.4u l=0.4u
X141 POAVSS.t21 a_5042_918.t20 OOA POAVSS.t6 sg13_hv_nmos ad=0.408p pd=3.08u as=0.408p ps=3.08u w=1.2u l=0.6u
X142 POAVSS.t30 a_5042_918.t22 OOA POAVSS.t14 sg13_hv_nmos ad=0.408p pd=3.08u as=0.408p ps=3.08u w=1.2u l=0.6u
X143 OOA a_4548_5486.t23 POAVDD POAVDD sg13_hv_pmos ad=0.816p pd=5.48u as=0.816p ps=5.48u w=2.4u l=0.4u
X144 OOA a_5042_918.t21 POAVSS.t33 POAVSS.t10 sg13_hv_nmos ad=0.408p pd=3.08u as=0.408p ps=3.08u w=1.2u l=0.6u
X145 POAVDD a_4548_5486.t24 OOA POAVDD sg13_hv_pmos ad=0.816p pd=5.48u as=0.816p ps=5.48u w=2.4u l=0.4u
X146 POAVSS.t68 a_348_242# POAVSS.t67 POAVSS.t66 sg13_hv_nmos ad=0.136p pd=1.48u as=0 ps=0 w=0.4u l=10u
X147 POAVSS.t1 a_3300_5486# a_3874_722# POAVSS.t52 sg13_hv_nmos ad=0.204p pd=1.88u as=0.114p ps=0.98u w=0.6u l=2.4u
X148 OOA a_5042_918.t19 POAVSS.t83 POAVSS.t14 sg13_hv_nmos ad=0.408p pd=3.08u as=0.408p ps=3.08u w=1.2u l=0.6u
X149 POAVDD a_2282_5050# a_5796_5814# POAVDD sg13_hv_pmos ad=0.408p pd=3.08u as=0.228p ps=1.58u w=1.2u l=1.2u
X150 a_3300_5290# a_2282_5050# POAVDD POAVDD sg13_hv_pmos ad=0.228p pd=1.58u as=0.408p ps=3.08u w=1.2u l=1.2u
X151 POAVSS.t144 POAVSS.t144 POAVSS.t145 POAVSS.t137 sg13_hv_nmos ad=0.408p pd=3.08u as=0 ps=0 w=1.2u l=0.6u
X152 OOA a_5042_918.t17 POAVSS.t179 POAVSS.t10 sg13_hv_nmos ad=0.408p pd=3.08u as=0.408p ps=3.08u w=1.2u l=0.6u
X153 a_2414_918# a_348_242# a_2414_722# POAVSS.t39 sg13_hv_nmos ad=0.204p pd=1.88u as=0.114p ps=0.98u w=0.6u l=0.6u
X154 a_4548_5486.t11 a_3582_918# a_5042_918.t3 POAVDD sg13_hv_pmos ad=0.816p pd=5.48u as=0.816p ps=5.48u w=2.4u l=0.4u
X155 a_2282_5050# IOAIREF POAVSS.t1 POAVSS.t93 sg13_hv_nmos ad=0.204p pd=1.88u as=0.204p ps=1.88u w=0.6u l=2.4u
X156 POAVDD a_268_4130# POAVDD POAVDD sg13_hv_pmos ad=0.34p pd=2.68u as=0 ps=0 w=1u l=10u
X157 a_536_2242# a_348_242# POAVSS.t67 POAVSS.t69 sg13_hv_nmos ad=0.136p pd=1.48u as=0.136p ps=1.48u w=0.4u l=10u
X158 POAVSS.t25 a_5042_918.t20 OOA POAVSS.t14 sg13_hv_nmos ad=0.408p pd=3.08u as=0.408p ps=3.08u w=1.2u l=0.6u
X159 a_4548_5486.t7 a_268_4130# a_4031_2546# POAVDD sg13_hv_pmos ad=0.408p pd=3.08u as=0.228p ps=1.58u w=1.2u l=0.6u
X160 POAVDD a_268_4130# POAVDD POAVDD sg13_hv_pmos ad=0.408p pd=3.08u as=0 ps=0 w=1.2u l=0.6u
X161 OOA a_4548_5486.t23 POAVDD POAVDD sg13_hv_pmos ad=0.816p pd=5.48u as=0.816p ps=5.48u w=2.4u l=0.4u
X162 POAVDD POAVDD POAVDD POAVDD sg13_hv_pmos ad=0.816p pd=5.48u as=0 ps=0 w=2.4u l=0.4u
X163 a_7174_242# a_7174_242# POAVSS.t176 POAVSS.t78 sg13_hv_nmos ad=0.408p pd=3.08u as=0.408p ps=3.08u w=1.2u l=0.6u
X164 a_2414_722# a_1748_242# POAVSS.t46 POAVSS.t39 sg13_hv_nmos ad=0.114p pd=0.98u as=0.204p ps=1.88u w=0.6u l=2.4u
X165 POAVDD a_268_4130# POAVDD POAVDD sg13_hv_pmos ad=0.34p pd=2.68u as=0 ps=0 w=1u l=10u
X166 a_4031_2546# a_268_4130# a_4548_5486.t2 POAVDD sg13_hv_pmos ad=0.228p pd=1.58u as=0.408p ps=3.08u w=1.2u l=0.6u
X167 OOA a_4548_5486.t23 POAVDD POAVDD sg13_hv_pmos ad=0.816p pd=5.48u as=0.816p ps=5.48u w=2.4u l=0.4u
X168 POAVSS.t105 POAVSS.t99 POAVSS.t104 POAVSS.t103 sg13_hv_nmos ad=0.816p pd=5.48u as=0 ps=0 w=2.4u l=0.45u
X169 a_4548_5486.t4 a_268_4130# a_4031_2546# POAVDD sg13_hv_pmos ad=0.408p pd=3.08u as=0.228p ps=1.58u w=1.2u l=0.6u
X170 OOA a_4548_5486.t23 POAVDD POAVDD sg13_hv_pmos ad=0.816p pd=5.48u as=0.816p ps=5.48u w=2.4u l=0.4u
X171 a_5042_918.t11 a_348_242# a_5042_722# POAVSS.t57 sg13_hv_nmos ad=0.204p pd=1.88u as=0.114p ps=0.98u w=0.6u l=0.6u
X172 POAVDD a_2282_5050# a_4031_2546# POAVDD sg13_hv_pmos ad=0.408p pd=3.08u as=0.228p ps=1.58u w=1.2u l=1.2u
X173 a_3300_5290# a_268_4130# a_3300_5486# POAVDD sg13_hv_pmos ad=0.228p pd=1.58u as=0.408p ps=3.08u w=1.2u l=0.6u
X174 a_348_242# a_268_4130# a_2988_5290# POAVDD sg13_hv_pmos ad=0.408p pd=3.08u as=0.228p ps=1.58u w=1.2u l=0.6u
X175 a_3300_5290# a_2282_5050# POAVDD POAVDD sg13_hv_pmos ad=0.228p pd=1.58u as=0.408p ps=3.08u w=1.2u l=1.2u
X176 POAVDD POAVDD POAVDD POAVDD sg13_hv_pmos ad=0.816p pd=5.48u as=0 ps=0 w=2.4u l=0.4u
X177 OOA a_4548_5486.t17 POAVDD POAVDD sg13_hv_pmos ad=0.816p pd=5.48u as=0.816p ps=5.48u w=2.4u l=0.4u
X178 POAVSS.t9 a_5042_918.t18 OOA POAVSS.t8 sg13_hv_nmos ad=0.408p pd=3.08u as=0.408p ps=3.08u w=1.2u l=0.6u
X179 a_2676_5814# a_268_4130# a_2282_5050# POAVDD sg13_hv_pmos ad=0.228p pd=1.58u as=0.408p ps=3.08u w=1.2u l=0.6u
X180 POAVDD a_2282_5050# a_3300_5290# POAVDD sg13_hv_pmos ad=0.408p pd=3.08u as=0.228p ps=1.58u w=1.2u l=1.2u
X181 POAVDD POAVDD POAVDD POAVDD sg13_hv_pmos ad=0.816p pd=5.48u as=0 ps=0 w=2.4u l=0.4u
X182 POAVSS.t106 POAVSS.t106 POAVSS.t106 POAVSS.t107 sg13_hv_nmos ad=0.408p pd=3.08u as=0 ps=0 w=1.2u l=0.45u
X183 POAVSS.t123 POAVSS.t1 POAVSS.t122 POAVSS.t100 sg13_hv_nmos ad=0.816p pd=5.48u as=0 ps=0 w=2.4u l=0.45u
X184 OOA a_5042_918.t19 POAVSS.t7 POAVSS.t6 sg13_hv_nmos ad=0.408p pd=3.08u as=0.408p ps=3.08u w=1.2u l=0.6u
X185 a_5042_722# a_3300_5486# POAVSS.t60 POAVSS.t57 sg13_hv_nmos ad=0.114p pd=0.98u as=0.204p ps=1.88u w=0.6u l=2.4u
X186 POAVDD a_2282_5050# a_2676_5814# POAVDD sg13_hv_pmos ad=0.408p pd=3.08u as=0.228p ps=1.58u w=1.2u l=1.2u
X187 POAVSS.t152 POAVSS.t152 POAVSS.t165 POAVSS.t137 sg13_hv_nmos ad=0.408p pd=3.08u as=0 ps=0 w=1.2u l=0.6u
X188 a_1830_918# IOADISABLE POAVSS.t1 POAVSS.t2 sg13_hv_nmos ad=0.204p pd=1.88u as=0.114p ps=0.98u w=0.6u l=0.6u
X189 POAVDD a_4548_5486.t20 OOA POAVDD sg13_hv_pmos ad=0.816p pd=5.48u as=0.816p ps=5.48u w=2.4u l=0.4u
X190 OOA a_4548_5486.t21 POAVDD POAVDD sg13_hv_pmos ad=0.816p pd=5.48u as=0.816p ps=5.48u w=2.4u l=0.4u
X191 OOA a_4548_5486.t17 POAVDD POAVDD sg13_hv_pmos ad=0.816p pd=5.48u as=0.816p ps=5.48u w=2.4u l=0.4u
X192 POAVSS.t29 a_5042_918.t22 OOA POAVSS.t12 sg13_hv_nmos ad=0.408p pd=3.08u as=0.408p ps=3.08u w=1.2u l=0.6u
X193 OOA a_4548_5486.t17 POAVDD POAVDD sg13_hv_pmos ad=0.816p pd=5.48u as=0.816p ps=5.48u w=2.4u l=0.4u
X194 OOA a_5042_918.t23 POAVSS.t85 POAVSS.t8 sg13_hv_nmos ad=0.408p pd=3.08u as=0.408p ps=3.08u w=1.2u l=0.6u
X195 POAVDD a_268_4130# POAVDD POAVDD sg13_hv_pmos ad=0.408p pd=3.08u as=0 ps=0 w=1.2u l=0.6u
X196 POAVDD POAVDD POAVDD POAVDD sg13_hv_pmos ad=0.816p pd=5.48u as=0 ps=0 w=2.4u l=0.4u
X197 POAVSS.t98 POAVSS.t95 POAVSS.t97 POAVSS.t96 sg13_hv_nmos ad=0.408p pd=3.08u as=0 ps=0 w=1.2u l=0.45u
X198 POAVSS.t1 a_1748_242# POAVSS.t1 POAVSS.t2 sg13_hv_nmos ad=0.114p pd=0.98u as=0 ps=0 w=0.6u l=2.4u
X199 OOA a_4548_5486.t17 POAVDD POAVDD sg13_hv_pmos ad=0.816p pd=5.48u as=0.816p ps=5.48u w=2.4u l=0.4u
X200 POAVDD POAVDD POAVDD POAVDD sg13_hv_pmos ad=0.816p pd=5.48u as=0 ps=0 w=2.4u l=0.4u
X201 IOAIREF IOAIREF POAVSS.t1 POAVSS.t91 sg13_hv_nmos ad=0.204p pd=1.88u as=0.204p ps=1.88u w=0.6u l=2.4u
X202 a_3300_5486# a_348_242# a_3874_722# POAVSS.t53 sg13_hv_nmos ad=0.204p pd=1.88u as=0.114p ps=0.98u w=0.6u l=0.6u
X203 POAVDD a_4548_5486.t20 OOA POAVDD sg13_hv_pmos ad=0.816p pd=5.48u as=0.816p ps=5.48u w=2.4u l=0.4u
X204 OOA a_4548_5486.t19 POAVDD POAVDD sg13_hv_pmos ad=0.816p pd=5.48u as=0.816p ps=5.48u w=2.4u l=0.4u
X205 POAVSS.t139 POAVSS.t136 POAVSS.t138 POAVSS.t137 sg13_hv_nmos ad=0.408p pd=3.08u as=0 ps=0 w=1.2u l=0.6u
X206 POAVSS.t24 a_5042_918.t20 OOA POAVSS.t12 sg13_hv_nmos ad=0.408p pd=3.08u as=0.408p ps=3.08u w=1.2u l=0.6u
X207 POAVDD a_4548_5486.t20 OOA POAVDD sg13_hv_pmos ad=0.816p pd=5.48u as=0.816p ps=5.48u w=2.4u l=0.4u
X208 a_4031_2546# IOAP a_2414_918# POAVSS.t103 sg13_hv_nmos ad=0.816p pd=5.48u as=0.816p ps=5.48u w=2.4u l=0.45u
X209 OOA a_5042_918.t17 POAVSS.t180 POAVSS.t12 sg13_hv_nmos ad=0.408p pd=3.08u as=0.408p ps=3.08u w=1.2u l=0.6u
X210 a_5042_918.t0 IOADISABLE POAVSS.t5 POAVSS.t4 sg13_hv_nmos ad=0.204p pd=1.88u as=0.114p ps=0.98u w=0.6u l=0.6u
X211 OOA a_5042_918.t23 POAVSS.t26 POAVSS.t6 sg13_hv_nmos ad=0.408p pd=3.08u as=0.408p ps=3.08u w=1.2u l=0.6u
X212 a_3874_722# a_3300_5486# POAVSS.t60 POAVSS.t53 sg13_hv_nmos ad=0.114p pd=0.98u as=0.204p ps=1.88u w=0.6u l=2.4u
X213 POAVDD POAVDD POAVDD POAVDD sg13_hv_pmos ad=0.816p pd=5.48u as=0 ps=0 w=2.4u l=0.4u
X214 POAVDD a_4548_5486.t20 OOA POAVDD sg13_hv_pmos ad=0.816p pd=5.48u as=0.816p ps=5.48u w=2.4u l=0.4u
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
