ThePil0t/heichips26-FAIfplus/macros/heichips26_FAIf/final/nl/heichips26_FAIf.nl.v

module heichips26_FAIf (analog_0,
    analog_1,
    analog_2,
    clk,
    ena,
    rst_n,
    ui_in,
    uio_in,
    uio_oe,
    uio_out,
    uo_out);
 inout analog_0;
 inout analog_1;
 inout analog_2;
 input clk;
 input ena;
 input rst_n;
 input [7:0] ui_in;
 input [7:0] uio_in;
 output [7:0] uio_oe;
 output [7:0] uio_out;
 output [7:0] uo_out;

 wire _000_;
 wire _001_;
 wire _002_;
 wire _003_;
 wire _004_;
 wire _005_;
 wire _006_;
 wire _007_;
 wire _008_;
 wire _009_;
 wire _010_;
 wire _011_;
 wire _012_;
 wire _013_;
 wire _014_;
 wire _015_;
 wire _016_;
 wire _017_;
 wire _018_;
 wire _019_;
 wire _020_;
 wire _021_;
 wire _022_;
 wire _023_;
 wire _024_;
 wire _025_;
 wire _026_;
 wire _027_;
 wire _028_;
 wire _029_;
 wire _030_;
 wire _031_;
 wire _032_;
 wire _033_;
 wire _034_;
 wire _035_;
 wire _036_;
 wire _037_;
 wire _038_;
 wire _039_;
 wire _040_;
 wire _041_;
 wire _042_;
 wire _043_;
 wire _044_;
 wire _045_;
 wire _046_;
 wire _047_;
 wire _048_;
 wire _049_;
 wire _050_;
 wire _051_;
 wire _052_;
 wire _053_;
 wire _054_;
 wire _055_;
 wire _056_;
 wire _057_;
 wire _058_;
 wire _059_;
 wire _060_;
 wire _061_;
 wire _062_;
 wire _063_;
 wire _064_;
 wire _065_;
 wire _066_;
 wire _067_;
 wire _068_;
 wire _069_;
 wire _070_;
 wire _071_;
 wire _072_;
 wire _073_;
 wire _074_;
 wire _075_;
 wire _076_;
 wire _077_;
 wire net38;
 wire net39;
 wire net40;
 wire net41;
 wire adc_comp;
 wire adc_done;
 wire adc_hold;
 wire adc_tick;
 wire \dac_out[0] ;
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
 sg13cmos5l_decap_8 FILLER_9_74 ();
 sg13cmos5l_decap_8 FILLER_9_81 ();
 sg13cmos5l_decap_8 FILLER_9_88 ();
 sg13cmos5l_decap_8 FILLER_9_95 ();
 sg13cmos5l_or3_1 _082_ (.A(\sar_instance.mask_reg[7] ),
    .B(\sar_instance.mask_reg[6] ),
    .C(\sar_instance.mask_reg[8] ),
    .X(_032_));
 sg13cmos5l_or4_1 _083_ (.A(\sar_instance.mask_reg[3] ),
    .B(\sar_instance.mask_reg[2] ),
    .C(\sar_instance.mask_reg[5] ),
    .D(\sar_instance.mask_reg[4] ),
    .X(_033_));
 sg13cmos5l_nor4_1 _084_ (.A(net101),
    .B(\sar_instance.mask_reg[0] ),
    .C(_032_),
    .D(_033_),
    .Y(adc_done));
 sg13cmos5l_inv_1 _085_ (.Y(adc_hold),
    .A(net25));
 sg13cmos5l_nor2_1 _086_ (.A(net11),
    .B(net10),
    .Y(_034_));
 sg13cmos5l_nor2b_1 _087_ (.A(net10),
    .B_N(net11),
    .Y(_035_));
 sg13cmos5l_nand2b_1 _088_ (.Y(_036_),
    .B(net11),
    .A_N(net10));
 sg13cmos5l_a22oi_1 _089_ (.Y(_037_),
    .B1(net29),
    .B2(net85),
    .A2(net30),
    .A1(\sar_instance.mask_reg[1] ));
 sg13cmos5l_inv_1 _090_ (.Y(\sar_instance.mask_next[1] ),
    .A(net86));
 sg13cmos5l_a22oi_1 _091_ (.Y(_038_),
    .B1(net29),
    .B2(net89),
    .A2(net30),
    .A1(net85));
 sg13cmos5l_inv_1 _092_ (.Y(\sar_instance.mask_next[2] ),
    .A(_038_));
 sg13cmos5l_a22oi_1 _093_ (.Y(_039_),
    .B1(net29),
    .B2(net87),
    .A2(net30),
    .A1(\sar_instance.mask_reg[3] ));
 sg13cmos5l_inv_1 _094_ (.Y(\sar_instance.mask_next[3] ),
    .A(net88));
 sg13cmos5l_a22oi_1 _095_ (.Y(_040_),
    .B1(net29),
    .B2(net83),
    .A2(_034_),
    .A1(\sar_instance.mask_reg[4] ));
 sg13cmos5l_inv_1 _096_ (.Y(\sar_instance.mask_next[4] ),
    .A(net84));
 sg13cmos5l_a22oi_1 _097_ (.Y(_041_),
    .B1(net29),
    .B2(net81),
    .A2(_034_),
    .A1(\sar_instance.mask_reg[5] ));
 sg13cmos5l_inv_1 _098_ (.Y(\sar_instance.mask_next[5] ),
    .A(net82));
 sg13cmos5l_a22oi_1 _099_ (.Y(_042_),
    .B1(net29),
    .B2(net77),
    .A2(net30),
    .A1(net81));
 sg13cmos5l_inv_1 _100_ (.Y(\sar_instance.mask_next[6] ),
    .A(_042_));
 sg13cmos5l_a22oi_1 _101_ (.Y(_043_),
    .B1(net29),
    .B2(net55),
    .A2(net30),
    .A1(net77));
 sg13cmos5l_inv_1 _102_ (.Y(\sar_instance.mask_next[7] ),
    .A(_043_));
 sg13cmos5l_nand2_1 _103_ (.Y(_044_),
    .A(net55),
    .B(net30));
 sg13cmos5l_nand3_1 _104_ (.B(net25),
    .C(net29),
    .A(net12),
    .Y(_045_));
 sg13cmos5l_nand2_1 _105_ (.Y(\sar_instance.mask_next[8] ),
    .A(_044_),
    .B(_045_));
 sg13cmos5l_a22oi_1 _106_ (.Y(_046_),
    .B1(_035_),
    .B2(net90),
    .A2(net30),
    .A1(\sar_instance.mask_reg[0] ));
 sg13cmos5l_inv_1 _107_ (.Y(\sar_instance.mask_next[0] ),
    .A(net91));
 sg13cmos5l_nand3_1 _108_ (.B(_043_),
    .C(_046_),
    .A(_042_),
    .Y(_047_));
 sg13cmos5l_nand4_1 _109_ (.B(_037_),
    .C(_039_),
    .A(\sar_instance.mask_reg[0] ),
    .Y(_048_),
    .D(_040_));
 sg13cmos5l_nand3_1 _110_ (.B(_038_),
    .C(_041_),
    .A(net11),
    .Y(_049_));
 sg13cmos5l_nor3_1 _111_ (.A(_047_),
    .B(_048_),
    .C(_049_),
    .Y(adc_tick));
 sg13cmos5l_nor2_1 _112_ (.A(net12),
    .B(net10),
    .Y(_050_));
 sg13cmos5l_a21o_1 _113_ (.A2(_050_),
    .A1(net25),
    .B1(net30),
    .X(_051_));
 sg13cmos5l_nand2b_1 _114_ (.Y(_052_),
    .B(net83),
    .A_N(adc_comp));
 sg13cmos5l_a21oi_1 _115_ (.A1(net96),
    .A2(_052_),
    .Y(_053_),
    .B1(net81));
 sg13cmos5l_nor3_1 _116_ (.A(net25),
    .B(_036_),
    .C(_053_),
    .Y(_054_));
 sg13cmos5l_a21o_1 _117_ (.A2(_051_),
    .A1(net96),
    .B1(_054_),
    .X(_000_));
 sg13cmos5l_nand2b_1 _118_ (.Y(_055_),
    .B(net81),
    .A_N(adc_comp));
 sg13cmos5l_a21oi_1 _119_ (.A1(net95),
    .A2(_055_),
    .Y(_056_),
    .B1(net77));
 sg13cmos5l_nor3_1 _120_ (.A(net25),
    .B(_036_),
    .C(_056_),
    .Y(_057_));
 sg13cmos5l_a21o_1 _121_ (.A2(_051_),
    .A1(net95),
    .B1(_057_),
    .X(_001_));
 sg13cmos5l_nand2b_1 _122_ (.Y(_058_),
    .B(net77),
    .A_N(adc_comp));
 sg13cmos5l_a21oi_1 _123_ (.A1(net92),
    .A2(_058_),
    .Y(_059_),
    .B1(net55));
 sg13cmos5l_nor3_1 _124_ (.A(net25),
    .B(_036_),
    .C(_059_),
    .Y(_060_));
 sg13cmos5l_a21o_1 _125_ (.A2(_051_),
    .A1(net92),
    .B1(_060_),
    .X(_002_));
 sg13cmos5l_nor2b_1 _126_ (.A(net13),
    .B_N(net14),
    .Y(_061_));
 sg13cmos5l_mux2_1 _127_ (.A0(net66),
    .A1(net2),
    .S(_061_),
    .X(_003_));
 sg13cmos5l_mux2_1 _128_ (.A0(net69),
    .A1(net3),
    .S(_061_),
    .X(_004_));
 sg13cmos5l_mux2_1 _129_ (.A0(net62),
    .A1(net4),
    .S(_061_),
    .X(_005_));
 sg13cmos5l_mux2_1 _130_ (.A0(net58),
    .A1(net5),
    .S(_061_),
    .X(_006_));
 sg13cmos5l_mux2_1 _131_ (.A0(net67),
    .A1(net6),
    .S(_061_),
    .X(_007_));
 sg13cmos5l_mux2_1 _132_ (.A0(net60),
    .A1(net7),
    .S(_061_),
    .X(_008_));
 sg13cmos5l_mux2_1 _133_ (.A0(net64),
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
 sg13cmos5l_buf_1 output15 (.A(net15),
    .X(uio_out[3]));
 sg13cmos5l_buf_1 output16 (.A(net16),
    .X(uio_out[4]));
 sg13cmos5l_buf_1 output17 (.A(net17),
    .X(uo_out[0]));
 sg13cmos5l_buf_1 output18 (.A(net18),
    .X(uo_out[1]));
 sg13cmos5l_buf_1 output19 (.A(net19),
    .X(uo_out[2]));
 sg13cmos5l_buf_1 output20 (.A(net20),
    .X(uo_out[3]));
 sg13cmos5l_buf_1 output21 (.A(net21),
    .X(uo_out[4]));
 sg13cmos5l_buf_1 output22 (.A(net22),
    .X(uo_out[5]));
 sg13cmos5l_buf_1 output23 (.A(net23),
    .X(uo_out[6]));
 sg13cmos5l_buf_1 output24 (.A(net24),
    .X(uo_out[7]));
 assign uio_oe[0] = net41;
 assign uio_oe[1] = net42;
 assign uio_oe[2] = net43;
 assign uio_oe[3] = net53;
 assign uio_oe[4] = net54;
 assign uio_oe[5] = net44;
 assign uio_oe[6] = net45;
 assign uio_oe[7] = net46;
 assign uio_out[0] = net47;
 assign uio_out[1] = net48;
 assign uio_out[2] = net49;
 assign uio_out[5] = net50;
 assign uio_out[6] = net51;
 assign uio_out[7] = net52;
endmodule
