ThePil0t/heichips26-FAIfplus/macros/heichips26_FAIf/final/pnl/heichips26_FAIf.pnl.v

module heichips26_FAIf (analog_0,
    analog_1,
    analog_2,
    clk,
    ena,
    rst_n,
    VPWR,
    VGND,
    VAPWR,
    ui_in,
    uio_in,
    uio_oe,
    uio_out,
    uo_out);
 inout analog_0;
 inout analog_1;
 inout analog_2;
 input clk;
 input ena;
 input rst_n;
 inout VPWR;
 inout VGND;
 inout VAPWR;
 input [7:0] ui_in;
 input [7:0] uio_in;
 output [7:0] uio_oe;
 output [7:0] uio_out;
 output [7:0] uo_out;

 wire _000_;
 wire _001_;
 wire _002_;
 wire _003_;
 wire _004_;
 wire _005_;
 wire _006_;
 wire _007_;
 wire _008_;
 wire _009_;
 wire _010_;
 wire _011_;
 wire _012_;
 wire _013_;
 wire _014_;
 wire _015_;
 wire _016_;
 wire _017_;
 wire _018_;
 wire _019_;
 wire _020_;
 wire _021_;
 wire _022_;
 wire _023_;
 wire _024_;
 wire _025_;
 wire _026_;
 wire _027_;
 wire _028_;
 wire _029_;
 wire _030_;
 wire _031_;
 wire _032_;
 wire _033_;
 wire _034_;
 wire _035_;
 wire _036_;
 wire _037_;
 wire _038_;
 wire _039_;
 wire _040_;
 wire _041_;
 wire _042_;
 wire _043_;
 wire _044_;
 wire _045_;
 wire _046_;
 wire _047_;
 wire _048_;
 wire _049_;
 wire _050_;
 wire _051_;
 wire _052_;
 wire _053_;
 wire _054_;
 wire _055_;
 wire _056_;
 wire _057_;
 wire _058_;
 wire _059_;
 wire _060_;
 wire _061_;
 wire _062_;
 wire _063_;
 wire _064_;
 wire _065_;
 wire _066_;
 wire _067_;
 wire _068_;
 wire _069_;
 wire _070_;
 wire _071_;
 wire _072_;
 wire _073_;
 wire _074_;
 wire _075_;
 wire _076_;
 wire _077_;
 wire net38;
 wire net39;
 wire net40;
 wire net41;
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
    .VSS(VGND));
 sg13cmos5l_decap_8 FILLER_42_7 (.VDD(VPWR),
    .VSS(VGND));
 sg13cmos5l_decap_8 FILLER_42_70 (.VDD(VPWR),
    .VSS(VGND));
 sg13cmos5l_decap_8 FILLER_42_77 (.VDD(VPWR),
    .VSS(VGND));
 sg13cmos5l_decap_8 FILLER_42_84 (.VDD(VPWR),
    .VSS(VGND));
 sg13cmos5l_decap_8 FILLER_42_91 (.VDD(VPWR),
    .VSS(VGND));
 sg13cmos5l_decap_8 FILLER_42_98 (.VDD(VPWR),
    .VSS(VGND));
 sg13cmos5l_decap_8 FILLER_43_102 (.VDD(VPWR),
    .VSS(VGND));
 sg13cmos5l_decap_8 FILLER_43_109 (.VDD(VPWR),
    .VSS(VGND));
 sg13cmos5l_decap_8 FILLER_43_11 (.VDD(VPWR),
    .VSS(VGND));
 sg13cmos5l_decap_8 FILLER_43_116 (.VDD(VPWR),
    .VSS(VGND));
 sg13cmos5l_decap_8 FILLER_43_123 (.VDD(VPWR),
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
