ThePil0t/heichips26-FAIfplus/(commit log)

2026-10-02 sample_and_hold_trim: wire cap_en, add transient/PVT and no-trim comparison testbenches
    DUT (sample_and_hold_trim):
    - Connect cap_en[0..3] to the sw pins of the trim switches x2..x5
    (bit 0 -> C2 12.5x25um, bit 1 -> C3 25x25um, bit 2 -> C4 50x25um,
    bit 3 -> C5 50x25um); they were unconnected before.
    - Add the cap_en[3:0] pin to the symbol (it had 5 pins, the schematic 6).
    - Add the asw_inv library path to the schematic xschemrc.
    Testbenches (testbenches/xschem):
    - sample_and_hold_trim_tb_tran: op_amp_ver_2 unity-gain buffer + S&H +
    comparator load as in heichips26_FAIf.sch, 4 track/hold cycles; measures
    pedestal, droop, feedthrough, acquisition time (1/2 LSB) and tracking
    error per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
    [sample_and_hold_trim.sch, sample_and_hold_trim_tb_tran.sch, sample_and_hold_trim_tb_vs_notrim.sch]
2026-10-02 sample_and_hold_trim: fix C(V) measurement, remove inverter template leftovers
    Fixes
    - tb_vs_notrim: the effective hold capacitance table (*_chold.txt) was
    empty. Cause: savecurrent=true puts a ".save i(vvdda)" into the
    netlist; after "reset" only that save list is active, so the AC plot
    had no v(sh_out_*) vectors and the c_pf expression failed ("invalid").
    Fix: explicit "save v(sh_out_trim) v(sh_out_nmin) v(sh_out_nmax)"
    before the "ac" analysis.
    Nominal check (TT, 27 C, 3.3 V), C(V) at Vhold = 0.5 / 1.65 / 2.8 V:
    trim cap_en=0 0.339 / 0.443 / 0.439 pF
    nmin (C1 only) 0.253 / 0.273 / 0.273 pF
    nmax (C1..C5) 2.919 / 2.940 / 2.939 pF
    trim cap_en=15 3.085 / 3.27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
    [inverter_tb_ac.csv, inverter_tb_ac.sch, inverter_tb_ac_ol.sch, inverter_tb_dc_vout.sch, inverter_tb_tran.sch, sample_and_hold_trim_tb_tran.sch, sample_and_hold_trim_tb_vs_notrim.sch]
2026-10-02 sample_and_hold_trim: add AC testbench and testbench generator scripts
    AC testbench (testbenches/xschem/sample_and_hold_trim_tb_ac.sch)
    - The S&H alone, driven by an ideal source (dc VLEV, ac 1 V) and loaded
    by CLOAD = 20 fF (comparator input). RB = 1 GOhm to VLEV sets the DC
    level of the hold node in hold mode.
    - Loops over cap_en = 0 / 15, levels 0.5 / 1.65 / 2.8 V and both modes
    (ac dec 20 1k 1G); results in simulations/sample_and_hold_trim_tb_ac.txt:
    track: -3 dB bandwidth and gain at 1 MHz
    hold: isolation sh_out/sh_in at 1 / 10 / 100 MHz
    - PVT prepared like the other testbenches (PVT block tokens, ngspice -D
    overrides, pvt_tag file suffix), not run yet.
    - Nominal result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
    [sample_and_hold_trim_tb_ac.sch]
2026-10-02 Add sah_12bit: 12-bit track & hold with re-sized hold cap
    New macro sah_12bit (pin-compatible with sample_and_hold): 1.21 pF MOM hold
    cap sized for +-35% cap spread, 0.6/1.8 um HV transmission gate with buffered
    gate-driver chain. Includes sizing testbenches, archived results, sizing and
    equivalence scripts, figures and the report docs/hold_cap_sizing.md.
    [sah_12bit.sch, sah_12bit_final_tb_tran.sch, sah_12bit_ideal_tb_dc.sch, sah_12bit_ideal_tb_noise.sch, sah_12bit_ideal_tb_tran.sch, sah_12bit_kickback_tb_tran.sch, sah_12bit_opamp_tb_ac.sch, sah_12bit_opamp_tb_dc.sch]
2026-10-04 Add dry-run analogue_interface macro and hook it into LibreLane
    - placement-only macro: existing block GDS + dummies, views in final
    - config: small_analog DEF, macro at (190, 8.82), VAPWR, 1 um vertical halos
    - RTL: macro power pins, inout analog pins, sh_cap_en tied to 0
    Add dry-run analogue_interface macro and hook it into LibreLane
    - placement-only macro: existing block GDS + dummies, views in final/
    - config: small_analog DEF, macro at (190, 8.82), V
2026-10-07 PTAT DRC free, LVS now running but fail, fixed top lvl schem
    [heichips26_FAIf.sch, ptat_curr_gen.sch, tb_ptat_curr_gen.sch]
2026-10-07 sah changed
    [heichips26_FAIf.sch]
2026-10-07 changed ptat for correct currents, plus TB
    [ptat_curr_gen.sch, tb_ptat_curr_gen_startup.sch]
2026-10-08 added ptat schematic after fix startup
    [ptat_curr_gen.sch]
2026-10-08 PTAT layout fisished, plus cells LVS DRC
    [ptat_curr_gen.sch]
2026-10-08 sah_12bit: shielded layout, placed between opamp and comparator
    Cell layout (81.5 x 62.5 um) generated by scripts/layout/gen_sah_12bit_layout.py:
    - hold cap reshaped to 33 x 60 cells (w 54.29 x l 27.72 um, same 1213.8 fF),
    so it fits between the top-level Metal4 PDN strap groups (6.7 um clearance)
    - closed VSS shield box: GatPoly floor, M1-M3 fence with p-tap ring, Metal4 lid
    (29.98 um wide, Slt.c) tied to the MINUS plate
    - transmission gate as shared 4-finger strips (hold-node junction area -45 %),
    SH_OUT as a shielded coax to the PLUS pad, separate driver/cap grounds
    - KLayout DRC regular: density only; Magic DRC 0; KLayout LVS match;
    Magic LVS differs only by C1 (no cap_cmomi extr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
    [sah_12bit.sch, sah_12bit_final_tb_tran.sch]
2026-10-08 all analog blocks DRC and LVS clean, next routing
    [op_amp_ver_2.sch]
2026-10-08 sah_12bit: floorplan v2b, cap one strap slot left, switches beside it
    Cell rework (43.0 x 63.5 um, macro (179.2, 45.5)):
    - hold cap (33 x 60 cells, unchanged 1.214 pF) moved one Metal4 strap slot
    left; the lid's LEF obstruction keeps 10.5 um from the west PDN strap group
    (LibreLane PDN_HORIZONTAL_HALO = 10 um), so that group is no longer cut
    - the coax is gone: SH_OUT is one straight Metal3 spine from the top of the
    PLUS pad (gap in the Metal3 fence) to the pin, between two VSS walls
    - transmission gate, free T-switch reserve and the gate driver (rotated row)
    in a strip left of the cap; SH_IN is a straight riser into the gate,
    3.3 um from the fence with a VSS wall in between; no cr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
    [gen_sah_12bit_layout.py, hybrid_pex.py]
2026-10-08 DACs routed
    [analogue_interface.sch]
2026-10-08 Remove template projects heichips26_analog_project and heichips26_digital_project
    [555_comparator.sch, 555_comparator_tb_tran.sch, 8x_inverting_digital_level_translator.sch, aswitch.sch, aswitch_tb_dc_vout.sch, aswitch_tb_tran.sch, counter_tb_tran.sch, digital_level_translator.sch]
2026-10-08 sah_12bit: floorplan v4, switch and driver on top of the cap, SH_IN pin east
    - Cap (33 x 60 cells, single Metal4 lid) and SH_OUT spine unchanged; the
    mirrored TG sits on the cap east of the spine (trunk straight into it),
    T-switch room east of the TG, gate driver as a row east of that with a
    2-inverter reserve.
    - SH_IN runs along the top edge to an east-edge pin (macro 222.2, 112.25),
    away from the DAC routes; the macro route stays manual (corridor
    x 222.2-232 kept free). SH_EN/VDD keep their west pins and cross the
    spine on Metal1 under a Metal2 VSS plate.
    - Cell 43.0 x 67.0 um; comparator x1 and PTAT x3 moved to y 115.5.
    - hybrid_pex: VSS fragment boxes follow the new walls and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
2026-10-09 full routing ongoing, regenerating top pending Add macro full routing plan (iVREF cap, ADC/PTAT routing)
2026-10-09 analogue_interface: iVREF MOM+HV-MOS cap, full macro routing
    - C1/C2: Metal1/Metal2 MOM cap (~0.75 pF) on a thick-oxide NMOS cap
    (~8 pF) with p-tap ring, extended down to the DAC; schematic updated
    (C1 extracted dims, rotated; C2 sg13_hv_nmos added)
    - route ADC path, PTAT outputs, S&H, opamp, small translators and east
    supplies in macro_routing.route_rest; SH_EN uses one vertical Metal4
    track (x 245) kept clear of the PDN straps, added to the LEF OBS
    - builder checks Metal4 routes (vertical, bands, lid, strap halo)
    - macro KLayout DRC clean (regular deck: density only), LVS matches
    - README: routing section for the full routing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
    [analogue_interface.sch, heichips26_FAIf.sch]
2026-10-09 Fixed routing around ADC in
    [analogue_interface.sch, heichips26_FAIf.sch]
2026-10-09 SAR and top RTL fixes, config register, testbenches (todo C1-C4)
    - comparator polarity: the macro gives adc_comp = 1 when V_dac > V_in,
    so the top feeds ~adc_comp to the SAR (confirmed with ngspice)
    - S&H polarity: SH_EN = 1 tracks; the SAR now outputs sh_en (registered,
    loaded from mask_next, same edge as before), done from the same flip-flop
    - result register and registered tick: tick and the final value appear
    in the same cycle
    - config register cfg (load_config), cfg[3:0] -> sh_cap_en
    - sar_tb: all codes plus cycle-by-cycle equivalence with sar_ref (old SAR)
    - analog behavioral model (ifdef SIM), closed-loop ADC tests in the
    Verilog and cocotb testbenches; cocotb rewritten for he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
    [analogue_interface.sv, heichips26_FAIf.sv, heichips26_FAIf_tb.sv, sar.v, sar_ref.vhdl, sar_tb.vhdl]
2026-10-09 analogue_interface: script the ADC input rework, VGND Metal4 shield
    - routing script reproduces the hand edits of e59578f: DAC1 x11 drives
    analog_0, opamp IOAP goes straight down to analog_2 through a gap in
    the opamp's bottom VGND Metal3 rail (Router.cut on the macro's copy),
    VGND Metal2/Metal3 guard towards analog_1
    - vertical VGND Metal4 shield over guard and IOAP line instead of the
    horizontal bridge that overlapped the PDN strap at x 272.38
    - routing Metal4 follows the lid's strap rules; connectivity check
    treats Metal4 as conductor
    - XOR vs e59578f: only Metal4/Via3 differ; macro DRC clean, LVS matches
    - README: swapped analog pins, ADC input route, Metal4 rule
    Co-Authored-B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
2026-10-09 SDC false paths, make all without counter, README features, SPDX headers
    - impl.sdc / signoff.sdc: false paths from/to analog_0..2 and from rst_n,
    with reasons; macro pins left unconstrained (not STA endpoints).
    STA on RUN_2026-10-09_13-18-52: identical slacks with old and new SDC
    - Makefile: build-macros -> build-analogue-interface, lint-verilog-all
    without the counter, counter targets removed; clean-macros keeps the
    committed analog macro views and reports
    - README: feature list (2x 8-bit DAC, 8-bit SAR ADC with S&H, VAPWR)
    - SPDX: XXX placeholders replaced in the top RTL and testbenches
    - TODO plan: A2, C4 (GL sim, adc_hold STA), F1, F3, G3, G4, G5 trial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
    [heichips26_FAIf.sv, heichips26_FAIf_tb.sv]
2026-10-09 routing fix and houskeeping changes
    [heichips26_FAIf.nl.v, heichips26_FAIf.pnl.v]
2026-10-09 Final top-level views and submission text for the swapped analog pins
    - final/ views (gds, lef, lib, spef, render) and IR-drop report from
    RUN_2026-10-09_14-09-18 (new analogue_interface macro, new RTL)
    - submission.yaml: analog_0 = DAC2 output, analog_1 = DAC1 output,
    analog_2 = ADC input (pin swap of e59578f); team order, repository link
